dmarlowe69/Hayes-Targets/Flight Data Reduction/Excel WorkBook/tlx8.bmp

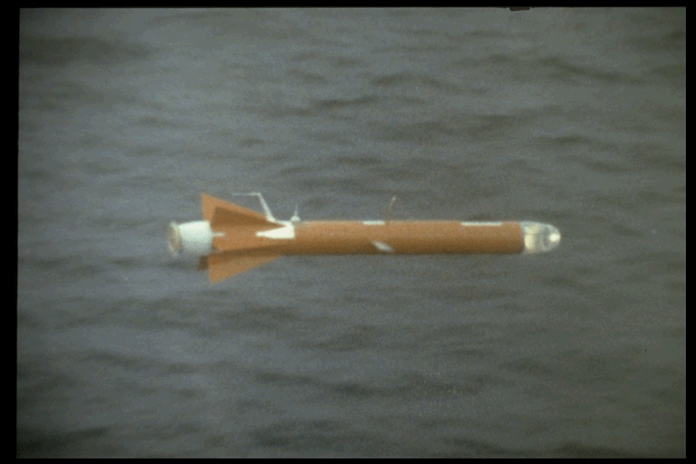
Flight Data Reduction/Excel WorkBook/tlx8.bmp
