dmarlowe69/Hayes-Targets/Quick C/README.md

Cable Design and other utilities written in Microsoft Quick C

Denton Marlowe
November 2016
