dmarlowe69/Hayes-Targets/QBASIC/README.md

Cable Design and other utilities written in Microsoft Quick Basic

Denton Marlowe
November 2016
