dmarlowe69/Hayes-Targets/RCA Boards/README.md

When RCA sold off the COSMAC system to a company called MATRIX
which dropped the line in the early 90's. Hayes Targets was the only
customer for the system so we bought the rights to manufacture the
boards. The CPU, A/D and custom two card back plane are here in old
Gerber (RS-274X) format.

the following link as an online viewer that will work with these files.

http://circuitpeople.com/

Denton Marlowe
November 2016
