dmarlowe69/Hayes-Targets/RCA Boards/AD/2468366/README

ATTN: CIRTECH
FROM: INFINITE GRAPHICS INC.

     HERE IS THE DATA FOR P/N 2468366.  THE DATA IS IN RS274X GERBER
FORMAT.  IF YOU HAVE ANY QUESTIONS PLEASE CALL US. (714)975-0765.
