dmarlowe69/Hayes-Targets/RCA Boards/CPU/2468349/README

ATTN: CIRTECH
FROM: INFINITE GRAPHICS INC.

     HERE IS THE DATA FOR P/N 2468349.   DATA IS IN RS274X GERBER.
IF YOU HAVE ANY QUESTIONS PLEASE CALL US. (714)975-0765.

8349L1   =  LAYER 1
8349L2   =  LAYER 2
8349SM   =  SOLDERMASK
8349SS   =  SILKSCREEN
