dmarlowe69/Hayes-Targets/TLXEXCEL/TLX_DATA_Report.xls

time | hrtime | rebl | alt_dev | fs_alt | ex_alt | wing | aux | accel | batt | rcvy/fly | prog | ok
0 | 0 | 1 | 49.609375 | 1166.666626 | 99.609375 | -8.0625 | 0.097656 | 0.96875 | 28.4375 | 0 | 0 | 0
0.10989 | 0.121429 | 1 | 49.609375 | 1166.666626 | 99.609375 | -8.023438 | 0.097656 | 1.007813 | 28.300781 | 0 | 0 | 1
0.21978 | 0.23441 | 1 | 49.21875 | 1166.666626 | 99.609375 | -8.101563 | 0.097656 | 1.023438 | 28.4375 | 0 | 0 | 1
0.32967 | 0.351177 | 1 | 49.609375 | 1166.666626 | 99.609375 | -8.0625 | 0.097656 | 0.984375 | 28.4375 | 0 | 0 | 1
0.43956 | 0.454081 | 1 | 49.21875 | 1145.833374 | 99.609375 | -8.0625 | 0.097656 | 0.984375 | 28.300781 | 0 | 0 | 0
0.549451 | 0.565154 | 1 | 49.21875 | 1145.833374 | 99.609375 | -8.0625 | 0.097656 | 1 | 28.4375 | 0 | 0 | 0
0.659341 | 0.677065 | 1 | 49.21875 | 1145.833374 | 99.609375 | -8.0625 | 0.117188 | 1.007813 | 28.4375 | 0 | 0 | 0
0.824176 | 0.821932 | 1 | 49.21875 | 1145.833374 | 99.609375 | -8.0625 | 0.117188 | 1 | 28.300781 | 0 | 0 | 1
0.934066 | 0.934156 | 1 | 49.21875 | 1145.833374 | 99.609375 | -8.101563 | 0.097656 | 0.992188 | 28.300781 | 0 | 0 | 1
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
