dmarlowe69/Hayes-Targets/DevPics/HRT2.jpg

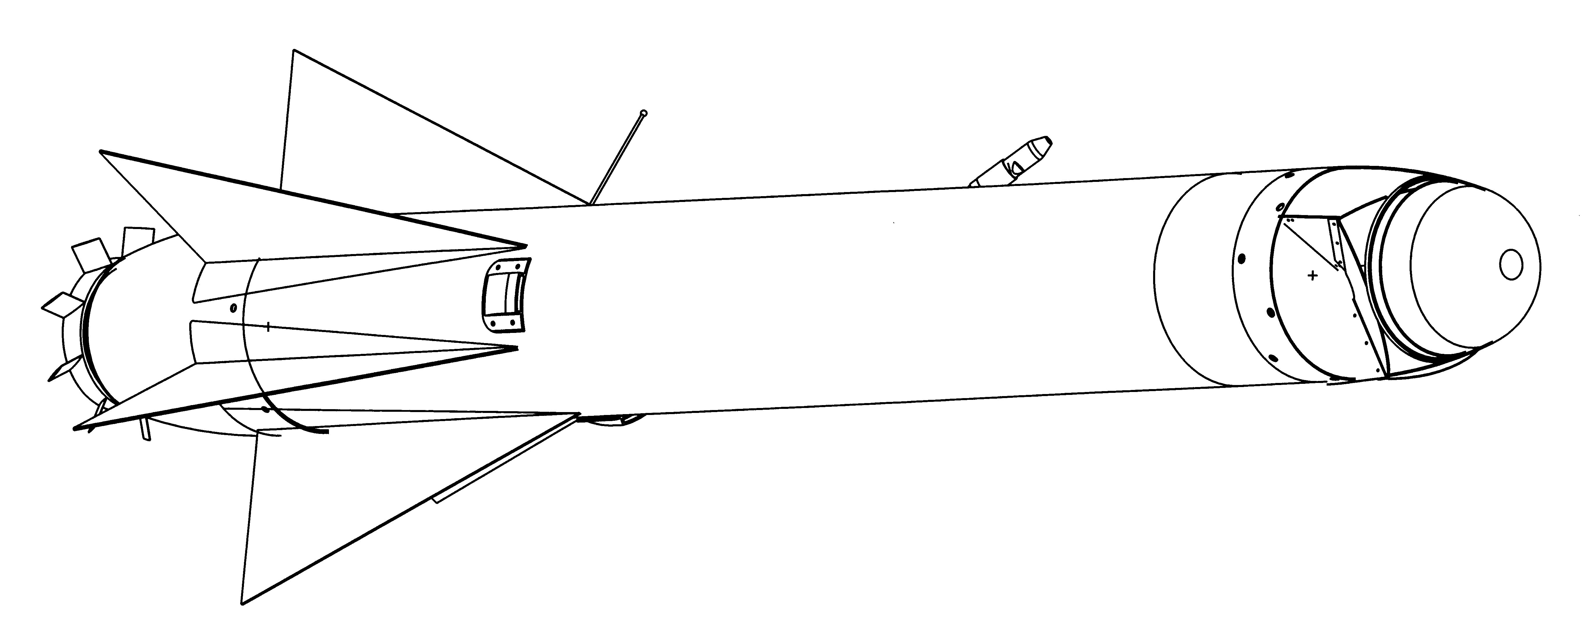
DevPics/HRT2.jpg
