dmarlowe69/Hayes-Targets/DevPics/HRT.jpg

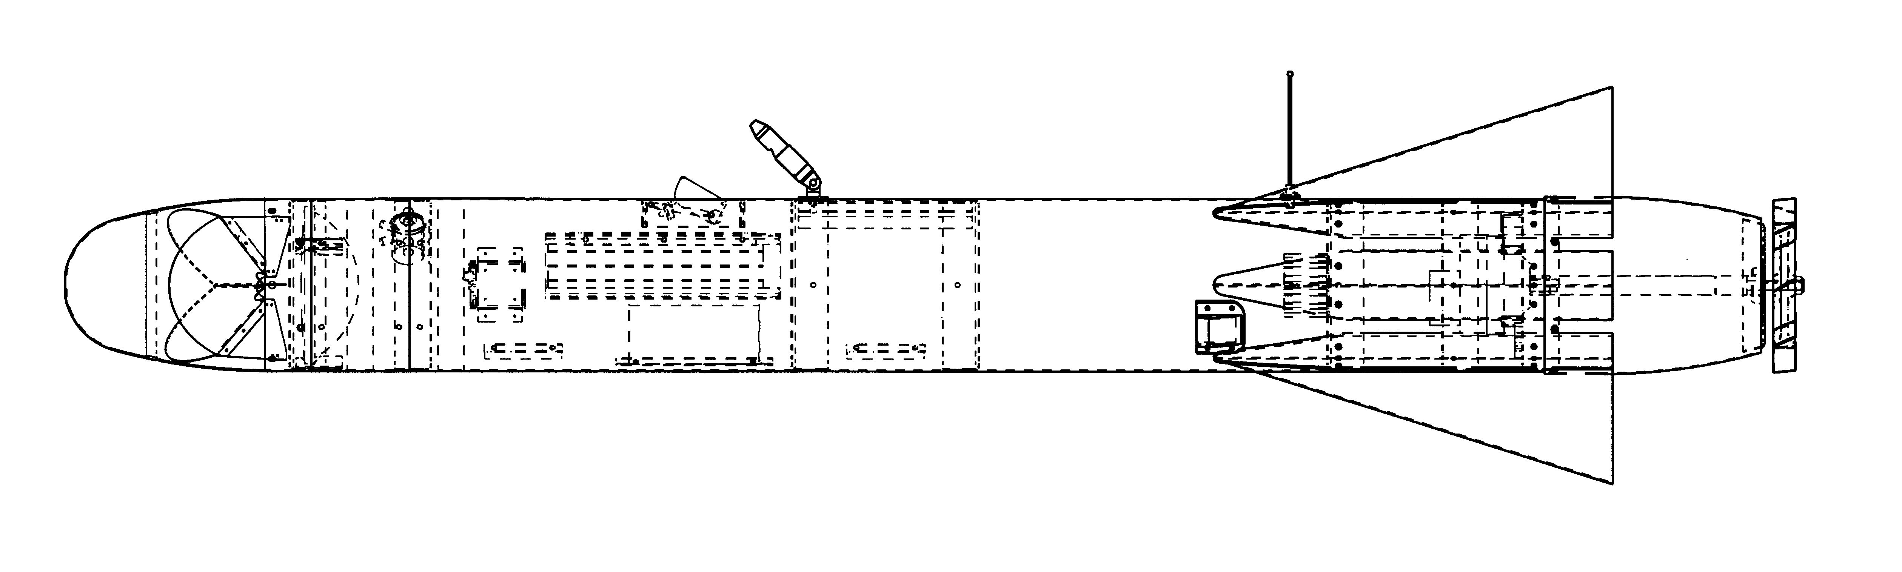
DevPics/HRT.jpg
