dmarlowe69/Hayes-Targets/DevPics/TLX.jpg

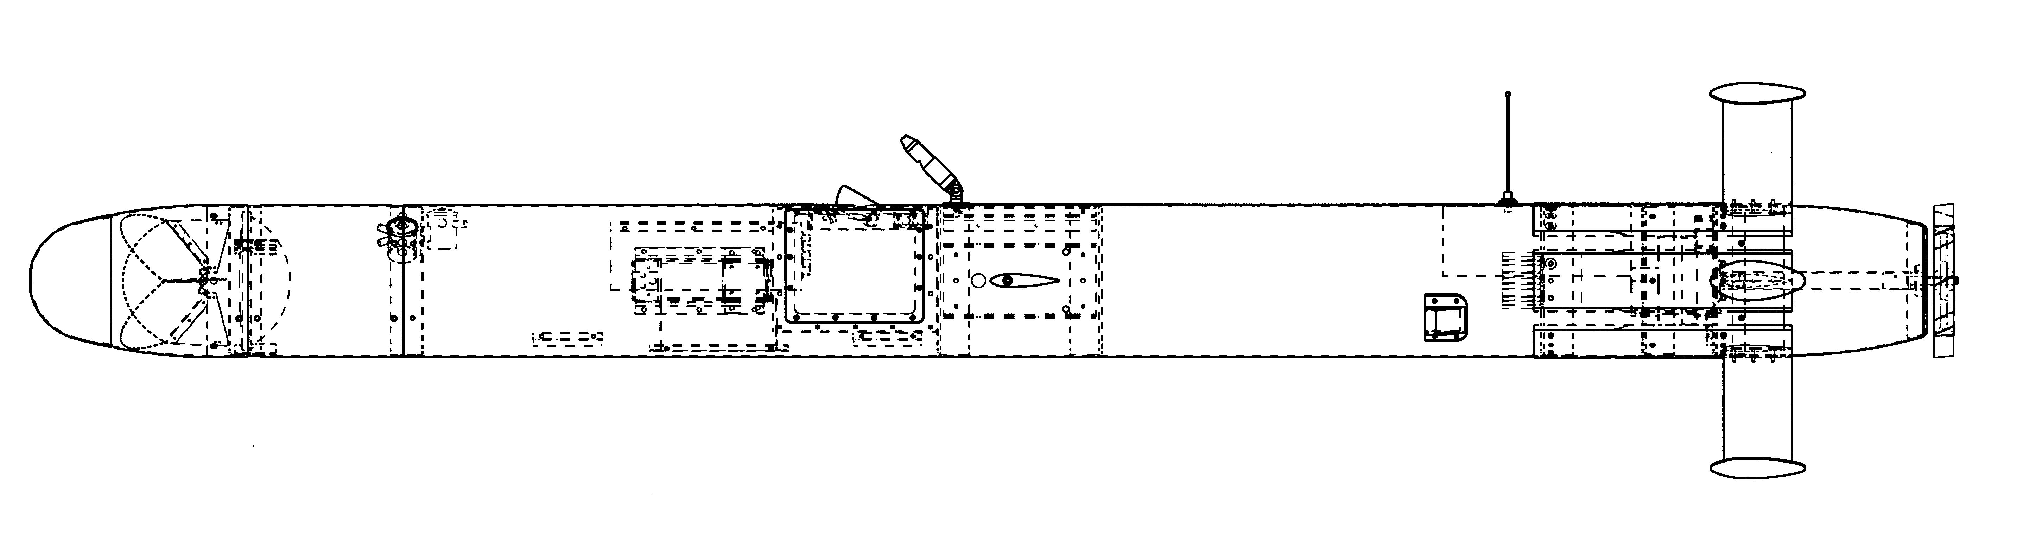
DevPics/TLX.jpg
