dmarlowe69/Hayes-Targets/DevPics/TLXIR.jpg

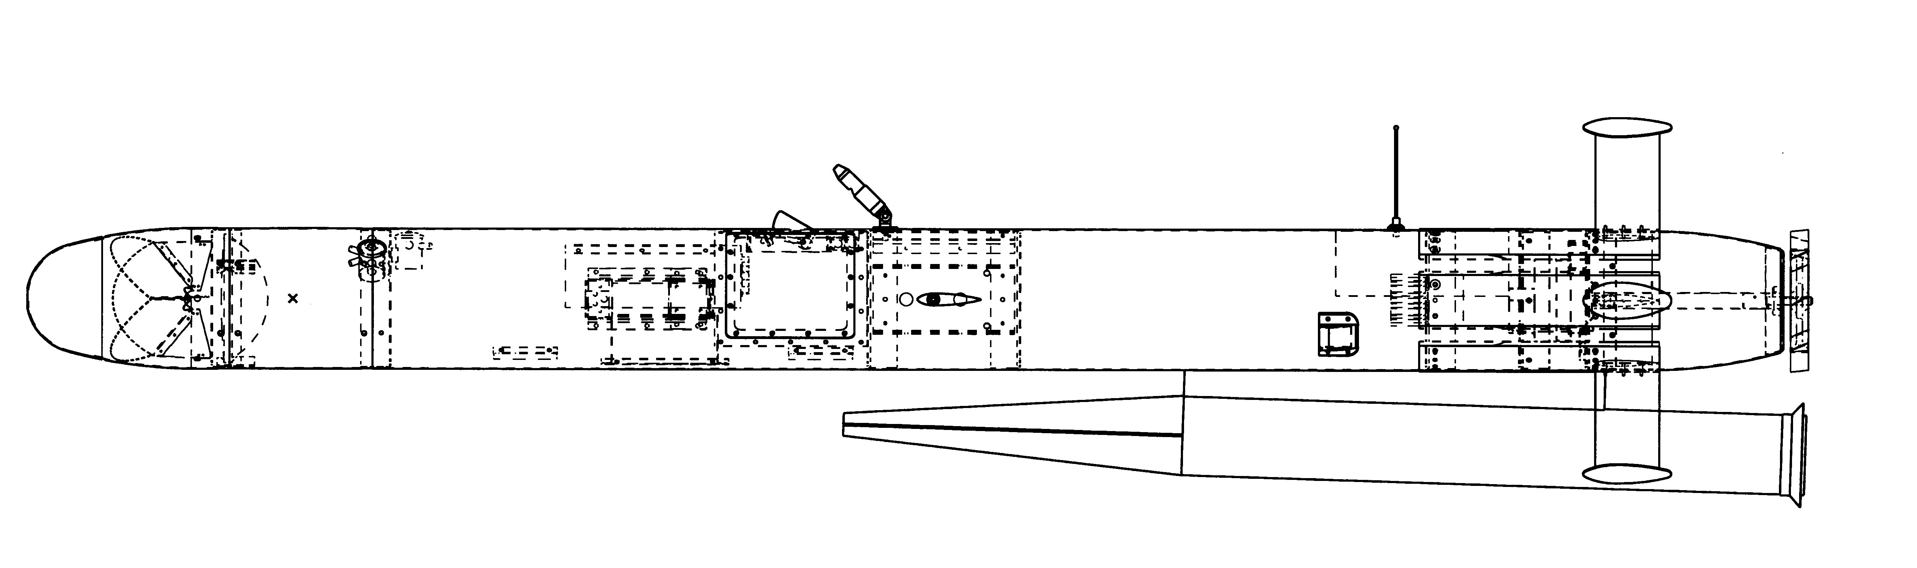
DevPics/TLXIR.jpg
