dmarlowe69/Hayes-Targets/DevPics/TLXSCOR1.jpg

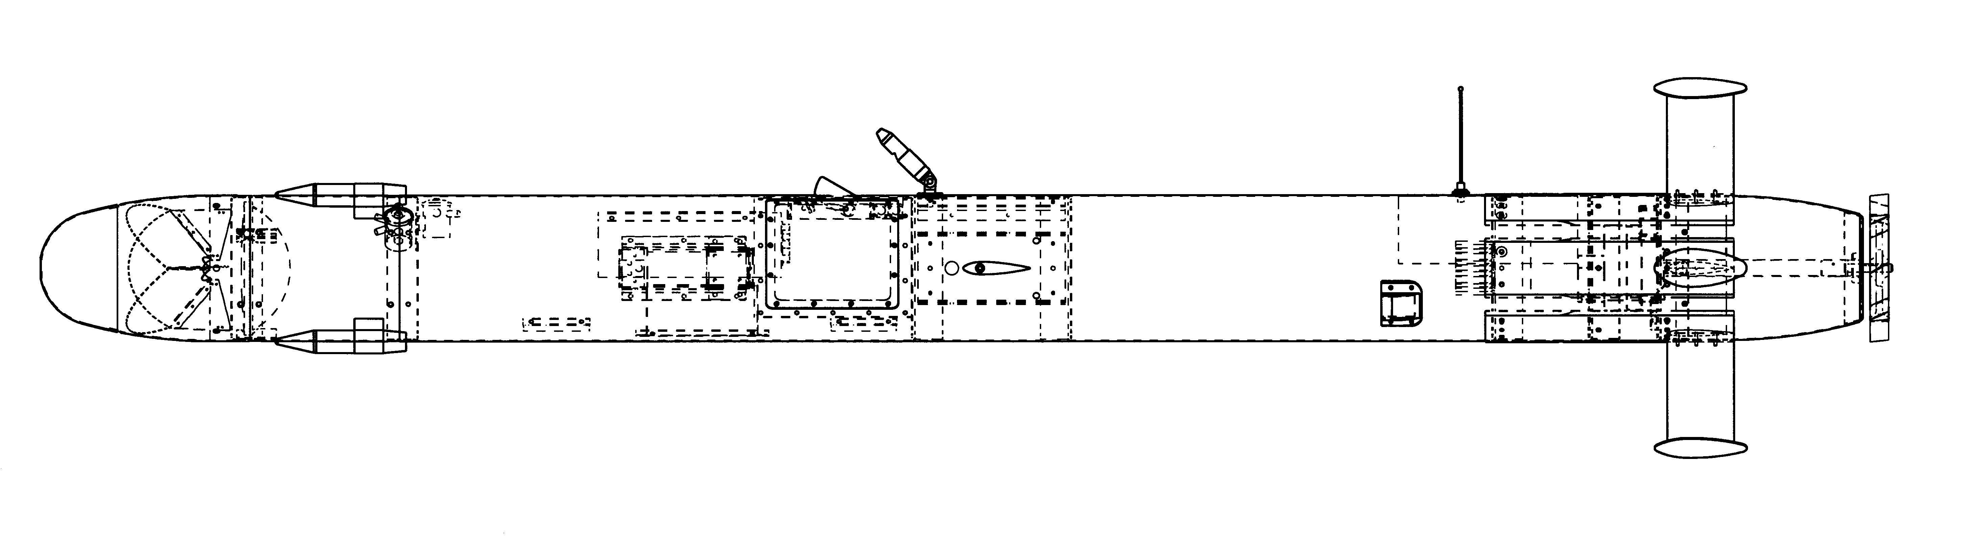
DevPics/TLXSCOR1.jpg
