dmarlowe69/Hayes-Targets/DevPics/TLXSCOR.jpg

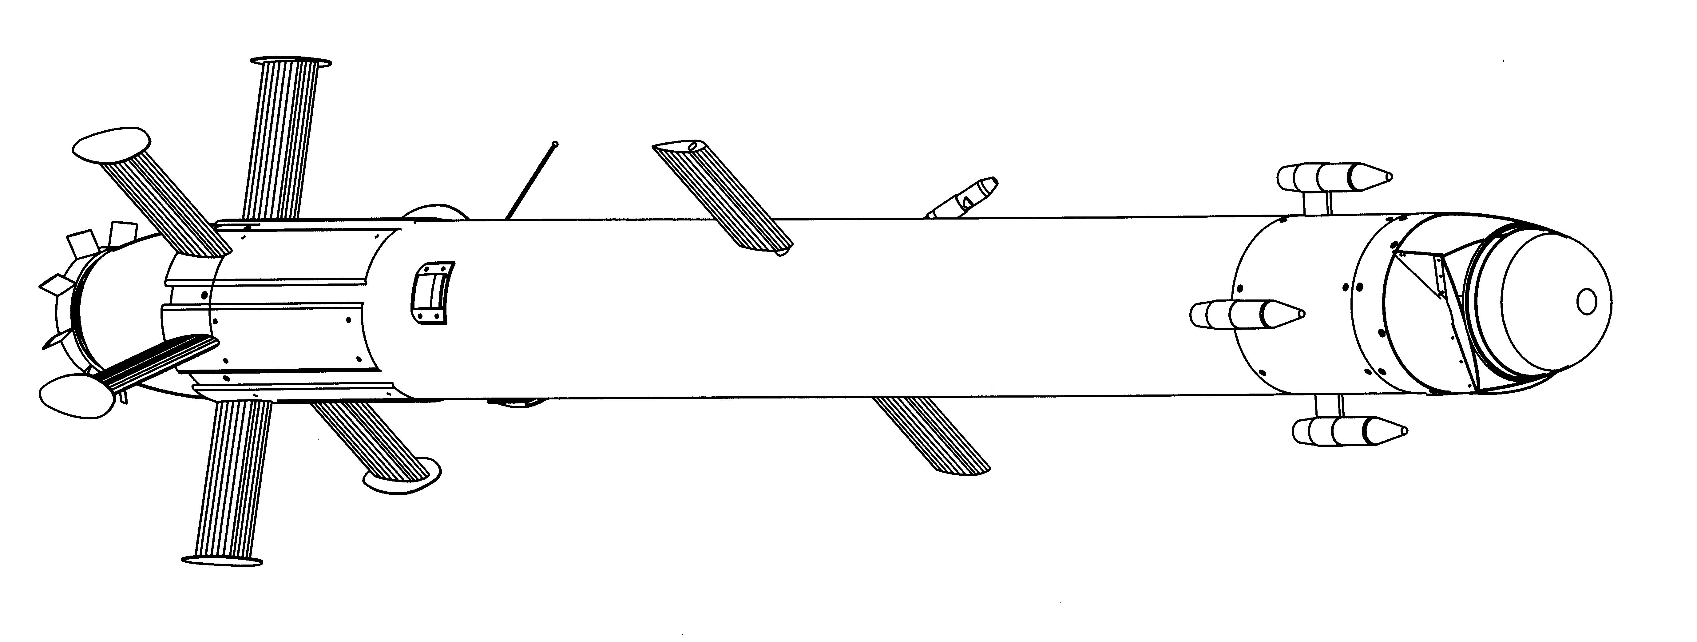
DevPics/TLXSCOR.jpg
