dmarlowe69/Hayes-Targets/Meggitt/M box cmyk.BMP

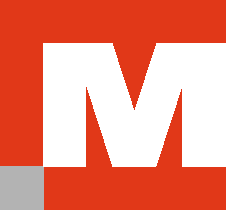
Meggitt/M box cmyk.BMP
