dmarlowe69/Hayes-Targets/TLX DOCS/Computer/0011117.xls

I | C |  | FED MFG |  |  | UN | QTY | QTY | NEXT HIGHER
N | L | PART NUMBER | CODE | DESCRIPTION | PIECE SIZE | IS | NHA | EI | ASSEMBLY | REMARKS
1 | A | 001-1117-9-G |  | COMPUTER ASSY |  | EA | 1 | 1 | 001-3055-9
2 | A | 001-1114-9-M |  | COMPUTER SUBASSY |  | EA | 1 | 1 | 001-1117-9
3 | A | 001-1103-9-F |  | FRAME ASSY |  | EA | 1 | 1 | 001-1114-9
4 | S | 001-1167-1-B |  | BAR |  | EA | 2 | 2 | 001-1103-9
4 | S | 001-1167-3-B |  | BAR |  | EA | 8 | 8 | 001-1103-9
4 | S | 001-1167-5-B |  | BAR |  | EA | 2 | 2 | 001-1103-9
4 | S | 001-1167-7-B |  | BAR |  | EA | 1 | 1 | 001-1103-9
4 | S | 001-1167-11-B |  | BAR |  | EA | 2 | 2 | 001-1103-9
4 | S | 001-1167-13-B |  | BAR |  | EA | 1 | 1 | 001-1103-9
4 | A | 001-1180-9-B |  | COVER ASSY |  | EA | 1 | 1 | 001-1103-9
5 | D | 001-1104-3-J |  | COVER |  | EA | 1 | 1 | 001-1180-9
6 | R | 6061-T6 .050 250/11 |  | SHEET | .854X1.167 | SF | .997 | .997 | 001-1104-3
5 | D | 001-1112-1-B |  | SPACER |  | EA | 4 | 4 | 001-1180-9
6 | R | 6061-T6 .050 250/11 |  | SHEET | .042X.583 | SF | .024 | .096 | 001-1112-1
5 | D | 001-1112-3-B |  | SPACER |  | EA | 2 | 2 | 001-1180-9
6 | R | 6061-T6 .050 250/11 |  | SHEET | .042X.271 | SF | .011 | .022 | 001-1112-3
5 | D | 001-1113-C |  | SLIDE |  | EA | 2 | 2 | 001-1180-9
6 | P | PRD-6875 | 07556 | CARD GUIDE |  | EA | .5 | 1 | 001-1113
5 | P | MS20470A4-5 |  | RIVET |  | EA | 12 | 12 | 001-1180-9
5 | P | PRD-6875 | 07556 | CARD GUIDE |  | EA | 4 | 4 | 001-1180-9
4 | P | MS35206-214 |  | SCREW |  | EA | 26 | 26 | 001-1103-9
4 | P | MS20470AD3-7 |  | RIVET |  | EA | 26 | 26 | 001-1103-9
4 | R | RTV-102 | 01139 | ADHESIVE |  | TU | .01 | .01 | 001-1103-9
3 | A | 001-1119-9-K |  | PC BOARD ASSY |  | EA | 1 | 1 | 001-1114-9
4 | S | 001-1120-E |  | PC BOARD |  | EA | 1 | 1 | 001-1119-9
4 | P | PKA2314P | 72347 | POWER SUPPLY |  | EA | 1 | 1 | 001-1119-9
4 | P | CSR13F476KM |  | CAPACITOR,47UF,35VDC |  | EA | 1 | 1 | 001-1119-9
4 | P | 109D827X9015T2 | 56289 | CAPACITOR,820UF,15DC |  | EA | 1 | 1 | 001-1119-9
4 | T | 001-5092 |  | PROCEDURE,TEST |  | EA | 1 | 1 | 001-1119-9
3 | A | 001-1174-9-D |  | CABLE ASSY, A/D BD. |  | EA | 1 | 1 | 001-1114-9
4 | R | 843-191-2801-020 | 02660 | CABLE,RIBBON |  | FT | .5 | .5 | 001-1174-9
4 | P | 842-812-2003-134 | 02660 | SOCKET |  | EA | 2 | 2 | 001-1174-9
4 | P | 842-812-1003-134 | 02660 | SOCKET |  | EA | 1 | 1 | 001-1174-9
4 | T | 001-1116-D |  | SCHEMATIC |  | EA | 1 | 1 | 001-1174-9
3 | S | 001-1188-9-H |  | INTERFACE BOARD ASSY |  | EA | 1 | 1 | 001-1114-9
4 | T | 001-1233-D |  | PC BOARD |  | EA | 1 | 1 | 001-1188-9
4 | T | 001-1234-A |  | SCHEMATIC |  | EA | 1 | 1 | 001-1188-9
4 | T | STD-0155 |  | PROCEDURE,ESD |  | EA | 1 | 1 | 001-1188-9
4 | T | 001-5095 |  | TEST PROCEDURE |  | EA | 1 | 1 | 001-1188-9
3 | A | 001-1218-9-H |  | 1805 CPU ASSY |  | EA | 1 | 1 | 001-1114-9
4 | A | 001-1224-9-K |  | EPROM ASSY |  | EA | 1 | 1 | 001-1218-9
5 | P | MD2716M |  | EPROM |  | EA | 1 | 1 | 001-1224-9
5 | D | 001-1224-1-K |  | DECAL |  | EA | 1 | 1 | 001-1224-9
6 | R | B-61H-250 | 96707 | TYVEX |  | RL | .01 | .01 | 001-1224-1
5 | T | STD-0155 |  | PROCEDURE,ESD |  | EA | 1 | 1 | 001-1224-9
5 | T | 001-5097-A |  | PROCEDURE,TEST |  | EA | 1 | 1 | 001-1224-9
5 | T | 001-1331-A |  | OBJECT CODE,EPROM |  | EA | 1 | 1 | 001-1224-9
4 | P | MB606 | MATRIC | 1805 CPU BOARD |  | EA | 1 | 1 | 001-1218-9
4 | R | RTV-162 | 01139 | ADHESIVE |  | TU | .01 | .01 | 001-1218-9
4 | X | 001-1224-19-K |  | EPROM ASSY |  | EA | 1 | 1 | 001-1218-9
5 | X | MD2716M |  | EPROM |  | EA | 1 | 1 | 001-1224-9
5 | X | 001-1224-3-K |  | DECAL |  | EA | 1 | 1 | 001-1224-9
6 | X | B-61H-250 | 96707 | TYVEX |  | RL | .01 | .01 | 001-1224-1
5 | T | STD-0155 |  | PROCEDURE,ESD |  | EA | 1 | 1 | 001-1224-9
5 | T | 001-5097-A |  | PROCEDURE,TEST |  | EA | 1 | 1 | 001-1224-9
5 | T | 001-1440 |  | OBJECT CODE,EPROM |  | EA | 1 | 1 | 001-1224-9
4 | T | 001-5098 |  | PROCEDURE,TEST |  | EA | 1 | 1 | 001-1218-9
3 | D | 001-1219-D |  | TM ENCODER |  | EA | 1 | 1 | 001-1114-9
4 | S | 001-5043-C |  | ENCODER BOARD ASSY |  | EA | 1 | 1 | 001-1219
4 | T | STD-0155 |  | PROCEDURE,ESD |  | EA | 1 | 1 | 001-1219
4 | T | 001-5094 |  | PROCEDURE,TEST |  | EA | 1 | 1 | 001-1219
3 | R | M16878/1BEE9 |  | WIRE,24,WHITE |  | FT | 140 | 140 | 001-1114-9
3 | P | MS35206-217 |  | SCREW |  | EA | 12 | 12 | 001-1114-9
3 | D | 001-1424-A |  | A/D-D/A BOARD MOD |  | EA | 1 | 1 | 001-1114-9
4 | P | MB654A | MATRIC | A/D-D/A CONVERTER |  | EA | 1 | 1 | 001-1424
4 | R | RTV-162 | 01139 | ADHESIVE |  | TU | .01 | .01 | 001-1424
4 | T | 001-5096 |  | PROCEDURE,TEST |  | EA | 1 | 1 | 001-1424
3 | S | 001-1173 |  | BACKPLANE,COMPUTER |  | EA | 1 | 1 | 001-1114-9
3 | S | 001-5042-D |  | DECODER BOARD ASSY |  | EA | 1 | 1 | 001-1114-9
4 | T | 001-5093 |  | TEST PROCEDURE |  | EA | 1 | 1 | 001-5042
3 | P | 143-022-01-(110) | 13511 | CONNECTOR |  | EA | 3 | 3 | 001-1114-9
3 | P | 50-44SN-9 | 71785 | CONNECTOR |  | EA | 1 | 1 | 001-1114-9
3 | P | 583616-4 | 00779 | PIN |  | EA | 19 | 19 | 001-1114-9
3 | P | 583717-5 | 00779 | CONNECTOR |  | EA | 1 | 1 | 001-1114-9
3 | R | 22231 | 05972 | THREAD LOCK |  | BT | .01 | .01 | 001-1114-9
3 | T | 001-1116-D |  | SCHEMATIC |  | EA | 1 | 1 | 001-1114-9
3 | T | 001-1175-C |  | WIRE LIST |  | EA | 1 | 1 | 001-1114-9
3 | T | STD-0155 |  | PROCEDURE,ESD |  | EA | 1 | 1 | 001-1114-9
3 | T | 001-5055-H |  | PROCEDURE,TEST |  | EA | 1 | 1 | 001-1114-9
2 | A | 001-1115-9-G |  | TRAY ASSY |  | EA | 1 | 1 | 001-1117-9
3 | D | 001-1115-1-G |  | TRAY |  | EA | 1 | 1 | 001-1115-9
4 | R | 6061-T6 .050 250/11 |  | SHEET | .583X.833 | SF | .486 | .486 | 001-1115-1
3 | P | 9655-08 | 19738 | NUTSERT |  | EA | 6 | 6 | 001-1115-9
2 | A | 001-1169-9-J |  | COVER/EXTENSION ASSY |  | EA | 1 | 1 | 001-1117-9
3 | D | 001-1176-1-B |  | COVER,TOP |  | EA | 1 | 1 | 001-1169-9
4 | R | 6061-T6 .050 250/11 |  | SHEET | .104X.417 | SF | .043 | .043 | 001-1176-1
3 | D | 001-1176-3-B |  | COVER,SIDE |  | EA | 1 | 1 | 001-1169-9
4 | R | 6061-T6 .050 250/11 |  | SHEET | .104X.333 | SF | .035 | .035 | 001-1176-3
3 | S | 001-1177-1-A |  | BAR |  | EA | 2 | 2 | 001-1169-9
3 | S | 001-1177-11-A |  | BAR |  | EA | 1 | 1 | 001-1169-9
3 | S | 001-1177-13-A |  | BAR |  | EA | 1 | 1 | 001-1169-9
3 | S | 001-1177-14-A |  | BAR |  | EA | 1 | 1 | 001-1169-9
3 | S | 001-1177-3-A |  | BAR |  | EA | 1 | 1 | 001-1169-9
3 | S | 001-1177-5-A |  | BAR |  | EA | 1 | 1 | 001-1169-9
3 | S | 001-1177-7-A |  | BAR |  | EA | 1 | 1 | 001-1169-9
3 | A | 001-1178-9-D |  | COVER ASSY |  | EA | 1 | 1 | 001-1169-9
4 | A | 001-1168-9-B |  | BUMPER ASSY |  | EA | 2 | 2 | 001-1178-9
5 | D | 001-1168-1-B |  | BUMPER |  | EA | 1 | 2 | 001-1168-9
6 | R | 6061-T6 .032 250/11 |  | SHEET | .042X.177 | SF | .008 | .016 | 001-1168-1
5 | D | 001-1168-3-B |  | INSULATION |  | EA | 1 | 2 | 001-1168-9
6 | R | NES-41B-.25A | 72781 | SHEET,SPONGE RUBBER | .042X.063 | SF | .003 | .006 | 001-1168-3
4 | D | 001-1104-11-J |  | COVER |  | EA | 1 | 1 | 001-1178-9
5 | R | 6061-T6 .050 250/11 |  | SHEET | .417X.5 | SF | .209 | .209 | 001-1104-11
4 | P | MS20470AD3-4 |  | RIVET |  | EA | 4 | 4 | 001-1178-9
4 | P | 1201-052 | 51406 | FILTER & HARDWARE |  | EA | 21 | 21 | 001-1178-9
4 | P | 856 | 91833 | TERMINAL STRIP |  | EA | 1 | 1 | 001-1178-9
4 | P | MS20470AD3-3 |  | RIVET |  | EA | 2 | 2 | 001-1178-9
3 | A | 001-1181-9-C |  | COVER ASSY |  | EA | 1 | 1 | 001-1169-9
4 | D | 001-1104-1-J |  | COVER |  | EA | 1 | 1 | 001-1181-9
5 | R | 6061-T6 .050 250/11 |  | SHEET | .417X.5 | SF | .209 | .209 | 001-1104-1
4 | P | MS21083N04 |  | NUT |  | EA | 32 | 32 | 001-1181-9
4 | P | MS3112E10-6S |  | CONNECTOR |  | EA | 1 | 1 | 001-1181-9
4 | P | MS3112E10-6SW |  | CONNECTOR |  | EA | 1 | 1 | 001-1181-9
4 | P | MS3112E10-98S |  | CONNECTOR |  | EA | 1 | 1 | 001-1181-9
4 | P | MS3112E14-19S |  | CONNECTOR |  | EA | 1 | 1 | 001-1181-9
4 | P | MS3112E8-33S |  | CONNECTOR |  | EA | 1 | 1 | 001-1181-9
4 | P | MS3112E8-4S |  | CONNECTOR |  | EA | 1 | 1 | 001-1181-9
4 | P | MS3112E8-4SW |  | CONNECTOR |  | EA | 1 | 1 | 001-1181-9
4 | P | MS35206-214 |  | SCREW |  | EA | 32 | 32 | 001-1181-9
4 | P | PT02E-8-2P | 77820 | CONNECTOR |  | EA | 1 | 1 | 001-1181-9
4 | P | 10-101949-10 | 77820 | GASKET |  | EA | 3 | 3 | 001-1181-9
4 | P | 10-101949-14 | 77820 | GASKET |  | EA | 1 | 1 | 001-1181-9
4 | P | 10-101949-8 | 77820 | GASKET |  | EA | 4 | 4 | 001-1181-9
4 | P | 10-101960-145 | 77820 | CAP,PROTECTION |  | EA | 1 | 1 | 001-1181-9
4 | P | 10-101960-105 | 77820 | CAP,PROTECTION |  | EA | 1 | 1 | 001-1181-9
4 | P | 7326 | 91833 | LUG,SOLDER |  | EA | 1 | 1 | 001-1181-9
3 | P | MS20470AD3-7 |  | RIVET |  | EA | 28 | 28 | 001-1169-9
3 | P | MS35206-214 |  | SCREW |  | EA | 38 | 38 | 001-1169-9
3 | R | M16878/1BEE9 |  | WIRE,24,WHITE |  | FT | 45 | 45 | 001-1169-9
3 | P | RCR07G562J |  | RESISTOR |  | EA | 1 | 1 | 001-1169-9
3 | R | FIT-221-3/32Y | 92194 | SHRINK TUBING |  | FT | .17 | .17 | 001-1169-9
3 | R | RTV-102 | 01139 | ADHESIVE |  | TU | .01 | .01 | 001-1169-9
3 | T | 001-1175-C |  | WIRE LIST |  | EA | 1 | 1 | 001-1169-9
3 | T | 001-1116-D |  | SCHEMATIC |  | EA | 1 | 1 | 001-1169-9
2 | A | 001-1179-9-C |  | COVER ASSY |  | EA | 1 | 1 | 001-1117-9
3 | D | 001-1104-7-J |  | COVER |  | EA | 1 | 1 | 001-1179-9
4 | R | 6061-T6 .050 250/11 |  | SHEET | .323X.427 | SF | .146 | .146 | 001-1104-7
3 | P | MS20470AD3-4 |  | RIVET |  | EA | 2 | 2 | 001-1179-9
3 | D | 001-1179-1-C |  | SHEET,RUBBER |  | EA | 2 | 2 | 001-1179-9
4 | R | NES-41B-.75A |  | SHEET,SPONGE RUBBER | .053X.250 | SF | .013 | .026 | 001-1179-1
3 | D | 001-1179-3-C |  | ANGLE |  | EA | 1 | 1 | 001-1179-9
4 | R | 6061-T6 .032 250/11 |  | SHEET | .063X.125 | SF | .008 | .008 | 001-1179-3
3 | R | 224 |  | TAPE,DUCT .75IN |  | FT | .1 | .1 | 001-1179-3
2 | P | MS35206-214 |  | SCREW |  | EA | 72 | 72 | 001-1117-9
2 | D | 001-1155-2-D |  | DECAL |  | EA | 1 | 1 | 001-1117-9
3 | R | 3R994 | XEROX | DRAFTING FILM |  | SF | .03 | .03 | 001-1155-2
2 | T | 001-1116-D |  | SCHEMATIC |  | EA | 1 | 1 | 001-1117-9
2 | T | 001-1175-C |  | WIRE LIST |  | EA | 1 | 1 | 001-1117-9
2 | T | 001-5055-H |  | PROCEDURE,TEST |  | EA | 1 | 1 | 001-1117-9
2 | T | STD-0155 |  | PROCEDURE,ESD |  | EA | 1 | 1 | 001-1117-9
