dmarlowe69/Hayes-Targets/TLX DOCS/JohnsonRF/0010378.xls

I | C |  | FED MFG |  |  | UN | QTY | QTY | NEXT HIGHER
N | L | PART NUMBER | CODE | DESCRIPTION | PIECE SIZE | IS | NHA | EI | ASSEMBLY | REMARKS
1 | A | 001-0378-9-D |  | BATTERY PACK |  | EA | 1 | 1 | 001-3055-9
2 | P | MS21083N04 |  | NUT |  | EA | 8 | 8 | 001-0378-9
2 | P | MS35206-214 |  | SCREW |  | EA | 8 | 8 | 001-0378-9
2 | P | PT02E-8-4S | 77820 | CONNECTOR |  | EA | 1 | 1 | 001-0378-9
2 | P | 112A | 82389 | JACK |  | EA | 1 | 1 | 001-0378-9
2 | P | PT02E-8-2P | 77820 | CONNECTOR |  | EA | 1 | 1 | 001-0378-9
2 | P | 1682-0412 | 19738 | RIVET |  | EA | 4 | 4 | 001-0378-9
2 | P | 9655-08 | 19738 | NUTSERT |  | EA | 6 | 6 | 001-0378-9
2 | P | MS24693-S25 |  | SCREW |  | EA | 2 | 2 | 001-0378-9
2 | A | 001-0375-1-A |  | BATTERY PACK |  | EA | 1 | 1 | 001-0378-9
3 | D | 001-0375-3-A |  | SIDE |  | EA | 2 | 2 | 001-0375-1
4 | R | 950-109 | 1AT51 | SHEET | .125X.542 | SH | .02 | .04
3 | D | 001-0375-5-A |  | COVER |  | EA | 2 | 2 | 001-0375-1
4 | R | 950-109 | 1AT51 | SHEET | .233X.542 | SH | .03 | .06
3 | R | RTV-102 | 01139 | ADHESIVE |  | TU | .01 | .01 | 001-0375-1
3 | D | 001-0375-7-A |  | END |  | EA | 2 | 2 | 001-0375-1
4 | R | 950-109 | 1AT51 | SHEET | .125X.183 | SF | .006 | .012
3 | S | 001-5048-A |  | BATTERY PACK |  | EA | 1 | 1 | 001-0375-1
2 | D | 001-0374-D |  | BRACKET |  | EA | 1 | 1 | 001-0378-9
3 | R | 6061-T6 .050 250/11 |  | SHEET | .193X.417 | SF | .080 | .08 | 001-0374
2 | D | 001-0373 |  | BRACKET |  | EA | 1 | 1 | 001-0378-9
3 | R | 6061-T6 .050 250/11 |  | SHEET | .073X.354 | SF | .026 | .026 | 001-0373
2 | D | 001-0372-C |  | BRACKET |  | EA | 1 | 1 | 001-0378-9
3 | R | 6061-T6 .050 250/11 |  | SHEET | .604X.718 | SF | .434 | .434 | 001-0372
2 | P | 1N5408 |  | DIODE |  | EA | 2 | 2 | 001-0378-9
2 | P | RCR32G390K |  | RESISTOR |  | EA | 1 | 1 | 001-0378-9
2 | P | 856 | 91833 | TERMINAL STRIP |  | EA | 1 | 1 | 001-0378-9
2 | P | 1506-102 | 83330 | TIP,JACK,RED |  | EA | 1 | 1 | 001-0378-9
2 | P | 1506-103 | 83330 | TIP,JACK,BLACK |  | EA | 1 | 1 | 001-0378-9
2 | P | MS35333-40 |  | WASHER |  | EA | 2 | 2 | 001-0378-9
2 | R | M16878/1BFE9 |  | WIRE,22,WHITE |  | FT | 1 | 1 | 001-0378-9
2 | P | MS20470A3-3 |  | RIVET |  | EA | 2 | 2 | 001-0378-9
2 | P | MS21083N06 |  | NUT |  | EA | 2 | 2 | 001-0378-9
