dmarlowe69/Hayes-Targets/TLX DOCS/JohnsonRF/0010384.xls

I | C |  | FED MFG |  |  | UN | QTY | QTY | NEXT HIGHER
N | L | PART NUMBER | CODE | DESCRIPTION | PIECE SIZE | IS | NHA | EI | ASSEMBLY | REMARKS
2 | A | 001-0384-9-D |  | LAUNCH SWITCH ASSY |  | EA | 1 | 1 | 001-3063-9
3 | D | 001-0387-A |  | BRACKET |  | EA | 1 | 1 | 001-0384-9
4 | R | 6061-T6 .063 250/11 |  | SHEET | .125X.604 | SF | .076 | .076 | 001-0387
3 | D | 001-0127-D |  | BRACKET |  | EA | 1 | 1 | 001-0384-9
4 | R | 6061-T6 .063 250/11 |  | SHEET | .167X.417 | SF | .07 | .07 | 001-0127
3 | S | 001-0128-C |  | ROD |  | EA | 1 | 1 | 001-0384-9
3 | D | 001-0129-B |  | SPACER |  | EA | 2 | 2 | 001-0384-9
4 | P | P-577-M05-F02-832 | 04729 | SPACER |  | EA | 1 | 2 | 001-0129
3 | A | 001-0385-9-A |  | SWITCH ASSY |  | EA | 2 | 2 | 001-0384-9
4 | P | 111SM2-T | 91929 | SWITCH |  | EA | 1 | 2 | 001-0385-9
4 | R | M16878/1BGE0 |  | WIRE,20,BLACK |  | FT | .583 | 1.1672 | 001-0385-9
4 | R | M16878/1BGE2 |  | WIRE,20,RED |  | FT | .583 | 1.1672 | 001-0385-9
3 | A | 001-0238-9-A |  | ACTUATOR ASSY |  | EA | 1 | 1 | 001-0384-9
4 | D | 001-0241-1-A |  | ACTUATOR |  | EA | 1 | 1 | 001-0238-9
4 | D | 001-0126-1-H |  | ACTUATOR |  | EA | 1 | 1 | 001-0126-9
5 | R | 6061-T6 .187 250/11 |  | PLATE | .167X.33 | SF | .056 | .056 | 001-0126-1
4 | D | 001-0241-2-A |  | ACTUATOR |  | EA | 1 | 1 | 001-0238-9
4 | D | 001-0126-1-H |  | ACTUATOR |  | EA | 1 | 1 | 001-0126-9
5 | R | 6061-T6 .187 250/11 |  | PLATE | .167X.33 | SF | .056 | .056 | 001-0126-1
4 | S | 001-0128-C |  | ROD |  | EA | 1 | 1 | 001-0238-9
4 | P | MS16555-629 |  | PIN |  | EA | 1 | 1 | 001-0238-9
4 | P | MS20426AD4-9 |  | RIVET |  | EA | 1 | 1 | 001-0238-9
4 | R | 63531 | 05972 | COMPOUND,RETAINING |  | BT | .01 | .01 | 001-0238-9
4 | R | 74756 | 05972 | PRIMER |  | BT | .01 | .01 | 001-0238-9
3 | D | 001-0239 |  | SPACER |  | EA | 4 | 4 | 001-0384-9
4 | R | 6061-T6 .125 250/11 |  | SHEET | .021X.125 | SF | .003 | .012 | 001-0239
3 | P | MS20470A4-12 |  | RIVET |  | EA | 4 | 4 | 001-0384-9
3 | P | MS35206-209 |  | SCREW |  | EA | 2 | 2 | 001-0384-9
3 | P | MS35333-35 |  | WASHER |  | EA | 2 | 2 | 001-0384-9
3 | P | MS35649-222 |  | NUT |  | EA | 2 | 2 | 001-0384-9
3 | P | LE-037CD-10-MW | 84830 | SPRING |  | EA | 2 | 2 | 001-0384-9
3 | P | LWNY-002BK | 62619 | WASHER |  | EA | 4 | 4 | 001-0384-9
3 | R | 63531 | 05972 | COMPOUND,RETAINING |  | BT | .01 | .01 | 001-0384-9
3 | P | MS35206-215 |  | SCREW |  | EA | 8 | 8 | 001-0384-9
3 | P | MS21083N04 |  | NUT |  | EA | 8 | 8 | 001-0384-9
3 | P | PT00E8-2S | 77820 | CONNECTOR |  | EA | 2 | 2 | 001-0384-9
