dmarlowe69/Hayes-Targets/TLX DOCS/JohnsonRF/0013061.xls

I | C |  | FED MFG |  |  | UN | QTY | QTY | NEXT HIGHER
N | L | PART NUMBER | CODE | DESCRIPTION | PIECE SIZE | IS | NHA | EI | ASSEMBLY | REMARKS
2 | A | 001-3061-129-C |  | CABLE ASSY |  | EA | 1 | 1 | 001-3063-9
3 | R | M16878/4BKE0 |  | WIRE,14,BLACK |  | FT | 3.5 | 3.5 | 001-3061-129
3 | R | M16878/4BKE2 |  | WIRE,14,RED |  | FT | 3.5 | 3.5 | 001-3061-129
3 | P | MS3367-4-9 |  | STRAP |  | EA | 2 | 2 | 001-3061-129
3 | P | MS25036-154 |  | TERMINAL |  | EA | 1 | 1 | 001-3061-129
3 | P | MS25036-108 |  | TERMINAL |  | EA | 1 | 1 | 001-3061-129
3 | R | FIT-221-1/8Y | 92194 | SHRINK TUBING |  | FT | .125 | .125 | 001-3061-129
3 | P | 1-480318-0 | 00779 | HOUSING,SOCKET |  | EA | 1 | 1 | 001-3061-129
3 | P | 60619-4 | 00779 | SOCKET |  | EA | 2 | 2 | 001-3061-129
1 | A | 001-3061-9-C |  | CABLE ASSY |  | EA | 1 | 1 | 001-3055-9
2 | R | M16878/4BGE2 |  | WIRE,20,RED |  | FT | 2.5 | 2.5 | 001-3061-9
2 | R | M16878/4BGE0 |  | WIRE,20,BLACK |  | FT | 2.5 | 2.5 | 001-3061-9
2 | P | PT06E-8-2S | 77820 | CONNECTOR |  | EA | 1 | 1 | 001-3061-9
2 | P | MS3367-4-9 |  | STRAP |  | EA | 5 | 5 | 001-3061-9
2 | R | FIT-221-1/8Y | 92194 | SHRINK TUBING |  | FT | .167 | .167 | 001-3061-9
2 | P | MS3116E8-4P |  | CONNECTOR |  | EA | 1 | 1 | 001-3061-9
1 | A | 001-3061-19-C |  | CABLE ASSY |  | EA | 1 | 1 | 001-3055-9
2 | R | M16878/4BGE2 |  | WIRE,20,RED |  | FT | 6.5 | 6.5 | 001-3061-19
2 | R | M16878/4BGE0 |  | WIRE,20,BLACK |  | FT | 1.09 | 1.09 | 001-3061-19
2 | P | PT06E-8-2S | 77820 | CONNECTOR |  | EA | 1 | 1 | 001-3061-19
2 | P | PT06E-8-2P | 77820 | CONNECTOR |  | EA | 1 | 1 | 001-3061-19
2 | P | MS3367-4-9 |  | STRAP |  | EA | 8 | 8 | 001-3061-19
2 | R | FIT-221-1/8Y | 92194 | SHRINK TUBING |  | FT | .167 | .167 | 001-3061-19
2 | P | MS3116E8-4P |  | CONNECTOR |  | EA | 1 | 1 | 001-3061-19
1 | A | 001-3061-29-C |  | CABLE ASSY |  | EA | 1 | 1 | 001-3055-9
2 | R | M16878/4BGE2 |  | WIRE,20,RED |  | FT | 1 | 1 | 001-3061-29
2 | R | M16878/4BGE0 |  | WIRE,20,BLACK |  | FT | 1 | 1 | 001-3061-29
2 | P | PT06E-8-2S | 77820 | CONNECTOR |  | EA | 1 | 1 | 001-3061-29
2 | P | PT07E-8-2P | 77820 | CONNECTOR |  | EA | 2 | 2 | 001-3061-29
2 | P | MS3367-4-9 |  | STRAP |  | EA | 4 | 4 | 001-3061-29
2 | R | FIT-221-1/8Y | 92194 | SHRINK TUBING |  | FT | .167 | .167 | 001-3061-29
2 | P | 327583 | 00779 | SPLICE,BUTT |  | EA | 2 | 2 | 001-3061-29
1 | A | 001-3061-39-C |  | CABLE ASSY |  | EA | 1 | 1 | 001-3055-9
2 | R | M16878/4BGE8 |  | WIRE,20,GREY |  | FT | .417 | .417 | 001-3061-39
2 | R | M16878/4BGE9 |  | WIRE,20,WHITE |  | FT | 16 | 16 | 001-3061-39
2 | R | M16878/4BGE1 |  | WIRE,20,BROWN |  | FT | .417 | .417 | 001-3061-39
2 | P | MS3367-4-9 |  | STRAP |  | EA | 8 | 8 | 001-3061-39
2 | R | FIT-221-1/8Y | 92194 | SHRINK TUBING |  | FT | .167 | .167 | 001-3061-39
2 | P | 1-480318-0 | 00779 | HOUSING,SOCKET |  | EA | 1 | 1 | 001-3061-39
2 | P | 60617-4 | 00779 | SOCKET |  | EA | 2 | 2 | 001-3061-39
2 | P | MS3116E10-6PW |  | CONNECTOR |  | EA | 2 | 2 | 001-3061-39
1 | A | 001-3061-59-C |  | CABLE ASSY |  | EA | 1 | 1 | 001-3055-9
2 | R | M16878/4BGE8 |  | WIRE,20,GREY |  | FT | 2.92 | 2.92 | 001-3061-59
2 | R | M16878/4BGE1 |  | WIRE,20,BROWN |  | FT | 2.92 | 2.92 | 001-3061-59
2 | P | MS3367-4-9 |  | STRAP |  | EA | 6 | 6 | 001-3061-59
2 | R | FIT-221-1/8Y | 92194 | SHRINK TUBING |  | FT | .167 | .167 | 001-3061-59
2 | P | 66105-2 | 00779 | PIN |  | EA | 2 | 2 | 001-3061-59
2 | P | 1-480319-0 | 00779 | HOUSING,PIN |  | EA | 1 | 1 | 001-3061-59
2 | P | 60618-4 | 00779 | PIN |  | EA | 2 | 2 | 001-3061-59
1 | A | 001-3061-69-C |  | CABLE ASSY |  | EA | 1 | 1 | 001-3055-9
2 | R | M16878/4BKE0 |  | WIRE,14,BLACK |  | FT | .333 | .333 | 001-3061-69
2 | R | FIT-221-1/8Y | 92194 | SHRINK TUBING |  | FT | .167 | .167 | 001-3061-69
2 | P | G1820CT | 2S894 | DIODE,5A |  | EA | 1 | 1 | 001-3061-69
2 | P | 1-480318-0 | 00779 | HOUSING,SOCKET |  | EA | 1 | 1 | 001-3061-69
2 | P | 1-480319-0 | 00779 | HOUSING,PIN |  | EA | 1 | 1 | 001-3061-69
2 | P | 60619-4 | 00779 | SOCKET |  | EA | 2 | 2 | 001-3061-69
2 | P | 60620-4 | 00779 | PIN |  | EA | 2 | 2 | 001-3061-69
2 | A | 001-3061-49-B |  | CABLE ASSY |  | EA | 1 | 1 | 001-3056-9
3 | R | M16878/4BGE2 |  | WIRE,20,RED |  | FT | 1.92 | 1.92 | 001-3061-49
3 | R | M16878/4BGE4 |  | WIRE,20,YELLOW |  | FT | 8.67 | 8.67 | 001-3061-49
3 | R | M16878/4BGE6 |  | WIRE,20,BLUE |  | FT | .583 | .583 | 001-3061-49
3 | R | M16878/4BGEPNK |  | WIRE,20,PINK |  | FT | 1.75 | 1.75 | 001-3061-49
3 | R | M16878/4BHE0 |  | WIRE,18,BLACK |  | FT | .833 | .833 | 001-3061-49
3 | R | M16878/4BHE2 |  | WIRE,18,RED |  | FT | .833 | .833 | 001-3061-49
3 | R | M16878/4BGE0 |  | WIRE,20,BLACK |  | FT | 4.09 | 4.09 | 001-3061-49
3 | P | PT06E-14-19P | 77820 | CONNECTOR |  | EA | 1 | 1 | 001-3061-49
3 | P | MS3367-4-9 |  | STRAP |  | EA | 5 | 5 | 001-3061-49
3 | P | MS25036-108 |  | TERMINAL |  | EA | 2 | 2 | 001-3061-49
3 | R | FIT-221-1/8Y | 92194 | SHRINK TUBING |  | FT | .1 | .1 | 001-3061-49
3 | R | FIT-221-1/2Y | 92194 | SHRINK TUBING |  | FT | .1 | .1 | 001-3061-49
3 | P | 1-480318-0 | 00779 | SOCKET,HOUSING |  | EA | 9 | 9 | 001-3061-49
3 | P | 1-480424-0 | 00779 | SOCKET,HOUSING |  | EA | 1 | 1 | 001-3061-49
3 | P | 60617-4 | 00779 | SOCKET |  | EA | 23 | 23 | 001-3061-49
2 | A | 001-3061-79-C |  | CABLE ASSY |  | EA | 1 | 1 | 001-3056-9
3 | R | M16878/4BKE0 |  | WIRE,14,BLACK |  | FT | 1 | 1 | 001-3061-79
3 | P | MS25036-153 |  | TERMINAL |  | EA | 1 | 1 | 001-3061-79
3 | P | MS25036-108 |  | TERMINAL |  | EA | 1 | 1 | 001-3061-79
3 | R | FIT-221-1/8Y | 92194 | SHRINK TUBING |  | FT | .1 | .1 | 001-3061-79
2 | A | 001-3061-99-C |  | CABLE ASSY |  | EA | 1 | 1 | 001-3056-9
3 | R | M16878/4BGE2 |  | WIRE,20,RED |  | FT | .5 | .5 | 001-3061-99
3 | R | M16878/4BKE2 |  | WIRE,14,RED |  | FT | 1 | 1 | 001-3061-99
3 | R | M16878/4BGE0 |  | WIRE,20,BLACK |  | FT | .5 | .5 | 001-3061-99
3 | P | M83536/10-026M |  | RELAY |  | EA | 1 | 1 | 001-3061-99
3 | R | FIT-221-1/8Y | 92194 | SHRINK TUBING |  | FT | .1 | .1 | 001-3061-99
3 | P | 1-480426-0 | 00779 | HOUSING,PIN |  | EA | 1 | 1 | 001-3061-99
3 | P | 60618-4 | 00779 | PIN |  | EA | 2 | 2 | 001-3061-99
3 | P | 60620-4 | 00779 | PIN |  | EA | 2 | 2 | 001-3061-99
3 | R | PVC-105-6 | 92194 | TUBING |  | FT | .167 | .167 | 001-3061-99
2 | A | 001-3061-109-C |  | CABLE ASSY |  | EA | 1 | 1 | 001-3056-9
3 | R | M16878/4BKE2 |  | WIRE,14,RED |  | FT | 3.75 | 3.75 | 001-3061-109
3 | R | M16878/4BGE0 |  | WIRE,20,BLACK |  | FT | .413 | .413 | 001-3061-109
3 | R | FIT-221-1/8Y | 92194 | SHRINK TUBING |  | FT | .1 | .1 | 001-3061-109
3 | P | 1-480318-0 | 00779 | HOUSING,SOCKET |  | EA | 1 | 1 | 001-3061-109
3 | P | 1-480424-0 | 00779 | HOUSING,SOCKET |  | EA | 1 | 1 | 001-3061-109
3 | P | 60617-4 | 00779 | SOCKET |  | EA | 6 | 6 | 001-3061-109
3 | P | MS25036-103 |  | TERMINAL |  | EA | 3 | 3 | 001-3061-109
3 | R | FIT-221-3/8Y | 92194 | SHRINK TUBING |  | FT | .1 | .1 | 001-3061-109
3 | P | M7928/5-5 |  | SPLICE,BUTT |  | EA | 1 | 1 | 001-3061-109
2 | A | 001-3061-139-C |  | CABLE ASSY |  | EA | 1 | 1 | 001-3056-9
3 | R | M16878/4BKE0 |  | WIRE,14,BLACK |  | FT | .5 | .5 | 001-3061-139
3 | R | M16878/4BKE2 |  | WIRE,14,RED |  | FT | .5 | .5 | 001-3061-139
3 | P | MS25036-108 |  | TERMINAL |  | EA | 2 | 2 | 001-3061-139
3 | R | FIT-221-1/8Y | 92194 | SHRINK TUBING |  | FT | .125 | .125 | 001-3061-139
3 | P | 1-480319-0 | 00779 | HOUSING,PIN |  | EA | 1 | 1 | 001-3061-139
3 | P | 60620-4 | 00779 | PIN |  | EA | 2 | 2 | 001-3061-139
1 | A | 001-3061-89-C |  | CABLE ASSY |  | EA | 1 | 1 | 001-3055-9
2 | R | M16878/4BGE9 |  | WIRE,20,WHITE |  | FT | 3.5 | 3.5 | 001-3061-89
2 | P | P201133WM03N02 | 0BB05 | SWITCH,KEY |  | EA | 1 | 1 | 001-3061-89
2 | R | FIT-221-1/8Y | 92194 | SHRINK TUBING |  | FT | .1 | .1 | 001-3061-89
2 | P | 60618-4 | 00779 | PIN |  | EA | 3 | 3 | 001-3061-89
2 | P | 1-480305-0 | 00779 | HOUSING,PIN |  | EA | 1 | 1 | 001-3061-89
