dmarlowe69/Hayes-Targets/TLX DOCS/JohnsonRF/0013067.xls

I | C |  | FED MFG |  |  | UN | QTY | QTY | NEXT HIGHER
N | L | PART NUMBER | CODE | DESCRIPTION | PIECE SIZE | IS | NHA | EI | ASSEMBLY | REMARKS
2 | A | 001-3067-9-B |  | BULKHEAD ASSY |  | EA | 1 | 1 | 001-3020-9
3 | P | CGS622U040R4C | 90201 | CAPACITOR |  | EA | 1 | 1 | 001-3067-9
3 | P | 6176-2A | 91506 | CLIP |  | EA | 1 | 1 | 001-3067-9
3 | D | 001-1172-J |  | BULKHEAD |  | EA | 1 | 1 | 001-3067-9
4 | M | 056-00021-1-R |  | BULKHEAD |  | EA | 1 | 1 | 001-1172
5 | X | 056-00021-1S-R |  | BULKHEAD,FORM |  | EA | 1 | 1 | 056-00021-1
5 | Q | 2024-0 .063 250/4 |  | SHEET | 1.108X1.12 | SF | 1.24 | 1.24 | 056-00021-1
3 | P | MS35206-216 |  | SCREW |  | EA | 4 | 4 | 001-3067-9
3 | P | MS21083N04 |  | NUT |  | EA | 4 | 4 | 001-3067-9
3 | P | AN960D6 |  | WASHER |  | EA | 2 | 2 | 001-3067-9
3 | P | 70-903 | STANCOR | CONTACTOR,DC,24V |  | EA | 3 | 3 | 001-3067-9
3 | P | NO.9 | 44655 | BRACKET,MOUNTING |  | EA | 2 | 2 | 001-3067-9
3 | R | RTV-102 | 01139 | ADHESIVE |  | TU | .05 | .05 | 001-3067-9
3 | P | 2N3054 |  | TRANSISTOR |  | EA | 1 | 1 | 001-3067-9
3 | P | 4726 | 91833 | KIT,MOUNTING |  | EA | 1 | 1 | 001-3067-9
3 | P | MS21083N3 |  | NUT |  | EA | 4 | 4 | 001-3067-9
3 | P | AN960D10 |  | WASHER |  | EA | 4 | 4 | 001-3067-9
3 | P | AN525-10R8 |  | SCREW |  | EA | 4 | 4 | 001-3067-9
3 | P | CCR264CS-3-02 | 11815 | RIVET |  | EA | 24 | 24 | 001-3067-9
3 | P | MS3367-4-9 |  | STRAP |  | EA | 10 | 10 | 001-3067-9
3 | P | 1682-0412 | 19738 | RIVET |  | EA | 10 | 10 | 001-3067-9
3 | D | 001-3079 |  | DECAL |  | EA | 1 | 1 | 001-3067-9
4 | R | 3R994 | XEROX | DRAFTING FILM | .17X.17 | SF | .03 | .03 | 001-3079
3 | A | 001-3066-9-B |  | CABLE ASSY |  | EA | 1 | 1 | 001-3067-9
4 | R | M16878/4BGE0 |  | WIRE,20,BLACK |  | FT | 4.5 | 4.5 | 001-3066-9
4 | R | M16878/4BGE2 |  | WIRE,20,RED |  | FT | 1 | 1 | 001-3066-9
4 | R | M16878/4BGE9 |  | WIRE,20,WHITE |  | FT | 2 | 2 | 001-3066-9
4 | R | M16878/4BKE0 |  | WIRE,14,BLACK |  | FT | 2.13 | 2.13 | 001-3066-9
4 | R | M16878/4BKE2 |  | WIRE,14,RED |  | FT | .833 | .833 | 001-3066-9
4 | P | 879 | 83330 | TERMINAL STRIP |  | EA | 1 | 1 | 001-3066-9
4 | P | L50J1R0 | 44655 | RESISTOR,50W,1OHM |  | EA | 1 | 1 | 001-3066-9
4 | P | RCR42G681J |  | RESISTOR |  | EA | 1 | 1 | 001-3066-9
4 | P | 153-260FAK-B01 | 15801 | THERMISTOR |  | EA | 1 | 1 | 001-3066-9
4 | P | RCR20G121J |  | RESISTOR |  | EA | 1 | 1 | 001-3066-9
4 | A | 001-3068-9 |  | BRACKET ASSY |  | EA | 1 | 1 | 001-3066-9
5 | P | MR500F | 76055 | POTENTIOMETER |  | EA | 1 | 1 | 001-3068-9
5 | D | 041-0303-D |  | BRACKET,POT. |  | EA | 1 | 1 | 001-3068-9
6 | R | 6061-T6 .040 250/11 |  | SHEET | .146X.125 | SF | .018 | .018 | 041-0303
5 | P | 1682-0412 | 19738 | RIVET |  | EA | 2 | 2 | 001-3068-9
4 | P | MS3367-4-9 |  | STRAP |  | EA | 6 | 6 | 001-3066-9
4 | P | MS25036-103 |  | TERMINAL |  | EA | 1 | 1 | 001-3066-9
4 | P | MS25036-104 |  | TERMINAL |  | EA | 1 | 1 | 001-3066-9
4 | P | MS25036-109 |  | TERMINAL |  | EA | 2 | 2 | 001-3066-9
4 | P | 640905-1 | 00779 | TERMINAL |  | EA | 1 | 1 | 001-3066-9
4 | P | 66361-2 | 00779 | PIN |  | EA | 1 | 1 | 001-3066-9
4 | R | FIT-221-3/8Y | 92194 | SHRINK TUBING |  | FT | .25 | .25 | 001-3066-9
3 | A | 001-3066-19-B |  | CABLE ASSY |  | EA | 1 | 1 | 001-3067-9
4 | R | M16878/4BGE2 |  | WIRE,20,RED |  | FT | 1.17 | 1.17 | 001-3066-19
4 | P | CF-2 |  | FILTER,OPEK |  | EA | 1 | 1 | 001-3066-19
4 | P | MS3367-4-9 |  | STRAP |  | EA | 2 | 2 | 001-3066-19
4 | P | MS25036-104 |  | TERMINAL |  | EA | 2 | 2 | 001-3066-19
4 | R | FIT-221-1/8Y | 92194 | SHRINK TUBING |  | FT | .125 | .125 | 001-3066-19
4 | P | MS3367-5-9 |  | STRAP |  | EA | 1 | 1 | 001-3066-19
3 | A | 001-3066-29-B |  | CABLE ASSY |  | EA | 1 | 1 | 001-3067-9
4 | R | M16878/4BGE0 |  | WIRE,20,BLACK |  | FT | .563 | .563 | 001-3066-29
4 | R | M16878/4BGE2 |  | WIRE,20,RED |  | FT | 1.62 | 1.62 | 001-3066-29
4 | R | M16878/4BGE9 |  | WIRE,20,WHITE |  | FT | 1.06 | 1.06 | 001-3066-29
4 | R | M16878/4BKE2 |  | WIRE,14,RED |  | FT | 1.06 | 1.06 | 001-3066-29
4 | P | MS3367-4-9 |  | STRAP |  | EA | 6 | 6 | 001-3066-29
4 | P | 206705-1 | 00779 | RECEPTACLE |  | EA | 1 | 1 | 001-3066-29
4 | P | MS25036-103 |  | TERMINAL |  | EA | 3 | 3 | 001-3066-29
4 | P | MS25036-104 |  | TERMINAL |  | EA | 1 | 1 | 001-3066-29
4 | P | MS25036-109 |  | TERMINAL |  | EA | 1 | 1 | 001-3066-29
4 | P | 66103-2 | 00779 | PIN |  | EA | 4 | 4 | 001-3066-29
4 | P | 66361-2 | 00779 | PIN |  | EA | 2 | 2 | 001-3066-29
3 | A | 001-3066-39-B |  | CABLE ASSY |  | EA | 1 | 1 | 001-3067-9
4 | R | M16878/4BGE2 |  | WIRE,20,RED |  | FT | 2 | 2 | 001-3066-39
4 | R | M16878/4BGE9 |  | WIRE,20,WHITE |  | FT | .67 | .67 | 001-3066-39
4 | R | M16878/4BGE1 |  | WIRE,20,BROWN |  | FT | 1.33 | 1.33 | 001-3066-39
4 | P | MS3367-4-9 |  | STRAP |  | EA | 6 | 6 | 001-3066-39
4 | P | 2K-1B-126 | 02289 | RELAY |  | EA | 1 | 1 | 001-3066-39
4 | P | MS25036-103 |  | TERMINAL |  | EA | 1 | 1 | 001-3066-39
4 | P | MS25036-104 |  | TERMINAL |  | EA | 1 | 1 | 001-3066-39
4 | P | 66103-2 | 00779 | PIN |  | EA | 1 | 1 | 001-3066-39
4 | R | FIT-221-1/8Y | 92194 | SHRINK TUBING |  | FT | .5 | .5 | 001-3066-39
4 | P | 1N4002 |  | DIODE |  | EA | 1 | 1 | 001-3066-39
3 | A | 001-3066-49-B |  | CABLE ASSY |  | EA | 1 | 1 | 001-3067-9
4 | R | M16878/4BGE2 |  | WIRE,20,RED |  | FT | 1.55 | 1.55 | 001-3066-49
4 | R | M16878/4BGE9 |  | WIRE,20,WHITE |  | FT | .604 | .604 | 001-3066-49
4 | R | M16878/4BKE2 |  | WIRE,14,RED |  | FT | 1.8 | 1.8 | 001-3066-49
4 | P | MS3367-4-9 |  | STRAP |  | EA | 6 | 6 | 001-3066-49
4 | P | 1507-102 | 83330 | TIP,JACK |  | EA | 1 | 1 | 001-3066-49
4 | P | MS25036-103 |  | TERMINAL |  | EA | 2 | 2 | 001-3066-49
4 | P | MS25036-104 |  | TERMINAL |  | EA | 2 | 2 | 001-3066-49
4 | P | MS25036-109 |  | TERMINAL |  | EA | 3 | 3 | 001-3066-49
4 | P | 640905-1 | 00779 | TERMINAL |  | EA | 1 | 1 | 001-3066-49
3 | A | 001-3066-59-B |  | CABLE ASSY |  | EA | 1 | 1 | 001-3067-9
4 | R | M16878/4BKE2 |  | WIRE,14,RED |  | FT | .67 | .67 | 001-3066-59
4 | P | MS25036-109 |  | TERMINAL |  | EA | 2 | 2 | 001-3066-59
3 | A | 001-3066-69-B |  | CABLE ASSY |  | EA | 3 | 3 | 001-3067-9
4 | P | 1N5408 |  | DIODE |  | EA | 1 | 3 | 001-3066-69
4 | P | MS25036-103 |  | TERMINAL |  | EA | 2 | 6 | 001-3066-69
4 | R | FIT-221-1/8Y | 92194 | SHRINK TUBING |  | FT | .25 | .75 | 001-3066-69
3 | D | 001-3069-A |  | INSULATOR |  | EA | 1 | 1 | 001-3067-9
4 | R | NO.560 .010 FIBEROID | 72653 | PAPER, FISH |  | RL | .005 | .005 | 001-3069
3 | P | NAS697A08 |  | NUTPLATE |  | EA | 12 | 12 | 001-3067-9
3 | T | 001-3064-A |  | WIRING DIAGRAM |  | EA | 1 | 1 | 001-3067-9
3 | T | 001-5111 |  | BULKHEAD TEST PROC. |  | EA | 1 | 1 | 001-3067-9
