dmarlowe69/Hayes-Targets/TLX DOCS/Target/0011060V.XLS

Sheet: 0011060V
I | PART | FED MFG |  | T | NHA | TOTAL | QTY ON | QTY | DATE | QTY | TRANS | RFP | RFP | UNIT | UN
N | NUMBER | CODE | DESCRIPTION | Y | QTY | QTY | ORDER | REC | REC | TRANS | NO | NUMBER | DATE | PRICE | IS
0 | 001-1060-19-V |  | TLX-1 TARGET ASSY | A | 1 | 10 |  |  |  |  |  |  |  |  | EA
1 | 001-1117-9-G |  | COMPUTER ASSY | A | 1 | 10 |  |  |  |  |  |  |  |  | EA
2 | 001-1114-9-M |  | COMPUTER SUBASSY | A | 1 | 10 |  |  |  |  |  |  |  |  | EA
3 | 001-1103-9-F |  | FRAME ASSY | A | 1 | 10 |  |  |  |  |  |  |  |  | EA
4 | 001-1167-1-B |  | BAR | S | 2 | 20 |  |  |  |  |  |  |  |  | EA
4 | 001-1167-3-B |  | BAR | S | 8 | 80 |  |  |  |  |  |  |  |  | EA
4 | 001-1167-5-B |  | BAR | S | 2 | 20 |  |  |  |  |  |  |  |  | EA
4 | 001-1167-7-B |  | BAR | S | 1 | 10 |  |  |  |  |  |  |  |  | EA
4 | 001-1167-11-B |  | BAR | S | 2 | 20 |  |  |  |  |  |  |  |  | EA
4 | 001-1167-13-B |  | BAR | S | 1 | 10 |  |  |  |  |  |  |  |  | EA
4 | 001-1180-9-B |  | COVER ASSY | A | 1 | 10 |  |  |  |  |  |  |  |  | EA
5 | 001-1104-3-J |  | COVER | D | 1 | 10 |  |  |  |  |  |  |  |  | EA
6 | 6061-T6 .050 250/11 |  | SHEET | R | .997 | 9.97 |  |  |  |  |  |  |  |  | SF
5 | 001-1112-1-B |  | SPACER | D | 4 | 40 |  |  |  |  |  |  |  |  | EA
6 | 6061-T6 .050 250/11 |  | SHEET | R | .024 | 0.96 |  |  |  |  |  |  |  |  | SF
5 | 001-1112-3-B |  | SPACER | D | 2 | 20 |  |  |  |  |  |  |  |  | EA
6 | 6061-T6 .050 250/11 |  | SHEET | R | .011 | 0.22 |  |  |  |  |  |  |  |  | SF
5 | 001-1113-C |  | SLIDE | D | 2 | 20 |  |  |  |  |  |  |  |  | EA
6 | PRD-6875 | 07556 | CARD GUIDE | P | .5 | 10 |  |  |  |  |  |  |  |  | EA
5 | MS20470A4-5 |  | RIVET | P | 12 | 120 |  |  |  |  |  |  |  |  | EA
5 | PRD-6875 | 07556 | CARD GUIDE | P | 4 | 40 |  |  |  |  |  |  |  |  | EA
4 | MS35206-214 |  | SCREW | P | 26 | 260 |  |  |  |  |  |  |  |  | EA
4 | MS20470AD3-7 |  | RIVET | P | 26 | 260 |  |  |  |  |  |  |  |  | EA
4 | RTV-102 | 01139 | ADHESIVE | R | .01 | 0.1 |  |  |  |  |  |  |  |  | TU
3 | 001-1119-9-J |  | PC BOARD ASSY | A | 1 | 10 |  |  |  |  |  |  |  |  | EA
4 | 001-1120-D |  | PC BOARD | S | 1 | 10 |  |  |  |  |  |  |  |  | EA
4 | PKA2314P | 72347 | POWER SUPPLY | P | 1 | 10 |  |  |  |  |  |  |  |  | EA
4 | CSR13F476KM |  | CAPACITOR,47UF,35VDC | P | 1 | 10 |  |  |  |  |  |  |  |  | EA
4 | 109D827X9015T2 | 56289 | CAPACITOR,820UF,15DC | P | 1 | 10 |  |  |  |  |  |  |  |  | EA
4 | 001-5092 |  | PROCEDURE,TEST | T | 1 | 10 |  |  |  |  |  |  |  |  | EA
3 | 001-1174-9-D |  | CABLE ASSY, A/D BD. | A | 1 | 10 |  |  |  |  |  |  |  |  | EA
4 | 843-191-2801-020 | 02660 | CABLE,RIBBON | R | .5 | 5 |  |  |  |  |  |  |  |  | FT
4 | 842-812-2003-134 | 02660 | SOCKET | P | 2 | 20 |  |  |  |  |  |  |  |  | EA
4 | 842-812-1003-134 | 02660 | SOCKET | P | 1 | 10 |  |  |  |  |  |  |  |  | EA
4 | 001-1116-D |  | SCHEMATIC | T | 1 | 10 |  |  |  |  |  |  |  |  | EA
3 | 001-1188-9-H |  | INTERFACE BOARD ASSY | S | 1 | 10 |  |  |  |  |  |  |  |  | EA
4 | 001-1233-D |  | PC BOARD | T | 1 | 10 |  |  |  |  |  |  |  |  | EA
4 | 001-1234-A |  | SCHEMATIC | T | 1 | 10 |  |  |  |  |  |  |  |  | EA
4 | STD-0155 |  | PROCEDURE,ESD | T | 1 | 10 |  |  |  |  |  |  |  |  | EA
4 | 001-5095 |  | TEST PROCEDURE | T | 1 | 10 |  |  |  |  |  |  |  |  | EA
3 | 001-1218-9-H |  | 1805 CPU ASSY | A | 1 | 10 |  |  |  |  |  |  |  |  | EA
4 | 001-1224-9-K |  | EPROM ASSY | A | 1 | 10 |  |  |  |  |  |  |  |  | EA
5 | MD2716M |  | EPROM | P | 1 | 10 |  |  |  |  |  |  |  |  | EA
5 | 001-1224-1-K |  | DECAL | D | 1 | 10 |  |  |  |  |  |  |  |  | EA
6 | B-61H-250 | 96707 | TYVEX | R | .01 | 0.1 |  |  |  |  |  |  |  |  | RL
5 | STD-0155 |  | PROCEDURE,ESD | T | 1 | 10 |  |  |  |  |  |  |  |  | EA
5 | 001-5097-A |  | PROCEDURE,TEST | T | 1 | 10 |  |  |  |  |  |  |  |  | EA
5 | 001-1331-A |  | OBJECT CODE,EPROM | T | 1 | 10 |  |  |  |  |  |  |  |  | EA
4 | MB606 | MATRIC | 1805 CPU BOARD | P | 1 | 10 |  |  |  |  |  |  |  |  | EA
4 | RTV-162 | 01139 | ADHESIVE | R | .01 | 0.1 |  |  |  |  |  |  |  |  | TU
4 | 001-1224-19-K |  | EPROM ASSY | X | 1 | 10 |  |  |  |  |  |  |  |  | EA
5 | MD2716M |  | EPROM | X | 1 | 10 |  |  |  |  |  |  |  |  | EA
5 | 001-1224-3-K |  | DECAL | X | 1 | 10 |  |  |  |  |  |  |  |  | EA
6 | B-61H-250 | 96707 | TYVEX | X | .01 | 0.1 |  |  |  |  |  |  |  |  | RL
5 | STD-0155 |  | PROCEDURE,ESD | T | 1 | 10 |  |  |  |  |  |  |  |  | EA
5 | 001-5097-A |  | PROCEDURE,TEST | T | 1 | 10 |  |  |  |  |  |  |  |  | EA
5 | 001-1440 |  | OBJECT CODE,EPROM | T | 1 | 10 |  |  |  |  |  |  |  |  | EA
4 | 001-5098 |  | PROCEDURE,TEST | T | 1 | 10 |  |  |  |  |  |  |  |  | EA
3 | 001-1219-D |  | TM ENCODER | D | 1 | 10 |  |  |  |  |  |  |  |  | EA
4 | 001-5043-C |  | ENCODER BOARD ASSY | S | 1 | 10 |  |  |  |  |  |  |  |  | EA
4 | STD-0155 |  | PROCEDURE,ESD | T | 1 | 10 |  |  |  |  |  |  |  |  | EA
4 | 001-5094 |  | PROCEDURE,TEST | T | 1 | 10 |  |  |  |  |  |  |  |  | EA
3 | M16878/1BEE9 |  | WIRE,24,WHITE | R | 140 | 1400 |  |  |  |  |  |  |  |  | FT
3 | MS35206-217 |  | SCREW | P | 12 | 120 |  |  |  |  |  |  |  |  | EA
3 | 001-1424-A |  | A/D-D/A BOARD MOD | D | 1 | 10 |  |  |  |  |  |  |  |  | EA
4 | MB654A | MATRIC | A/D-D/A CONVERTER | P | 1 | 10 |  |  |  |  |  |  |  |  | EA
4 | RTV-162 | 01139 | ADHESIVE | R | .01 | 0.1 |  |  |  |  |  |  |  |  | TU
4 | 001-5096 |  | PROCEDURE,TEST | T | 1 | 10 |  |  |  |  |  |  |  |  | EA
3 | 001-1173 |  | BACKPLANE,COMPUTER | S | 1 | 10 |  |  |  |  |  |  |  |  | EA
3 | 001-5042-D |  | DECODER BOARD ASSY | S | 1 | 10 |  |  |  |  |  |  |  |  | EA
4 | 001-5093 |  | TEST PROCEDURE | T | 1 | 10 |  |  |  |  |  |  |  |  | EA
3 | 143-022-01-(110) | 13511 | CONNECTOR | P | 3 | 30 |  |  |  |  |  |  |  |  | EA
3 | 50-44SN-9 | 71785 | CONNECTOR | P | 1 | 10 |  |  |  |  |  |  |  |  | EA
3 | 583616-4 | 00779 | PIN | P | 19 | 190 |  |  |  |  |  |  |  |  | EA
3 | 583717-5 | 00779 | CONNECTOR | P | 1 | 10 |  |  |  |  |  |  |  |  | EA
3 | 22231 | 05972 | THREAD LOCK | R | .01 | 0.1 |  |  |  |  |  |  |  |  | BT
3 | 001-1116-D |  | SCHEMATIC | T | 1 | 10 |  |  |  |  |  |  |  |  | EA
3 | 001-1175-C |  | WIRE LIST | T | 1 | 10 |  |  |  |  |  |  |  |  | EA
3 | STD-0155 |  | PROCEDURE,ESD | T | 1 | 10 |  |  |  |  |  |  |  |  | EA
3 | 001-5055-H |  | PROCEDURE,TEST | T | 1 | 10 |  |  |  |  |  |  |  |  | EA
2 | 001-1115-9-G |  | TRAY ASSY | A | 1 | 10 |  |  |  |  |  |  |  |  | EA
3 | 001-1115-1-G |  | TRAY | D | 1 | 10 |  |  |  |  |  |  |  |  | EA
4 | 6061-T6 .050 250/11 |  | SHEET | R | .486 | 4.86 |  |  |  |  |  |  |  |  | SF
3 | 9655-08 | 19738 | NUTSERT | P | 6 | 60 |  |  |  |  |  |  |  |  | EA
2 | 001-1169-9-J |  | COVER/EXTENSION ASSY | A | 1 | 10 |  |  |  |  |  |  |  |  | EA
3 | 001-1176-1-B |  | COVER,TOP | D | 1 | 10 |  |  |  |  |  |  |  |  | EA
4 | 6061-T6 .050 250/11 |  | SHEET | R | .043 | 0.43 |  |  |  |  |  |  |  |  | SF
3 | 001-1176-3-B |  | COVER,SIDE | D | 1 | 10 |  |  |  |  |  |  |  |  | EA
4 | 6061-T6 .050 250/11 |  | SHEET | R | .035 | 0.35 |  |  |  |  |  |  |  |  | SF
3 | 001-1177-1-A |  | BAR | S | 2 | 20 |  |  |  |  |  |  |  |  | EA
3 | 001-1177-11-A |  | BAR | S | 1 | 10 |  |  |  |  |  |  |  |  | EA
3 | 001-1177-13-A |  | BAR | S | 1 | 10 |  |  |  |  |  |  |  |  | EA
3 | 001-1177-14-A |  | BAR | S | 1 | 10 |  |  |  |  |  |  |  |  | EA
3 | 001-1177-3-A |  | BAR | S | 1 | 10 |  |  |  |  |  |  |  |  | EA
3 | 001-1177-5-A |  | BAR | S | 1 | 10 |  |  |  |  |  |  |  |  | EA
3 | 001-1177-7-A |  | BAR | S | 1 | 10 |  |  |  |  |  |  |  |  | EA
3 | 001-1178-9-D |  | COVER ASSY | A | 1 | 10 |  |  |  |  |  |  |  |  | EA
4 | 001-1168-9-B |  | BUMPER ASSY | A | 2 | 20 |  |  |  |  |  |  |  |  | EA
5 | 001-1168-1-B |  | BUMPER | D | 1 | 20 |  |  |  |  |  |  |  |  | EA
6 | 6061-T6 .032 250/11 |  | SHEET | R | .008 | 0.16 |  |  |  |  |  |  |  |  | SF
5 | 001-1168-3-B |  | INSULATION | D | 1 | 20 |  |  |  |  |  |  |  |  | EA
6 | NES-41B-.25A | 72781 | SHEET,SPONGE RUBBER | R | .003 | 0.06 |  |  |  |  |  |  |  |  | SF
4 | 001-1104-11-J |  | COVER | D | 1 | 10 |  |  |  |  |  |  |  |  | EA
5 | 6061-T6 .050 250/11 |  | SHEET | R | .209 | 2.09 |  |  |  |  |  |  |  |  | SF
4 | MS20470AD3-4 |  | RIVET | P | 4 | 40 |  |  |  |  |  |  |  |  | EA
4 | 1201-052 | 51406 | FILTER & HARDWARE | P | 21 | 210 |  |  |  |  |  |  |  |  | EA
4 | 856 | 91833 | TERMINAL STRIP | P | 1 | 10 |  |  |  |  |  |  |  |  | EA
4 | MS20470AD3-3 |  | RIVET | P | 2 | 20 |  |  |  |  |  |  |  |  | EA
3 | 001-1181-9-C |  | COVER ASSY | A | 1 | 10 |  |  |  |  |  |  |  |  | EA
4 | 001-1104-1-J |  | COVER | D | 1 | 10 |  |  |  |  |  |  |  |  | EA
5 | 6061-T6 .050 250/11 |  | SHEET | R | .209 | 2.09 |  |  |  |  |  |  |  |  | SF
4 | MS21083N04 |  | NUT | P | 32 | 320 |  |  |  |  |  |  |  |  | EA
4 | MS3112E10-6S |  | CONNECTOR | P | 1 | 10 |  |  |  |  |  |  |  |  | EA
4 | MS3112E10-6SW |  | CONNECTOR | P | 1 | 10 |  |  |  |  |  |  |  |  | EA
4 | MS3112E10-98S |  | CONNECTOR | P | 1 | 10 |  |  |  |  |  |  |  |  | EA
4 | MS3112E14-19S |  | CONNECTOR | P | 1 | 10 |  |  |  |  |  |  |  |  | EA
4 | MS3112E8-33S |  | CONNECTOR | P | 1 | 10 |  |  |  |  |  |  |  |  | EA
4 | MS3112E8-4S |  | CONNECTOR | P | 1 | 10 |  |  |  |  |  |  |  |  | EA
4 | MS3112E8-4SW |  | CONNECTOR | P | 1 | 10 |  |  |  |  |  |  |  |  | EA
4 | MS35206-214 |  | SCREW | P | 32 | 320 |  |  |  |  |  |  |  |  | EA
4 | PT02E-8-2P | 77820 | CONNECTOR | P | 1 | 10 |  |  |  |  |  |  |  |  | EA
4 | 10-101949-10 | 77820 | GASKET | P | 3 | 30 |  |  |  |  |  |  |  |  | EA
4 | 10-101949-14 | 77820 | GASKET | P | 1 | 10 |  |  |  |  |  |  |  |  | EA
4 | 10-101949-8 | 77820 | GASKET | P | 4 | 40 |  |  |  |  |  |  |  |  | EA
4 | 10-101960-145 | 77820 | CAP,PROTECTION | P | 1 | 10 |  |  |  |  |  |  |  |  | EA
4 | 10-101960-105 | 77820 | CAP,PROTECTION | P | 1 | 10 |  |  |  |  |  |  |  |  | EA
4 | 7326 | 91833 | LUG,SOLDER | P | 1 | 10 |  |  |  |  |  |  |  |  | EA
3 | MS20470AD3-7 |  | RIVET | P | 28 | 280 |  |  |  |  |  |  |  |  | EA
3 | MS35206-214 |  | SCREW | P | 38 | 380 |  |  |  |  |  |  |  |  | EA
3 | M16878/1BEE9 |  | WIRE,24,WHITE | R | 45 | 450 |  |  |  |  |  |  |  |  | FT
3 | RCR07G562J |  | RESISTOR | P | 1 | 10 |  |  |  |  |  |  |  |  | EA
3 | FIT-221-3/32Y | 92194 | SHRINK TUBING | R | .17 | 1.7 |  |  |  |  |  |  |  |  | FT
3 | RTV-102 | 01139 | ADHESIVE | R | .01 | 0.1 |  |  |  |  |  |  |  |  | TU
3 | 001-1175-C |  | WIRE LIST | T | 1 | 10 |  |  |  |  |  |  |  |  | EA
3 | 001-1116-D |  | SCHEMATIC | T | 1 | 10 |  |  |  |  |  |  |  |  | EA
2 | 001-1179-9-C |  | COVER ASSY | A | 1 | 10 |  |  |  |  |  |  |  |  | EA
3 | 001-1104-7-J |  | COVER | D | 1 | 10 |  |  |  |  |  |  |  |  | EA
4 | 6061-T6 .050 250/11 |  | SHEET | R | .146 | 1.46 |  |  |  |  |  |  |  |  | SF
3 | MS20470AD3-4 |  | RIVET | P | 2 | 20 |  |  |  |  |  |  |  |  | EA
3 | 001-1179-1-C |  | SHEET,RUBBER | D | 2 | 20 |  |  |  |  |  |  |  |  | EA
4 | NES-41B-.75A |  | SHEET,SPONGE RUBBER | R | .013 | 0.26 |  |  |  |  |  |  |  |  | SF
3 | 001-1179-3-C |  | ANGLE | D | 1 | 10 |  |  |  |  |  |  |  |  | EA
4 | 6061-T6 .032 250/11 |  | SHEET | R | .008 | 0.08 |  |  |  |  |  |  |  |  | SF
3 | 224 |  | TAPE,DUCT .75IN | R | .1 | 1 |  |  |  |  |  |  |  |  | FT
2 | MS35206-214 |  | SCREW | P | 72 | 720 |  |  |  |  |  |  |  |  | EA
2 | 001-1155-2-B |  | DECAL | D | 1 | 10 |  |  |  |  |  |  |  |  | EA
3 | B-61H-250 |  | TYVEX | R | .01 | 0.1 |  |  |  |  |  |  |  |  | RL
2 | 001-1116-D |  | SCHEMATIC | T | 1 | 10 |  |  |  |  |  |  |  |  | EA
2 | 001-1175-C |  | WIRE LIST | T | 1 | 10 |  |  |  |  |  |  |  |  | EA
2 | 001-5055-H |  | PROCEDURE,TEST | T | 1 | 10 |  |  |  |  |  |  |  |  | EA
2 | STD-0155 |  | PROCEDURE,ESD | T | 1 | 10 |  |  |  |  |  |  |  |  | EA
1 | 001-1152-9-F |  | WING | A | 2 | 20 |  |  |  |  |  |  |  |  | EA
2 | 001-1152-9S1-F |  | WING, ANODIZE | S | 1 | 20 |  |  |  |  |  |  |  |  | EA
2 | 001-1152-9S2-F |  | WING, PAINT | S | 1 | 20 |  |  |  |  |  |  |  |  | EA
3 | STD-5021-G |  | PAINT PROCEDURE | T | 1 | 20 |  |  |  |  |  |  |  |  | EA
2 | 001-1456-A |  | ADAPTER | D | 1 | 20 |  |  |  |  |  |  |  |  | EA
3 | 6061-T6511 .75 DIA |  | ROD QQ-A-200/8 | R | .2 | 4 |  |  |  |  |  |  |  |  | FT
2 | 001-1457-A |  | EXTRUSION,WING | W | .7 | 14 |  |  |  |  |  |  |  |  | FT
1 | 001-1222-9-C |  | NOSE CONE ASSY | A | 1 | 10 |  |  |  |  |  |  |  |  | EA
2 | 001-1171-9-E |  | NOSE CONE ASSY | A | 1 | 10 |  |  |  |  |  |  |  |  | EA
3 | 041-0389-1-N |  | NOSE CONE | D | 1 | 10 |  |  |  |  |  |  |  |  | EA
4 | 041-0389-1LH-N |  | NOSE CONE,LESS HOLES | S | 1 | 10 |  |  |  |  |  |  |  |  | EA
3 | 041-0477-9-G |  | REFLECTOR&BULKHEAD | A | 1 | 10 |  |  |  |  |  |  |  |  | EA
4 | MS35206-244 |  | SCREW | P | 3 | 30 |  |  |  |  |  |  |  |  | EA
4 | 041-0263-1-R |  | BULKHEAD | D | 1 | 10 |  |  |  |  |  |  |  |  | EA
5 | 056-00021-1-R |  | BULKHEAD | M | 1 | 10 |  |  |  |  |  |  |  |  | EA
6 | 056-00021-1S-R |  | BULKHEAD,FORM | X | 1 | 10 |  |  |  |  |  |  |  |  | EA
6 | 2024-0 .063 250/4 |  | SHEET | Q | 1.24 | 12.4 |  |  |  |  |  |  |  |  | SF
4 | 041-0444-9-B |  | REFLECTOR ASSY | M | 1 | 10 |  |  |  |  |  |  |  |  | EA
5 | MS20470AD3-4 |  | RIVET | X | 15 | 150 |  |  |  |  |  |  |  |  | EA
5 | 05-0860-3032-01 | 12881 | WIRE MESH | X | 3 | 30 |  |  |  |  |  |  |  |  | FT
5 | 22NA7-68-82 | 72962 | NUTPLATE | X | 3 | 30 |  |  |  |  |  |  |  |  | EA
5 | 041-0443-E |  | FRAME | X | 3 | 30 |  |  |  |  |  |  |  |  | EA
6 | 041-0443S-E |  | SERVICE,NICKLE COAT | X | 1 | 30 |  |  |  |  |  |  |  |  | EA
6 | STD-0142 |  | FINISH, ELECTRO TIN | X | 1 | 30 |  |  |  |  |  |  |  |  | EA
6 | 6061-T6 .063 250/11 |  | SHEET | X | .437 | 13.12 |  |  |  |  |  |  |  |  | SF
3 | 001-1165-9-A |  | BRACKET ASSY | A | 3 | 30 |  |  |  |  |  |  |  |  | EA
4 | 001-1159-D |  | BRACKET | M | 1 | 30 |  |  |  |  |  |  |  |  | EA
5 | 001-1159S-D |  | BRACKET,CAD PLATE | X | 1 | 30 |  |  |  |  |  |  |  |  | EA
5 | 1020 .047 ASTM A366 |  | SHEET | Q | .038 | 1.14 |  |  |  |  |  |  |  |  | SF
4 | 9655-08 | 19738 | NUTSERT | P | 2 | 60 |  |  |  |  |  |  |  |  | EA
3 | Q4559 | 08806 | LAMP | P | 1 | 10 |  |  |  |  |  |  |  |  | EA
3 | 9655-08 | 19738 | NUTSERT | P | 6 | 60 |  |  |  |  |  |  |  |  | EA
3 | MS24693-S50 |  | SCREW | P | 6 | 60 |  |  |  |  |  |  |  |  | EA
3 | A3135-017-935 | 78553 | WASHER | P | 6 | 60 |  |  |  |  |  |  |  |  | EA
3 | KT80 | 75382 | TERMINAL | P | 2 | 20 |  |  |  |  |  |  |  |  | EA
3 | PPP-T-60TYPE4CL1 1W |  | TAPE | R | .01 | 0.1 |  |  |  |  |  |  |  |  | RL
3 | RTV-102 | 01139 | ADHESIVE | R | .01 | 0.1 |  |  |  |  |  |  |  |  | TU
2 | 001-1199-9-T |  | BULKHEAD ASSY | A | 1 | 10 |  |  |  |  |  |  |  |  | EA
3 | 041-0303-D |  | BRACKET,POT. | D | 1 | 10 |  |  |  |  |  |  |  |  | EA
4 | 6061-T6 .040 250/11 |  | SHEET | R | .018 | 0.18 |  |  |  |  |  |  |  |  | SF
3 | 70-903 | STANCOR | CONTACTOR,DC,24V | P | 2 | 20 |  |  |  |  |  |  |  |  | EA
3 | MR500F | 76055 | POTENTIOMETER | P | 1 | 10 |  |  |  |  |  |  |  |  | EA
3 | L50J1R0 | 44655 | RESISTOR,50W,1OHM | P | 1 | 10 |  |  |  |  |  |  |  |  | EA
3 | NO.9 | 44655 | BRACKET,MOUNTING | P | 2 | 20 |  |  |  |  |  |  |  |  | EA
3 | 1507-102 | 83330 | TIP,JACK | P | 1 | 10 |  |  |  |  |  |  |  |  | EA
3 | CF-2 |  | FILTER,OPEK | P | 1 | 10 |  |  |  |  |  |  |  |  | EA
3 | RTV-102 | 01139 | ADHESIVE | R | .05 | 0.5 |  |  |  |  |  |  |  |  | TU
3 | 879 | 83330 | TERMINAL STRIP | P | 1 | 10 |  |  |  |  |  |  |  |  | EA
3 | RCR42G681J |  | RESISTOR | P | 1 | 10 |  |  |  |  |  |  |  |  | EA
3 | RCR20G121J |  | RESISTOR | P | 1 | 10 |  |  |  |  |  |  |  |  | EA
3 | 153-260FAK-B01 | 15801 | THERMISTOR | P | 1 | 10 |  |  |  |  |  |  |  |  | EA
3 | 2N3054 |  | TRANSISTOR | P | 1 | 10 |  |  |  |  |  |  |  |  | EA
3 | 4726 | 91833 | KIT,MOUNTING | P | 1 | 10 |  |  |  |  |  |  |  |  | EA
3 | 66361-2 | 00779 | PIN | P | 2 | 20 |  |  |  |  |  |  |  |  | EA
3 | MS21083N3 |  | NUT | P | 4 | 40 |  |  |  |  |  |  |  |  | EA
3 | AN960D10 |  | WASHER | P | 4 | 40 |  |  |  |  |  |  |  |  | EA
3 | AN525-10R8 |  | SCREW | P | 4 | 40 |  |  |  |  |  |  |  |  | EA
3 | 66103-2 | 00779 | PIN | P | 4 | 40 |  |  |  |  |  |  |  |  | EA
3 | 9655-08 | 19738 | NUTSERT | P | 12 | 120 |  |  |  |  |  |  |  |  | EA
3 | MS25036-103 |  | TERMINAL | P | 9 | 90 |  |  |  |  |  |  |  |  | EA
3 | MS3367-4-9 |  | STRAP | P | 36 | 360 |  |  |  |  |  |  |  |  | EA
3 | 1682-0412 | 19738 | RIVET | P | 12 | 120 |  |  |  |  |  |  |  |  | EA
3 | 640905-1 | 00779 | TERMINAL | P | 2 | 20 |  |  |  |  |  |  |  |  | EA
3 | MS25036-109 |  | TERMINAL | P | 6 | 60 |  |  |  |  |  |  |  |  | EA
3 | MS25036-104 |  | TERMINAL | P | 5 | 50 |  |  |  |  |  |  |  |  | EA
3 | M16878/1BGE0 |  | WIRE,20,BLACK | R | 2 | 20 |  |  |  |  |  |  |  |  | FT
3 | M16878/1BGE9 |  | WIRE,20,WHITE | R | 4.17 | 41.7 |  |  |  |  |  |  |  |  | FT
3 | M16878/1BKE2 |  | WIRE,14,RED | R | 3 | 30 |  |  |  |  |  |  |  |  | FT
3 | M16878/1BKE0 |  | WIRE,14,BLACK | R | 4.17 | 41.7 |  |  |  |  |  |  |  |  | FT
3 | M16878/1BGE2 |  | WIRE,20,RED | R | 4.17 | 41.7 |  |  |  |  |  |  |  |  | FT
3 | CGS622U040R4C | 90201 | CAPACITOR | P | 1 | 10 |  |  |  |  |  |  |  |  | EA
3 | 6176-2A | 91506 | CLIP | P | 1 | 10 |  |  |  |  |  |  |  |  | EA
3 | MS3367-5-9 |  | STRAP | P | 1 | 10 |  |  |  |  |  |  |  |  | EA
3 | 001-1172-H |  | BULKHEAD | D | 1 | 10 |  |  |  |  |  |  |  |  | EA
4 | 056-00021-1-R |  | BULKHEAD | M | 1 | 10 |  |  |  |  |  |  |  |  | EA
5 | 056-00021-1S-R |  | BULKHEAD,FORM | X | 1 | 10 |  |  |  |  |  |  |  |  | EA
5 | 2024-0 .063 250/4 |  | SHEET | Q | 1.24 | 12.4 |  |  |  |  |  |  |  |  | SF
3 | 206705-1 | 00779 | RECEPTACLE | P | 1 | 10 |  |  |  |  |  |  |  |  | EA
3 | MS35206-216 |  | SCREW | P | 4 | 40 |  |  |  |  |  |  |  |  | EA
3 | MS21083N04 |  | NUT | P | 4 | 40 |  |  |  |  |  |  |  |  | EA
3 | AN960D6 |  | WASHER | P | 2 | 20 |  |  |  |  |  |  |  |  | EA
3 | 001-1486 |  | DECAL | D | 1 | 10 |  |  |  |  |  |  |  |  | EA
4 | 3R994 |  | DRAFTING FILM | R | .03 | 0.3
3 | 001-1200-G |  | SCHEMATIC | T | 1 | 10 |  |  |  |  |  |  |  |  | EA
3 | 001-5111 |  | RELAY ADJUSTMENT | T | 1 | 10 |  |  |  |  |  |  |  |  | EA
2 | 001-1201-C |  | BODY,FWD. | D | 1 | 10 |  |  |  |  |  |  |  |  | EA
3 | STD-0137-E |  | BODY | S | .078 | 0.78 |  |  |  |  |  |  |  |  | EA
2 | MS24693-S50 |  | SCREW | P | 12 | 120 |  |  |  |  |  |  |  |  | EA
2 | A3135-017-935 | 78553 | WASHER | P | 12 | 120 |  |  |  |  |  |  |  |  | EA
1 | 001-1185-9-H |  | ACCELEROMETER ASSY | A | 1 | 10 |  |  |  |  |  |  |  |  | EA
2 | 001-1185-1-H |  | HOUSING ASSY | A | 1 | 10 |  |  |  |  |  |  |  |  | EA
3 | 001-1182-B |  | HOUSING | D | 1 | 10 |  |  |  |  |  |  |  |  | EA
4 | HU-6605-2.781-AL | 02875 | CASE | P | 1 | 10 |  |  |  |  |  |  |  |  | EA
3 | 001-1189-9-F |  | SUPPORT ASSY | A | 1 | 10 |  |  |  |  |  |  |  |  | EA
4 | 001-1189-1-F |  | BRACKET | D | 1 | 10 |  |  |  |  |  |  |  |  | EA
5 | 6061-T6 .040 250/11 |  | SHEET | R | .1 | 1 |  |  |  |  |  |  |  |  | SF
4 | 9655-08 | 19738 | NUTSERT | P | 4 | 40 |  |  |  |  |  |  |  |  | EA
3 | MS20470AD3-5 |  | RIVET | P | 4 | 40 |  |  |  |  |  |  |  |  | EA
2 | 001-1187-9-D |  | PANEL ASSY | A | 1 | 10 |  |  |  |  |  |  |  |  | EA
3 | 001-1190-B |  | COVER | D | 1 | 10 |  |  |  |  |  |  |  |  | EA
4 | ABS .060 WHITE |  | SHEET | R | .026 | 0.26 |  |  |  |  |  |  |  |  | SF
3 | 001-1183-C |  | PANEL | S | 1 | 10 |  |  |  |  |  |  |  |  | EA
3 | 001-1122-49-G |  | CABLE ASSY | A | 1 | 10 |  |  |  |  |  |  |  |  | EA
4 | M22759/13-20-9 |  | WIRE,WHITE | R | 2.25 | 22.5 |  |  |  |  |  |  |  |  | FT
4 | MS3116E8-33P |  | CONNECTOR | P | 1 | 10 |  |  |  |  |  |  |  |  | EA
4 | MS3367-4-9 |  | STRAP | P | 2 | 20 |  |  |  |  |  |  |  |  | EA
3 | 1201-052 | 51046 | FILTER & HARDWARE | P | 3 | 30 |  |  |  |  |  |  |  |  | EA
3 | 1/8-5B | 95987 | CLAMP | P | 1 | 10 |  |  |  |  |  |  |  |  | EA
3 | 3250L-1-103M | 32997 | POTENTIOMETER | P | 1 | 10 |  |  |  |  |  |  |  |  | EA
3 | MS35206-226 |  | SCREW | P | 2 | 20 |  |  |  |  |  |  |  |  | EA
2 | MS35206-202 |  | SCREW | P | 4 | 40 |  |  |  |  |  |  |  |  | EA
2 | MS35206-213 |  | SCREW | P | 4 | 40 |  |  |  |  |  |  |  |  | EA
2 | M16878/1BEE9 |  | WIRE,24,WHITE | R | 1 | 10 |  |  |  |  |  |  |  |  | FT
2 | LA67-0132-1 | 98284 | ACCELEROMETER | P | 1 | 10 |  |  |  |  |  |  |  |  | EA
2 | 001-1155-1-B |  | DECAL | D | 1 | 10 |  |  |  |  |  |  |  |  | EA
3 | B-61H-250 |  | TYVEX | R | .01 | 0.1 |  |  |  |  |  |  |  |  | RL
2 | MS35333-35 |  | WASHER | P | 4 | 40 |  |  |  |  |  |  |  |  | EA
2 | 001-5056-B |  | PROCEDURE,TEST | T | 1 | 10 |  |  |  |  |  |  |  |  | EA
2 | STD-0159 |  | PROCEDURE,HANDLING | T | 1 | 10 |  |  |  |  |  |  |  |  | EA
1 | 001-1145-9-N |  | SHIPPING ARRANGEMENT | A | 1 | 10 |  |  |  |  |  |  |  |  | EA
2 | 041-0326-B |  | CUSHION | S | 1 | 10 |  |  |  |  |  |  |  |  | EA
2 | 058-0527-15-Y |  | BOX | S | 1 | 10 |  |  |  |  |  |  |  |  | EA
2 | 058-0527-16-Y |  | DOUBLER | S | 2 | 20 |  |  |  |  |  |  |  |  | EA
2 | 041-0317-A |  | DOUBLER | S | 2 | 20 |  |  |  |  |  |  |  |  | EA
2 | 041-0322-E |  | CRADLE | S | 8 | 80 |  |  |  |  |  |  |  |  | EA
2 | 041-0323-B |  | END STOP | S | 1 | 10 |  |  |  |  |  |  |  |  | EA
2 | 001-1145-11-N |  | BAG | D | 1 | 10 |  |  |  |  |  |  |  |  | EA
3 | MIL-B-117-18W |  | TUBE,BARRIER | R | 8.75 | 87.5 |  |  |  |  |  |  |  |  | FT
2 | 001-1145-1-N |  | STOP | D | 1 | 10 |  |  |  |  |  |  |  |  | EA
3 | PLYWOOD 1/2THK |  | SHEET | R | 1.17 | 11.7 |  |  |  |  |  |  |  |  | SF
2 | 041-1227 |  | SPACER | S | 1 | 10 |  |  |  |  |  |  |  |  | EA
2 | 001-1145-3-N |  | BRACE | D | 2 | 20 |  |  |  |  |  |  |  |  | EA
3 | NO2 1X4X8FT |  | YELLOW PINE | R | .25 | 5 |  |  |  |  |  |  |  |  | EA
2 | ST-120 24W | 51875 | CAP,AIR | R | .25 | 2.5 |  |  |  |  |  |  |  |  | RL
2 | BCS834-1.5 | 08075 | STAPLE | P | 38 | 380 |  |  |  |  |  |  |  |  | EA
2 | SW9040X.875 | 08075 | STAPLE | P | 20 | 200 |  |  |  |  |  |  |  |  | EA
2 | STL .020X.375W |  | BAND | R | 18 | 180 |  |  |  |  |  |  |  |  | FT
2 | E-395 | 86142 | GLUE | R | .01 | 0.1 |  |  |  |  |  |  |  |  | GL
2 | MIL-D-3464TYI 8UNIT |  | DESICCANT | P | 5 | 50 |  |  |  |  |  |  |  |  | BG
2 | MIL-D-3464TYI 1UNIT |  | DESICCANT | P | 1 | 10 |  |  |  |  |  |  |  |  | BG
2 | 001-1145-5-N |  | BAG | D | 1 | 10 |  |  |  |  |  |  |  |  | EA
3 | MIL-B-117-18W |  | TUBE,BARRIER | R | 2.5 | 25 |  |  |  |  |  |  |  |  | FT
2 | 001-1145-7-N |  | BAG | D | 1 | 10 |  |  |  |  |  |  |  |  | EA
3 | MIL-B-117-6W |  | TUBE,BARRIER | R | .83 | 8.3 |  |  |  |  |  |  |  |  | FT
1 | 001-1217-9-B |  | TAIL CONE ASSY | A | 1 | 10 |  |  |  |  |  |  |  |  | EA
2 | 001-1216-9-D |  | BULKHEAD ASSY | A | 1 | 10 |  |  |  |  |  |  |  |  | EA
3 | 001-1216-1-D |  | BULKHEAD | D | 1 | 10 |  |  |  |  |  |  |  |  | EA
4 | 056-00021-1-R |  | BULKHEAD | M | 1 | 10 |  |  |  |  |  |  |  |  | EA
5 | 056-00021-1S-R |  | BULKHEAD,FORM | X | 1 | 10 |  |  |  |  |  |  |  |  | EA
5 | 2024-0 .063 250/4 |  | SHEET | Q | 1.24 | 12.4 |  |  |  |  |  |  |  |  | SF
3 | 9655-08 | 19738 | NUTSERT | P | 9 | 90 |  |  |  |  |  |  |  |  | EA
3 | 9657-10 | 19738 | NUTSERT | P | 12 | 120 |  |  |  |  |  |  |  |  | EA
2 | 041-0273-H |  | TAIL CONE | A | 1 | 10 |  |  |  |  |  |  |  |  | EA
3 | SSD43SSBSLF | 04375 | RIVET | P | 6 | 60 |  |  |  |  |  |  |  |  | EA
3 | 041-0272-D |  | BEARING | D | 1 | 10 |  |  |  |  |  |  |  |  | EA
4 | 4X727 | 16327 | BEARING | P | 1 | 10 |  |  |  |  |  |  |  |  | EA
3 | 041-0264-F |  | TAIL CONE | D | 1 | 10 |  |  |  |  |  |  |  |  | EA
4 | 056-01818-J |  | NOSE CONE | S | 1 | 10 |  |  |  |  |  |  |  |  | EA
3 | 041-0262-H |  | BULKHEAD | M | 1 | 10 |  |  |  |  |  |  |  |  | EA
4 | 2024-0 .063 250/4 |  | SHEET | Q | .694 | 6.94 |  |  |  |  |  |  |  |  | SF
3 | 1604-0615 | 19738 | RIVET | P | 4 | 40 |  |  |  |  |  |  |  |  | EA
2 | MS24693-S50 |  | SCREW | P | 6 | 60 |  |  |  |  |  |  |  |  | EA
2 | A3135-017-935 | 78553 | WASHER | P | 6 | 60 |  |  |  |  |  |  |  |  | EA
1 | STD-0096-H |  | NAMEPLATE | S | 1 | 10 |  |  |  |  |  |  |  |  | EA
1 | STD-0107-1-L |  | WING | D | 5 | 50 |  |  |  |  |  |  |  |  | EA
2 | STD-0109-L |  | WING | S | 1 | 50 |  |  |  |  |  |  |  |  | EA
1 | 001-1073-F |  | DOOR | D | 1 | 10 |  |  |  |  |  |  |  |  | EA
2 | KYDEX .060 ORANGE |  | SHEET | R | .473 | 4.73 |  |  |  |  |  |  |  |  | SF
1 | 001-1220-1-C |  | ANTENNA, WING | A | 1 | 10 |  |  |  |  |  |  |  |  | EA
2 | 001-1220-3-C |  | WIRE,BARE | D | 1 | 10 |  |  |  |  |  |  |  |  | EA
3 | QQ-W-343 22AWG |  | WIRE,BARE | R | .125 | 1.25 |  |  |  |  |  |  |  |  | FT
2 | 001-1221-F |  | WING,MOD | D | 1 | 10 |  |  |  |  |  |  |  |  | EA
3 | STD-0107-1-L |  | WING | D | 1 | 10 |  |  |  |  |  |  |  |  | EA
4 | STD-0109-L |  | WING | S | 1 | 10 |  |  |  |  |  |  |  |  | EA
2 | 001-1223-C |  | GROUND PLANE | D | 1 | 10 |  |  |  |  |  |  |  |  | EA
3 | 6061-T6 .020 250/11 |  | SHEET | R | .278 | 2.78 |  |  |  |  |  |  |  |  | SF
2 | MS35206-216 |  | SCREW | P | 2 | 20 |  |  |  |  |  |  |  |  | EA
2 | UG-290A/U |  | CONNECTOR | P | 1 | 10 |  |  |  |  |  |  |  |  | EA
2 | A1023 | 57771 | EYELET | P | 2 | 20 |  |  |  |  |  |  |  |  | EA
2 | X-1194 1/2WIDE | 28153 | TAPE,COPPER FOIL | R | .013 | 0.13 |  |  |  |  |  |  |  |  | RL
2 | 191 1.5WIDE | 28153 | TAPE,PLASTIC,CLEAR | R | .155 | 1.55 |  |  |  |  |  |  |  |  | RL
1 | 001-1203-9-E |  | SHAFT ASSY | A | 1 | 10 |  |  |  |  |  |  |  |  | EA
2 | 001-1203-1-E |  | TUBE | M | 1 | 10 |  |  |  |  |  |  |  |  | EA
3 | 001-1203-1S-E |  | TUBE,CAD PLATE | X | 1 | 10 |  |  |  |  |  |  |  |  | EA
3 | 4130N 1.00ODX.028W |  | TUBE | Q | 3.58 | 35.8 |  |  |  |  |  |  |  |  | FT
2 | 041-1183-A |  | COUPLING | S | 1 | 10 |  |  |  |  |  |  |  |  | EA
2 | 041-1184-D |  | COUPLING | S | 1 | 10 |  |  |  |  |  |  |  |  | EA
2 | MS171522 |  | PIN | P | 6 | 60 |  |  |  |  |  |  |  |  | EA
2 | 63531 | 05972 | COMPOUND,RETAINING | R | .01 | 0.1 |  |  |  |  |  |  |  |  | BT
2 | 001-1214-9-M |  | BULKHEAD ASSY | A | 1 | 10 |  |  |  |  |  |  |  |  | EA
3 | 001-1214-1-M |  | BULKHEAD | D | 1 | 10 |  |  |  |  |  |  |  |  | EA
4 | 056-00021-1-R |  | BULKHEAD | M | 1 | 10 |  |  |  |  |  |  |  |  | EA
5 | 056-00021-1S-R |  | BULKHEAD,FORM | X | 1 | 10 |  |  |  |  |  |  |  |  | EA
5 | 2024-0 .063 250/4 |  | SHEET | Q | 1.24 | 12.4 |  |  |  |  |  |  |  |  | SF
3 | 041-0271-D |  | BEARING | D | 1 | 10 |  |  |  |  |  |  |  |  | EA
4 | 4X730 | 16327 | BEARING | P | 1 | 10 |  |  |  |  |  |  |  |  | EA
3 | 1604-0615 | 19738 | RIVET | P | 4 | 40 |  |  |  |  |  |  |  |  | EA
3 | NAS697A3 |  | NUTPLATE | P | 12 | 120 |  |  |  |  |  |  |  |  | EA
3 | CCR264CS-3-2 | 11815 | RIVET | P | 30 | 300 |  |  |  |  |  |  |  |  | EA
3 | NAS697A08 |  | NUTPLATE | P | 3 | 30 |  |  |  |  |  |  |  |  | EA
3 | MS21266-2N |  | GROMMET | R | 1.3 | 13 |  |  |  |  |  |  |  |  | FT
1 | 041-0267-F |  | TURBINE | M | 1 | 10 |  |  |  |  |  |  |  |  | EA
2 | 041-0175-D |  | TURBINE | X | 1 | 10 |  |  |  |  |  |  |  |  | EA
2 | 041-0267-1-F |  | SHIPPING ARRANGEMENT | X | 1 | 10 |  |  |  |  |  |  |  |  | EA
3 | 041-0267-3-F |  | SPACER | X | 1 | 10 |  |  |  |  |  |  |  |  | EA
4 | 1X1.25 |  | STYROFOAM | Q | 4 | 40 |  |  |  |  |  |  |  |  | FT
3 | 041-1226-A |  | SUPPORT | X | 2 | 20 |  |  |  |  |  |  |  |  | EA
3 | CLOTH 1.0W |  | TAPE | Q | .01 | 0.1 |  |  |  |  |  |  |  |  | RL
1 | 041-0387-E |  | SPACER | M | 1 | 10 |  |  |  |  |  |  |  |  | EA
2 | 2024-T3 .875ODX.188W |  | TUBE | Q | .032 | 0.32 |  |  |  |  |  |  |  |  | FT
1 | MS21083N8 |  | NUT | P | 1 | 10 |  |  |  |  |  |  |  |  | EA
1 | MS24693-S50 |  | SCREW | P | 42 | 420 |  |  |  |  |  |  |  |  | EA
1 | A3135-017-935 | 78553 | WASHER | P | 45 | 450 |  |  |  |  |  |  |  |  | EA
1 | MS24694-S51 |  | SCREW | P | 24 | 240 |  |  |  |  |  |  |  |  | EA
1 | 1/4-28X3.25LG |  | SCREW,SOCKET HD CAP | P | 2 | 20 |  |  |  |  |  |  |  |  | EA
1 | AN525-832R6 |  | SCREW | P | 14 | 140 |  |  |  |  |  |  |  |  | EA
1 | 001-0153-9-K |  | TARGET ADAPTER ASSY | A | 1 | 10 |  |  |  |  |  |  |  |  | EA
2 | TE21046-C |  | LOCK COLLAR | S | 1 | 10 |  |  |  |  |  |  |  |  | EA
2 | TE21051-B |  | NOSE | S | 1 | 10 |  |  |  |  |  |  |  |  | EA
2 | NTA-613 | 60380 | THRUST BEARING | P | 1 | 10 |  |  |  |  |  |  |  |  | EA
2 | TE21106-A |  | BUSHING | S | 1 | 10 |  |  |  |  |  |  |  |  | EA
2 | 001-0154 |  | KEY | M | 1 | 10 |  |  |  |  |  |  |  |  | EA
2 | AN960C516L |  | WASHER | P | 1 | 10 |  |  |  |  |  |  |  |  | EA
2 | MS9245-44 |  | PIN,COTTER | P | 1 | 10 |  |  |  |  |  |  |  |  | EA
2 | MS20392-4C23 |  | PIN,STRAIGHT,HEADED | P | 1 | 10 |  |  |  |  |  |  |  |  | EA
2 | 001-0152-1-F |  | END FITTING | S | 1 | 10 |  |  |  |  |  |  |  |  | EA
2 | TRA-613 | 60380 | THRUST RACE | P | 2 | 20 |  |  |  |  |  |  |  |  | EA
2 | MICROFOAM 1/8 | 13164 | SHEET | R | .01 | 0.1 |  |  |  |  |  |  |  |  | RL
2 | 001-0177 |  | DECAL | D | 1 | 10 |  |  |  |  |  |  |  |  | EA
3 | 3R994 | HAYES | DRAFTING FILM | R | .03 | 0.3 |  |  |  |  |  |  |  |  | SF
1 | 001-1330 |  | DECAL,WING | S | 4 | 40 |  |  |  |  |  |  |  |  | EA
1 | AN960PD816L |  | WASHER | P | 1 | 10 |  |  |  |  |  |  |  |  | EA
1 | 041-0239-15-U |  | BALLAST | D | 1 | 10 |  |  |  |  |  |  |  |  | EA
2 | 03262 |  | INHIBITOR (SP-350) | R | .01 | 0.1 |  |  |  |  |  |  |  |  | CN
2 | STD-0161-A |  | BALLAST,CAST IRON | S | .5 | 5 |  |  |  |  |  |  |  |  | EA
3 | 03262 |  | INHIBITOR (SP-350) | R | .02 | 0.2 |  |  |  |  |  |  |  |  | CN
1 | 001-1210-39-J |  | CABLE ASSY | A | 1 | 10 |  |  |  |  |  |  |  |  | EA
2 | UG-88E/U |  | CONNECTOR | P | 1 | 10 |  |  |  |  |  |  |  |  | EA
2 | RG-223/U |  | CABLE,COAX | R | 2.09 | 20.9 |  |  |  |  |  |  |  |  | FT
2 | 2031-5002-02 | 26805 | CONNECTOR | P | 1 | 10 |  |  |  |  |  |  |  |  | EA
1 | 001-1369-9-C |  | ALTIMETER ASSY | A | 1 | 10 |  |  |  |  |  |  |  |  | EA
2 | 001-1365 |  | TRAY | D | 1 | 10 |  |  |  |  |  |  |  |  | EA
3 | 6061-T6 .050 250/11 |  | SHEET | R | .272 | 2.72 |  |  |  |  |  |  |  |  | SF
2 | 001-1155-7-B |  | DECAL | D | 1 | 10 |  |  |  |  |  |  |  |  | EA
3 | B-61H-250 |  | TYVEX | R | .01 | 0.1 |  |  |  |  |  |  |  |  | RL
2 | 001-5081-E |  | KIT, ALTIMETER | S | 1 | 10 |  |  |  |  |  |  |  |  | EA
3 | 001-5087-A |  | TEST PROCEDURE | T | 1 | 10 |  |  |  |  |  |  |  |  | EA
2 | MS35206-228 |  | SCREW | P | 4 | 40 |  |  |  |  |  |  |  |  | EA
2 | MS21083N06 |  | NUT | P | 4 | 40 |  |  |  |  |  |  |  |  | EA
2 | 9655-08 | 19738 | NUTSERT | P | 4 | 40 |  |  |  |  |  |  |  |  | EA
2 | AN960D6 |  | WASHER | P | 4 | 40 |  |  |  |  |  |  |  |  | EA
1 | 001-1371-B |  | NAMEPLATE | D | 1 | 10 |  |  |  |  |  |  |  |  | EA
2 | 3R994 | HAYES | DRAFTING FILM | R | .03 | 0.3 |  |  |  |  |  |  |  |  | SF
1 | 001-1367-9-F |  | TRANSMITTER ASSY | A | 1 | 10 |  |  |  |  |  |  |  |  | EA
2 | 001-5079-*-D |  | TRANSMITTER | S | 1 | 10 |  |  |  |  |  |  |  |  | EA
3 | 001-5085-A |  | TEST PROCEDURE | T | 1 | 10 |  |  |  |  |  |  |  |  | EA
2 | 001-1364-9-B |  | TRAY ASSY | A | 1 | 10 |  |  |  |  |  |  |  |  | EA
3 | 001-1364-1-B |  | TRAY | D | 1 | 10 |  |  |  |  |  |  |  |  | EA
4 | 6061-T6 .032 250/11 |  | SHEET | R | .219 | 2.19 |  |  |  |  |  |  |  |  | SF
3 | 9655-08 | 19738 | NUTSERT | P | 4 | 40 |  |  |  |  |  |  |  |  | EA
2 | MS3114E8-4P |  | CONNECTOR | P | 1 | 10 |  |  |  |  |  |  |  |  | EA
2 | AN960D916 |  | WASHER | P | 1 | 10 |  |  |  |  |  |  |  |  | EA
2 | MS35206-242 |  | SCREW | P | 4 | 40 |  |  |  |  |  |  |  |  | EA
2 | MS21083N08 |  | NUT | P | 4 | 40 |  |  |  |  |  |  |  |  | EA
2 | 9S4J010 | 16428 | CONNECTOR | P | 1 | 10 |  |  |  |  |  |  |  |  | EA
2 | 8R28010 | 16428 | CABLE | R | .25 | 2.5 |  |  |  |  |  |  |  |  | FT
2 | RTV-162 | 01139 | ADHESIVE | R | .01 | 0.1 |  |  |  |  |  |  |  |  | TU
2 | MS25036-149 |  | TERMINAL | P | 1 | 10 |  |  |  |  |  |  |  |  | EA
2 | M16878/1BGE9 |  | WIRE,20,WHITE | R | .25 | 2.5 |  |  |  |  |  |  |  |  | FT
2 | 001-1417 |  | DECAL | D | 1 | 10 |  |  |  |  |  |  |  |  | EA
3 | SCOTCHCAL,WHITE | 34360 | SCOTCHCAL | R | .167 | 1.67 |  |  |  |  |  |  |  |  | FT
2 | 001-5085-A |  | TEST PROCEDURE | T | 1 | 10 |  |  |  |  |  |  |  |  | EA
1 | 001-1368-9-F |  | RECEIVER ASSY | A | 1 | 10 |  |  |  |  |  |  |  |  | EA
2 | 001-5080-*-F |  | RECEIVER | S | 1 | 10 |  |  |  |  |  |  |  |  | EA
3 | 001-5085-A |  | TEST PROCEDURE | T | 1 | 10 |  |  |  |  |  |  |  |  | EA
2 | 001-1364-9-B |  | TRAY ASSY | A | 1 | 10 |  |  |  |  |  |  |  |  | EA
3 | 001-1364-1-B |  | TRAY | D | 1 | 10 |  |  |  |  |  |  |  |  | EA
4 | 6061-T6 .032 250/11 |  | SHEET | R | .219 | 2.19 |  |  |  |  |  |  |  |  | SF
3 | 9655-08 | 19738 | NUTSERT | P | 4 | 40 |  |  |  |  |  |  |  |  | EA
2 | MS3114E8-4SW |  | CONNECTOR | P | 1 | 10 |  |  |  |  |  |  |  |  | EA
2 | AN960D916 |  | WASHER | P | 1 | 10 |  |  |  |  |  |  |  |  | EA
2 | MS35206-242 |  | SCREW | P | 4 | 40 |  |  |  |  |  |  |  |  | EA
2 | MS21083N08 |  | NUT | P | 4 | 40 |  |  |  |  |  |  |  |  | EA
2 | 9S4J010 | 16428 | CONNECTOR | P | 1 | 10 |  |  |  |  |  |  |  |  | EA
2 | 8R28010 | 16428 | CABLE | R | .25 | 2.5 |  |  |  |  |  |  |  |  | FT
2 | RTV-162 | 01139 | ADHESIVE | R | .01 | 0.1 |  |  |  |  |  |  |  |  | TU
2 | MS25036-149 |  | TERMINAL | P | 1 | 10 |  |  |  |  |  |  |  |  | EA
2 | M16878/1BGE9 |  | WIRE,20,WHITE | R | .25 | 2.5 |  |  |  |  |  |  |  |  | FT
2 | 001-1418 |  | DECAL | D | 1 | 10 |  |  |  |  |  |  |  |  | EA
3 | SCOTCHCAL,CLEAR | 34360 | SCOTCHCAL | R | .167 | 1.67 |  |  |  |  |  |  |  |  | FT
2 | 001-5085-A |  | TEST PROCEDURE | T | 1 | 10 |  |  |  |  |  |  |  |  | EA
1 | 001-1215-19-H |  | FUSELAGE ASSY | A | 1 | 10 |  |  |  |  |  |  |  |  | EA
2 | 001-1109-9-F |  | LAUNCH SWITCH ASSY | A | 1 | 10 |  |  |  |  |  |  |  |  | EA
3 | 001-0126-9-H |  | ACTUATOR ASSY | A | 1 | 10 |  |  |  |  |  |  |  |  | EA
4 | 001-0126-1-H |  | ACTUATOR | D | 1 | 10 |  |  |  |  |  |  |  |  | EA
5 | 6061-T6 .187 250/11 |  | PLATE | R | .056 | 0.56 |  |  |  |  |  |  |  |  | SF
4 | MS16555-627 |  | PIN | P | 1 | 10 |  |  |  |  |  |  |  |  | EA
4 | 001-0128-C |  | ROD | S | 1 | 10 |  |  |  |  |  |  |  |  | EA
4 | 63531 | 05972 | COMPOUND,RETAINING | R | .01 | 0.1 |  |  |  |  |  |  |  |  | BT
3 | 001-0127-D |  | BRACKET | D | 1 | 10 |  |  |  |  |  |  |  |  | EA
4 | 6061-T6 .063 250/11 |  | SHEET | R | .07 | 0.7 |  |  |  |  |  |  |  |  | SF
3 | 001-0128-C |  | ROD | S | 1 | 10 |  |  |  |  |  |  |  |  | EA
3 | 001-0129-B |  | SPACER | D | 2 | 20 |  |  |  |  |  |  |  |  | EA
4 | P-577-M05-F02-832 | 04729 | SPACER | P | 1 | 20 |  |  |  |  |  |  |  |  | EA
3 | 001-1108-D |  | BRACKET | D | 1 | 10 |  |  |  |  |  |  |  |  | EA
4 | 6061-T6 .063 250/11 |  | SHEET | R | .097 | 0.97 |  |  |  |  |  |  |  |  | SF
3 | LWNY-002BK | 62619 | WASHER | P | 2 | 20 |  |  |  |  |  |  |  |  | EA
3 | LE-037CD-10-MW | 84830 | SPRING | P | 2 | 20 |  |  |  |  |  |  |  |  | EA
3 | MS20470A4-8 |  | RIVET | P | 4 | 40 |  |  |  |  |  |  |  |  | EA
3 | 111SM2-T | 91929 | SWITCH | P | 1 | 10 |  |  |  |  |  |  |  |  | EA
3 | M16878/1BGE9 |  | WIRE,20,WHITE | R | 1.5 | 15 |  |  |  |  |  |  |  |  | FT
3 | MS35206-207 |  | SCREW | P | 2 | 20 |  |  |  |  |  |  |  |  | EA
3 | MS35333-35 |  | WASHER | P | 2 | 20 |  |  |  |  |  |  |  |  | EA
3 | MS35649-222 |  | NUT | P | 2 | 20 |  |  |  |  |  |  |  |  | EA
3 | PT00E-8-2S | 77820 | CONNECTOR | P | 1 | 10 |  |  |  |  |  |  |  |  | EA
3 | MS35206-215 |  | SCREW | P | 4 | 40 |  |  |  |  |  |  |  |  | EA
3 | AN960D4 |  | WASHER | P | 4 | 40 |  |  |  |  |  |  |  |  | EA
3 | MS21083N04 |  | NUT | P | 4 | 40 |  |  |  |  |  |  |  |  | EA
3 | 63531 | 05972 | COMPOUND,RETAINING | R | .01 | 0.1 |  |  |  |  |  |  |  |  | BT
3 | 74756 | 05972 | PRIMER | R | .01 | 0.1 |  |  |  |  |  |  |  |  | BT
2 | 001-1083-1-D |  | GROUND PLANE ASSY | A | 1 | 10 |  |  |  |  |  |  |  |  | EA
3 | 001-1083-3-D |  | GROUND PLANE | D | 1 | 10 |  |  |  |  |  |  |  |  | EA
4 | 6061-T6 .020 250/11 |  | SHEET | R | 1.33 | 13.3 |  |  |  |  |  |  |  |  | SF
3 | NAS697A06 |  | NUTPLATE | P | 2 | 20 |  |  |  |  |  |  |  |  | EA
3 | MS20426AD2-3 |  | RIVET | P | 4 | 40 |  |  |  |  |  |  |  |  | EA
2 | 001-1068-9-F |  | DOUBLER ASSY | A | 1 | 10 |  |  |  |  |  |  |  |  | EA
3 | 001-1068-1-F |  | DOUBLER | D | 1 | 10 |  |  |  |  |  |  |  |  | EA
4 | 6061-T6 .050 250/11 |  | SHEET | R | .661 | 6.61 |  |  |  |  |  |  |  |  | SF
3 | 9655-08 | 19738 | NUTSERT | P | 30 | 300 |  |  |  |  |  |  |  |  | EA
2 | 001-1225-9 |  | ANTENNA ASSY | A | 1 | 10 |  |  |  |  |  |  |  |  | EA
3 | 001-1228-C |  | BRACKET | D | 1 | 10 |  |  |  |  |  |  |  |  | EA
4 | 6061-T6 .050 250/11 |  | SHEET | R | .042 | 0.42 |  |  |  |  |  |  |  |  | SF
3 | CI-106 | 51351 | ANTENNA | P | 1 | 10 |  |  |  |  |  |  |  |  | EA
2 | 001-1370-B |  | FUSELAGE | D | 1 | 10 |  |  |  |  |  |  |  |  | EA
3 | STD-0143-3-C |  | FUSELAGE | S | 1 | 10 |  |  |  |  |  |  |  |  | EA
2 | MS24693-S50 |  | SCREW | P | 13 | 130 |  |  |  |  |  |  |  |  | EA
2 | MS21083N5 |  | NUT | P | 1 | 10 |  |  |  |  |  |  |  |  | EA
2 | 001-1226-1-A |  | TOW FITTING | A | 1 | 10 |  |  |  |  |  |  |  |  | EA
3 | 001-1226-1S-A |  | FITTING,CAD PLATE | S | 1 | 10 |  |  |  |  |  |  |  |  | EA
3 | 001-1226-3-A |  | BASE | D | 1 | 10 |  |  |  |  |  |  |  |  | EA
4 | 4130 .125 |  | SHEET,MIL-S-18729 | R | .083 | 0.83 |  |  |  |  |  |  |  |  | SF
3 | 001-1226-5-A |  | SPACER | D | 1 | 10 |  |  |  |  |  |  |  |  | EA
4 | 4130 .625ODX.156W |  | TUBE MIL-T-6736 | R | .011 | 0.11 |  |  |  |  |  |  |  |  | FT
3 | AN45-7A |  | EYEBOLT | P | 1 | 10 |  |  |  |  |  |  |  |  | EA
2 | AN960-516 |  | WASHER | P | 1 | 10 |  |  |  |  |  |  |  |  | EA
2 | AN3-5A |  | BOLT | P | 2 | 20 |  |  |  |  |  |  |  |  | EA
2 | AN525-832R6 |  | SCREW | P | 16 | 160 |  |  |  |  |  |  |  |  | EA
2 | A3135-017-935 | 78553 | WASHER | P | 13 | 130 |  |  |  |  |  |  |  |  | EA
2 | AN960-10 |  | WASHER | P | 2 | 20 |  |  |  |  |  |  |  |  | EA
2 | MS21083N3 |  | NUT | P | 2 | 20 |  |  |  |  |  |  |  |  | EA
2 | 001-1321-A |  | CABLE HOLDER | D | 1 | 10 |  |  |  |  |  |  |  |  | EA
3 | STD-0157 |  | EXTRUSION | S | 1.5 | 15 |  |  |  |  |  |  |  |  | FT
2 | MS35206-228 |  | SCREW | P | 2 | 20 |  |  |  |  |  |  |  |  | EA
2 | 001-1107-19-M |  | INNER STRUCTURE | A | 1 | 10 |  |  |  |  |  |  |  |  | EA
3 | 001-1166-9-A |  | ALTERNATOR ASSY | A | 1 | 10 |  |  |  |  |  |  |  |  | EA
4 | 001-1157-9-E |  | BULKHEAD ASSY | A | 1 | 10 |  |  |  |  |  |  |  |  | EA
5 | 001-1157-1-E |  | BULKHEAD | D | 1 | 10 |  |  |  |  |  |  |  |  | EA
6 | 056-00021-1-R |  | BULKHEAD | M | 1 | 10 |  |  |  |  |  |  |  |  | EA
7 | 056-00021-1S-R |  | BULKHEAD,FORM | X | 1 | 10 |  |  |  |  |  |  |  |  | EA
7 | 2024-0 .063 250/4 |  | SHEET | Q | 1.24 | 12.4 |  |  |  |  |  |  |  |  | SF
5 | CCR264CS-3-2 | 11815 | RIVET | P | 8 | 80 |  |  |  |  |  |  |  |  | EA
5 | NAS1068A08 |  | NUTPLATE | P | 4 | 40 |  |  |  |  |  |  |  |  | EA
4 | 001-1205-9-L |  | ALTERNATOR,MODIFIED | A | 1 | 10 |  |  |  |  |  |  |  |  | EA
5 | 001-1205-1-L |  | ROD,THREADED | D | 4 | 40 |  |  |  |  |  |  |  |  | EA
6 | 10-32 STL CAD PLATED |  | ROD,THREADED | R | .417 | 16.7 |  |  |  |  |  |  |  |  | FT
5 | 001-1291-B |  | COVER,ALTERNATOR | D | 1 | 10 |  |  |  |  |  |  |  |  | EA
6 | 8EM3003GA COVER |  | COVER,ALTERNATOR | X | 1 | 10 |  |  |  |  |  |  |  |  | EA
5 | AN960D10 |  | WASHER | P | 8 | 80 |  |  |  |  |  |  |  |  | EA
5 | AN960-10 |  | WASHER | P | 2 | 20 |  |  |  |  |  |  |  |  | EA
5 | AN960-10L |  | WASHER | P | 4 | 40 |  |  |  |  |  |  |  |  | EA
5 | MS25036-103 |  | TERMINAL | P | 2 | 20 |  |  |  |  |  |  |  |  | EA
5 | MS35207-265 |  | SCREW | P | 2 | 20 |  |  |  |  |  |  |  |  | EA
5 | MS35333-39 |  | WASHER | P | 4 | 40 |  |  |  |  |  |  |  |  | EA
5 | M16878/1BGE0 |  | WIRE,20,BLACK | R | .5 | 5 |  |  |  |  |  |  |  |  | FT
5 | 10-9002 | 72653 | VARNISH,SEALING | R | .01 | 0.1 |  |  |  |  |  |  |  |  | GL
5 | 103-57 | 68505 | BRUSH ASSY | P | 1 | 10 |  |  |  |  |  |  |  |  | EA
5 | 405 | 02972 | KEY,WOODRUFF,1/8X5/8 | P | 1 | 10 |  |  |  |  |  |  |  |  | EA
5 | 63531 | 05972 | COMPOUND,RETAINING | R | .01 | 0.1 |  |  |  |  |  |  |  |  | BT
5 | 8EM3003GA | 68505 | ALTERNATOR | P | 1 | 10 |  |  |  |  |  |  |  |  | EA
5 | MS35650-302 |  | NUT | P | 4 | 40 |  |  |  |  |  |  |  |  | EA
5 | MS21083N3 |  | NUT | P | 8 | 80 |  |  |  |  |  |  |  |  | EA
4 | 10-9002 | 72653 | VARNISH,SEALING | R | .01 | 0.1 |  |  |  |  |  |  |  |  | GL
3 | 001-1080-19-Y |  | TOW BULKHEAD ASSY | A | 1 | 10 |  |  |  |  |  |  |  |  | EA
4 | 001-1063-H |  | BRACKET | D | 1 | 10 |  |  |  |  |  |  |  |  | EA
5 | 6061-T6 .063 250/11 |  | SHEET | R | .833 | 8.33 |  |  |  |  |  |  |  |  | SF
4 | 001-1101-D |  | ANGLE | D | 1 | 10 |  |  |  |  |  |  |  |  | EA
5 | 6061-T6 .125 250/11 |  | SHEET | R | .047 | 0.47 |  |  |  |  |  |  |  |  | SF
4 | 001-1095-9-K |  | SERVO ASSY | A | 1 | 10 |  |  |  |  |  |  |  |  | EA
5 | 001-5023-D |  | MOTOR | S | 1 | 10 |  |  |  |  |  |  |  |  | EA
5 | F78SA103 | 08815 | POTENTIOMETER | P | 1 | 10 |  |  |  |  |  |  |  |  | EA
5 | 001-1096-D |  | BRACKET | S | 1 | 10 |  |  |  |  |  |  |  |  | EA
5 | 001-1072-9-P |  | GEAR&LINK ASSY | A | 1 | 10 |  |  |  |  |  |  |  |  | EA
6 | 001-1072-3-P |  | WELDMENT | A | 1 | 10 |  |  |  |  |  |  |  |  | EA
7 | 001-1072-3S-P |  | WELDMENT,CAD PLATE | S | 1 | 10 |  |  |  |  |  |  |  |  | EA
7 | 001-1072-1-P |  | LINK | D | 1 | 10 |  |  |  |  |  |  |  |  | EA
8 | 4130 .063 |  | SHEET,MIL-S-18729 | R | .017 | 0.17 |  |  |  |  |  |  |  |  | SF
7 | 001-1069-E |  | SCREW,SHOULDER | S | 1 | 10 |  |  |  |  |  |  |  |  | EA
6 | MS20470AD2-5 |  | RIVET | P | 4 | 40 |  |  |  |  |  |  |  |  | EA
6 | P64S28-60 | 29440 | GEAR,SPUR | P | 1 | 10 |  |  |  |  |  |  |  |  | EA
6 | AN565B6H6 |  | SCREW,SET | P | 2 | 20 |  |  |  |  |  |  |  |  | EA
5 | AN500-4-5 |  | SCREW | P | 4 | 420 |  |  |  |  |  |  |  |  | EA
5 | P64S10-20 | 29440 | GEAR,SPUR | P | 1 | 10 |  |  |  |  |  |  |  |  | EA
5 | L3-22 | 00141 | CLEATS,MOTOR MOUNT | P | 3 | 30 |  |  |  |  |  |  |  |  | EA
5 | CCR264CS-3-03 | 11815 | RIVET | P | 4 | 40 |  |  |  |  |  |  |  |  | EA
5 | NAS1068A08 |  | NUTPLATE | P | 2 | 20 |  |  |  |  |  |  |  |  | EA
5 | 22231 | 05972 | THREAD LOCK | R | .01 | 0.1 |  |  |  |  |  |  |  |  | BT
5 | 63531 | 05972 | COMPOUND,RETAINING | R | .01 | 0.1 |  |  |  |  |  |  |  |  | BT
5 | 74756 | 05972 | PRIMER T | R | .01 | 0.1 |  |  |  |  |  |  |  |  | BT
4 | 001-1070-1-K |  | ARM WELDMENT | A | 1 | 10 |  |  |  |  |  |  |  |  | EA
5 | 001-1070-1S-K |  | ARM,CAD PLATE | S | 1 | 10 |  |  |  |  |  |  |  |  | EA
5 | 001-1070-3-K |  | BRACKET | D | 1 | 10 |  |  |  |  |  |  |  |  | EA
6 | 4130A .063 |  | SHEET,MIL-S-18729 | R | .085 | 0.85 |  |  |  |  |  |  |  |  | SF
5 | 001-1070-5-K |  | TUBE | D | 1 | 10 |  |  |  |  |  |  |  |  | EA
6 | 4130 1.00ODX.134W |  | TUBE,MIL-T-6736 | R | .052 | 0.52 |  |  |  |  |  |  |  |  | FT
5 | 001-1069-E |  | SCREW,SHOULDER | S | 1 | 10 |  |  |  |  |  |  |  |  | EA
4 | 001-1071-C |  | LINK | D | 1 | 10 |  |  |  |  |  |  |  |  | EA
5 | 001-1071S-C |  | LINK,CAD PLATE | S | 1 | 10 |  |  |  |  |  |  |  |  | EA
5 | 4130A .063 MILS18729 |  | SHEET | R | .028 | 0.28 |  |  |  |  |  |  |  |  | SF
4 | 001-1054-9-F |  | SUPPORT ASSY | A | 2 | 20 |  |  |  |  |  |  |  |  | EA
5 | 9655-08 | 19738 | NUTSERT | P | 4 | 80 |  |  |  |  |  |  |  |  | EA
5 | 001-1054-1-F |  | SUPPORT | D | 1 | 20 |  |  |  |  |  |  |  |  | EA
6 | 6061-T6 .090 250/11 |  | SHEET | R | .243 | 4.86 |  |  |  |  |  |  |  |  | SF
4 | 001-1102-1-D |  | COLLAR WELDMENT | A | 2 | 20 |  |  |  |  |  |  |  |  | EA
5 | 001-1102-1S-D |  | COLLAR,CAD PLATE | S | 1 | 20 |  |  |  |  |  |  |  |  | EA
5 | 001-1102-3-D |  | TUBE | D | 1 | 20 |  |  |  |  |  |  |  |  | EA
6 | 4130 1.00ODX.134W |  | TUBE,MIL-T-6736 | R | .042 | 0.84 |  |  |  |  |  |  |  |  | FT
5 | 001-1102-5-D |  | ACTUATOR | D | 1 | 20 |  |  |  |  |  |  |  |  | EA
6 | 1020 .25X.25 |  | BAR | R | .031 | 0.62 |  |  |  |  |  |  |  |  | FT
4 | 001-1110-9-J |  | SHAFT ASSY | A | 1 | 10 |  |  |  |  |  |  |  |  | EA
5 | 001-1110-1-J |  | SHAFT | S | 1 | 10 |  |  |  |  |  |  |  |  | EA
5 | 1MLBF577-4 | 72962 | NUT,BARREL | P | 2 | 20 |  |  |  |  |  |  |  |  | EA
5 | 2577-048RET | 72962 | RETAINER | P | 2 | 20 |  |  |  |  |  |  |  |  | EA
4 | F3NY-187NA | 62619 | CLAMP | P | 3 | 30 |  |  |  |  |  |  |  |  | EA
4 | 111SM2-T | 91929 | SWITCH | P | 2 | 20 |  |  |  |  |  |  |  |  | EA
4 | 4X729 | 25795 | PILLOW BLOCK | P | 2 | 20 |  |  |  |  |  |  |  |  | EA
4 | 1N4002 |  | DIODE | P | 2 | 20 |  |  |  |  |  |  |  |  | EA
4 | 6H1 | 05245 | FILTER | P | 1 | 10 |  |  |  |  |  |  |  |  | EA
4 | 001-0142-D |  | ANGLE | D | 1 | 10 |  |  |  |  |  |  |  |  | EA
5 | 6061-T6 .25X1.5X1.5 |  | ANGLE | R | .167 | 1.67 |  |  |  |  |  |  |  |  | FT
4 | NAS1068A4 |  | NUTPLATE | P | 1 | 10 |  |  |  |  |  |  |  |  | EA
4 | MS20426AD3-8 |  | RIVET | P | 2 | 20 |  |  |  |  |  |  |  |  | EA
4 | 001-1080-1-Y |  | INSULATOR | D | 1 | 10 |  |  |  |  |  |  |  |  | EA
5 | NO.560 .010 FIBEROID | 72653 | PAPER, FISH | R | .005 | 0.05 |  |  |  |  |  |  |  |  | RL
4 | 001-1075-9-G |  | INNER STRUCTURE ASSY | A | 1 | 10 |  |  |  |  |  |  |  |  | EA
5 | 001-1052-1-B |  | BULKHEAD | D | 1 | 10 |  |  |  |  |  |  |  |  | EA
6 | 056-00021-1-R |  | BULKHEAD | M | 1 | 10 |  |  |  |  |  |  |  |  | EA
7 | 056-00021-1S-R |  | BULKHEAD,FORM | X | 1 | 10 |  |  |  |  |  |  |  |  | EA
7 | 2024-0 .063 250/4 |  | SHEET | Q | 1.24 | 12.4 |  |  |  |  |  |  |  |  | SF
5 | 001-1053-1-F |  | SUPPORT | D | 1 | 10 |  |  |  |  |  |  |  |  | EA
6 | 6061-T6 .090 250/11 |  | SHEET | R | .486 | 4.9 |  |  |  |  |  |  |  |  | SF
5 | 001-1053-3-F |  | SUPPORT | D | 2 | 20 |  |  |  |  |  |  |  |  | EA
6 | 6061-T6 .090 250/11 |  | SHEET | R | .486 | 9.79 |  |  |  |  |  |  |  |  | SF
5 | 001-1158-E |  | BULKHEAD | D | 1 | 10 |  |  |  |  |  |  |  |  | EA
6 | 056-00021-1-R |  | BULKHEAD | M | 1 | 10 |  |  |  |  |  |  |  |  | EA
7 | 056-00021-1S-R |  | BULKHEAD,FORM | X | 1 | 10 |  |  |  |  |  |  |  |  | EA
7 | 2024-0 .063 250/4 |  | SHEET | Q | 1.24 | 12.4 |  |  |  |  |  |  |  |  | SF
5 | CCR264CS-3-03 | 11815 | RIVET | P | 4 | 40 |  |  |  |  |  |  |  |  | EA
5 | MS20426AD5-5 |  | RIVET | P | 12 | 120 |  |  |  |  |  |  |  |  | EA
5 | NAS1068A08 |  | NUTPLATE | P | 2 | 20 |  |  |  |  |  |  |  |  | EA
5 | 9505-08 | 19738 | NUTSERT | P | 3 | 30 |  |  |  |  |  |  |  |  | EA
5 | 9655-08 | 19738 | NUTSERT | P | 2 | 20 |  |  |  |  |  |  |  |  | EA
4 | AN6-5 |  | BOLT | P | 4 | 40 |  |  |  |  |  |  |  |  | EA
4 | MS21083N6 |  | NUT | P | 4 | 40 |  |  |  |  |  |  |  |  | EA
4 | CL-257 | 99862 | WASHER | P | 4 | 40 |  |  |  |  |  |  |  |  | EA
4 | MS35206-244 |  | SCREW | P | 8 | 80 |  |  |  |  |  |  |  |  | EA
4 | MS21083N08 |  | NUT | P | 8 | 80 |  |  |  |  |  |  |  |  | EA
4 | MS35206-208 |  | SCREW | P | 4 | 40 |  |  |  |  |  |  |  |  | EA
4 | MS21042-02 |  | NUT | P | 6 | 60 |  |  |  |  |  |  |  |  | EA
4 | MS21083N04 |  | NUT | P | 4 | 40 |  |  |  |  |  |  |  |  | EA
4 | AN565A8H3 |  | SCREW,SET | P | 4 | 40 |  |  |  |  |  |  |  |  | EA
4 | MS15795-802 |  | WASHER | P | 4 | 40 |  |  |  |  |  |  |  |  | EA
4 | AN960-8 |  | WASHER | P | 2 | 20 |  |  |  |  |  |  |  |  | EA
4 | MS35206-243 |  | SCREW | P | 2 | 20 |  |  |  |  |  |  |  |  | EA
4 | MS3367-1-9 |  | STRAP | P | 1 | 10 |  |  |  |  |  |  |  |  | EA
4 | MS35206-205 |  | SCREW | P | 2 | 20 |  |  |  |  |  |  |  |  | EA
4 | MS35206-246 |  | SCREW | P | 6 | 60 |  |  |  |  |  |  |  |  | EA
4 | 22231 | 05972 | THREAD LOCK | R | .01 | 0.1 |  |  |  |  |  |  |  |  | BT
4 | 001-1151-E |  | STIFFENER | D | 1 | 10 |  |  |  |  |  |  |  |  | EA
5 | 6061-T6 .063 250/11 |  | SHEET | R | .11 | 1.1 |  |  |  |  |  |  |  |  | SF
4 | ASK-3 | 06915 | CLIP | P | 2 | 20 |  |  |  |  |  |  |  |  | EA
4 | MS20426AD4-5 |  | RIVET | P | 5 | 50 |  |  |  |  |  |  |  |  | EA
4 | MS24694-S4 |  | SCREW | P | 1 | 10 |  |  |  |  |  |  |  |  | EA
4 | 3059J-1-203 | 32997 | POTENTIOMETER | P | 1 | 10 |  |  |  |  |  |  |  |  | EA
4 | M83519/2-8 |  | SLEEVE,SOLDER | P | 1 | 10 |  |  |  |  |  |  |  |  | EA
4 | 001-1375-9-D |  | SERVO AMP ASSY | A | 1 | 10 |  |  |  |  |  |  |  |  | EA
5 | 001-1377-9-F |  | PC BOARD ASSY | A | 1 | 10 |  |  |  |  |  |  |  |  | EA
6 | 001-1376-B |  | PC BOARD | S | 1 | 10 |  |  |  |  |  |  |  |  | EA
6 | 30GAT27 | 11187 | CAPACITOR | P | 1 | 10 |  |  |  |  |  |  |  |  | EA
6 | RC07GF103J |  | RESISTOR | P | 2 | 20 |  |  |  |  |  |  |  |  | EA
6 | 199D335X0035BA1 | 56289 | CAPACITOR | P | 1 | 10 |  |  |  |  |  |  |  |  | EA
6 | RC07GF303J |  | RESISTOR | P | 2 | 20 |  |  |  |  |  |  |  |  | EA
6 | RC07GF512J |  | RESISTOR | P | 2 | 20 |  |  |  |  |  |  |  |  | EA
6 | RC07GF134J |  | RESISTOR | P | 2 | 20 |  |  |  |  |  |  |  |  | EA
6 | RC07GF243J |  | RESISTOR | P | 2 | 20 |  |  |  |  |  |  |  |  | EA
6 | 199D476X0035FE2 | 56289 | CAPACITOR | P | 1 | 10 |  |  |  |  |  |  |  |  | EA
6 | QQW343S20SIT |  | WIRE,JUMPER | R | .33 | 3.3 |  |  |  |  |  |  |  |  | FT
6 | 199D106X0035DA1 | 56289 | CAPACITOR,10UF,33V | P | 2 | 20 |  |  |  |  |  |  |  |  | EA
6 | 001-1378-B |  | SCHEMATIC | T | 1 | 10 |  |  |  |  |  |  |  |  | EA
5 | 001-1379-D |  | BRACKET | D | 1 | 10 |  |  |  |  |  |  |  |  | EA
6 | 6061-T6 .032 250/11 |  | SHEET | R | .133 | 1.33 |  |  |  |  |  |  |  |  | SF
5 | MS35206-226 |  | SCREW | P | 4 | 40 |  |  |  |  |  |  |  |  | EA
5 | MS35206-217 |  | SCREW | P | 4 | 40 |  |  |  |  |  |  |  |  | EA
5 | MS21083N04 |  | NUT | P | 4 | 40 |  |  |  |  |  |  |  |  | EA
5 | NAS43DD0-12 |  | SPACER | P | 4 | 40 |  |  |  |  |  |  |  |  | EA
5 | LWNY-002BK | 95987 | WASHER | P | 4 | 40 |  |  |  |  |  |  |  |  | EA
5 | LM12CLK | 27014 | POWER OP AMP | P | 2 | 20 |  |  |  |  |  |  |  |  | EA
5 | 001-1122-19-G |  | CABLE ASSY | A | 1 | 10 |  |  |  |  |  |  |  |  | EA
6 | MS3116E10-6P |  | CONNECTOR | P | 1 | 10 |  |  |  |  |  |  |  |  | EA
6 | M22759/13-20-9 |  | WIRE,WHITE | R | 17 | 170 |  |  |  |  |  |  |  |  | FT
6 | MS3367-1-9 |  | STRAP | P | 8 | 80 |  |  |  |  |  |  |  |  | EA
5 | MS21083N06 |  | NUT | P | 4 | 40 |  |  |  |  |  |  |  |  | EA
4 | MS35206-217 |  | SCREW | P | 4 | 40 |  |  |  |  |  |  |  |  | EA
4 | M16878/1BEE9 |  | WIRE,24,WHITE | R | 4 | 40 |  |  |  |  |  |  |  |  | FT
4 | M16878/1BGE9 |  | WIRE,20,WHITE | R | 4.67 | 46.71 |  |  |  |  |  |  |  |  | FT
4 | NAS43DD0-12 |  | SPACER | P | 4 | 40 |  |  |  |  |  |  |  |  | EA
4 | MS3367-4-9 |  | STRAP | P | 7 | 70 |  |  |  |  |  |  |  |  | EA
4 | 001-1204-E |  | SCHEMATIC | T | 1 | 10 |  |  |  |  |  |  |  |  | EA
3 | MS21266-2N |  | GROMMET | R | .67 | 6.7 |  |  |  |  |  |  |  |  | FT
3 | NAS43DD3-68 |  | SPACER | P | 4 | 40 |  |  |  |  |  |  |  |  | EA
3 | MS21083N3 |  | NUT | P | 4 | 40 |  |  |  |  |  |  |  |  | EA
3 | 001-1238-9-E |  | BRACKET ASSY | A | 1 | 10 |  |  |  |  |  |  |  |  | EA
4 | 001-1259-C |  | BRACKET | D | 1 | 10 |  |  |  |  |  |  |  |  | EA
5 | 6061-T6 .050 250/11 |  | SHEET | R | .243 | 2.43 |  |  |  |  |  |  |  |  | SF
4 | MS20470A3-3 |  | RIVET | P | 2 | 20 |  |  |  |  |  |  |  |  | EA
4 | MS25036-150 |  | TERMINAL | P | 1 | 10 |  |  |  |  |  |  |  |  | EA
4 | MS25036-103 |  | TERMINAL | P | 2 | 20 |  |  |  |  |  |  |  |  | EA
4 | AN960D10 |  | WASHER | P | 3 | 30 |  |  |  |  |  |  |  |  | EA
4 | 1682-0412 | 19738 | RIVET | P | 2 | 20 |  |  |  |  |  |  |  |  | EA
4 | 1604-0615 | 19738 | RIVET | P | 3 | 30 |  |  |  |  |  |  |  |  | EA
4 | 9655-08 | 19738 | NUTSERT | P | 4 | 40 |  |  |  |  |  |  |  |  | EA
4 | 856 | 91833 | TERMINAL STRIP | P | 1 | 10 |  |  |  |  |  |  |  |  | EA
4 | 2K-1B-126 | 02289 | RELAY | P | 1 | 10 |  |  |  |  |  |  |  |  | EA
4 | 8RD3024A | 31211 | REGULATOR | P | 1 | 10 |  |  |  |  |  |  |  |  | EA
4 | M16878/1BGE0 |  | WIRE,20,BLACK | R | 1 | 10 |  |  |  |  |  |  |  |  | FT
4 | M16878/1BGE2 |  | WIRE,20,RED | R | 1 | 10 |  |  |  |  |  |  |  |  | FT
4 | M16878/1BGE5 |  | WIRE,20,GREEN | R | 1 | 10 |  |  |  |  |  |  |  |  | FT
3 | 001-1155-6-B |  | DECAL | D | 1 | 10 |  |  |  |  |  |  |  |  | EA
4 | B-61H-250 |  | TYVEX | R | .01 | 0.1 |  |  |  |  |  |  |  |  | RL
3 | MS35206-244 |  | SCREW | P | 4 | 40 |  |  |  |  |  |  |  |  | EA
3 | 001-1204-E |  | SCHEMATIC | T | 1 | 10 |  |  |  |  |  |  |  |  | EA
3 | 001-5054-D |  | PROCEDURE,ASSEMBLY | T | 1 | 10 |  |  |  |  |  |  |  |  | EA
2 | 201-121041-00 | 02768 | RIVET | P | 3 | 30 |  |  |  |  |  |  |  |  | EA
2 | 001-1374-9 |  | CABLE ASSY | A | 1 | 10 |  |  |  |  |  |  |  |  | EA
3 | UG-913A/U |  | CONNECTOR | P | 1 | 10 |  |  |  |  |  |  |  |  | EA
3 | 2031-5002-02 | 26805 | CONNECTOR | P | 1 | 10 |  |  |  |  |  |  |  |  | EA
3 | RG-223/U |  | CABLE,COAX | R | 4.09 | 40.9 |  |  |  |  |  |  |  |  | FT
2 | 001-1382-9-C |  | CABLE ASSY | A | 1 | 10 |  |  |  |  |  |  |  |  | EA
3 | MS3116E8-4S |  | CONNECTOR | P | 1 | 10 |  |  |  |  |  |  |  |  | EA
3 | MS3116E8-4P |  | CONNECTOR | P | 1 | 10 |  |  |  |  |  |  |  |  | EA
3 | M83519/2-2 |  | SLEEVE,SOLDER | P | 2 | 20 |  |  |  |  |  |  |  |  | EA
3 | M22759/13-20-9 |  | WIRE,WHITE | R | 10.7 | 107 |  |  |  |  |  |  |  |  | FT
3 | M27500-20ML1T08 |  | WIRE | R | 5.33 | 53.3 |  |  |  |  |  |  |  |  | FT
3 | MS3367-4-9 |  | STRAP | P | 16 | 160 |  |  |  |  |  |  |  |  | EA
2 | 001-1202-9-E |  | CABLE ASSY | A | 1 | 10 |  |  |  |  |  |  |  |  | EA
3 | PT06E-8-2P | 77820 | CONNECTOR | P | 1 | 10 |  |  |  |  |  |  |  |  | EA
3 | PT06E-8-2S | 77820 | CONNECTOR | P | 1 | 10 |  |  |  |  |  |  |  |  | EA
3 | 206708-1 | 00779 | PLUG | P | 1 | 10 |  |  |  |  |  |  |  |  | EA
3 | 66105-2 | 00779 | SOCKET | P | 4 | 40 |  |  |  |  |  |  |  |  | EA
3 | MS25036-108 |  | TERMINAL | P | 1 | 10 |  |  |  |  |  |  |  |  | EA
3 | MS25036-154 |  | TERMINAL | P | 1 | 10 |  |  |  |  |  |  |  |  | EA
3 | 66360-2 | 00779 | SOCKET | P | 2 | 20 |  |  |  |  |  |  |  |  | EA
3 | M16878/1BKE2 |  | WIRE,14,RED | R | 4.17 | 41.71 |  |  |  |  |  |  |  |  | FT
3 | M16878/1BGE0 |  | WIRE,20,BLACK | R | 7.5 | 75 |  |  |  |  |  |  |  |  | FT
3 | M16878/1BGE2 |  | WIRE,20,RED | R | 6.5 | 65 |  |  |  |  |  |  |  |  | FT
3 | MS3367-4-9 |  | STRAP | P | 12 | 120 |  |  |  |  |  |  |  |  | EA
3 | M16878/1BKE0 |  | WIRE,14,BLACK | R | 4.17 | 41.71 |  |  |  |  |  |  |  |  | FT
1 | 001-1372-9-B |  | CABLE ASSY | A | 1 | 10 |  |  |  |  |  |  |  |  | EA
2 | MS3116F10-98P |  | CONNECTOR | P | 1 | 10 |  |  |  |  |  |  |  |  | EA
2 | 5196 | 92194 | CABLE | R | 1.09 | 10.9 |  |  |  |  |  |  |  |  | FT
2 | MS25036-102 |  | TERMINAL | P | 1 | 10 |  |  |  |  |  |  |  |  | EA
1 | 001-1373-9-C |  | ANTENNA ASSY | A | 2 | 20 |  |  |  |  |  |  |  |  | EA
2 | 1900-0457-00 |  | ANTENNA | X | 1 | 20 |  |  |  |  |  |  |  |  | EA
2 | 1910-6785-02 |  | GASKET | X | 2 | 40 |  |  |  |  |  |  |  |  | EA
2 | 001-1366-9 |  | BRACKET ASSY | A | 1 | 20 |  |  |  |  |  |  |  |  | EA
3 | 001-1366-1 |  | BRACKET | D | 1 | 20 |  |  |  |  |  |  |  |  | EA
4 | 6061-T6 .050 250/11 |  | SHEET | R | .218 | 4.36 |  |  |  |  |  |  |  |  | SF
3 | 9655-08 | 19738 | NUTSERT | P | 4 | 80 |  |  |  |  |  |  |  |  | EA
2 | MS35206-231 |  | SCREW | P | 4 | 80 |  |  |  |  |  |  |  |  | EA
2 | MS21083N06 |  | NUT | P | 4 | 80 |  |  |  |  |  |  |  |  | EA
1 | 001-1412-9-A |  | CABLE ASSY | A | 1 | 10 |  |  |  |  |  |  |  |  | EA
2 | MS3116E8-4PW |  | CONNECTOR | P | 2 | 20 |  |  |  |  |  |  |  |  | EA
2 | M83519/2-2 |  | SLEEVE,SOLDER | P | 2 | 20 |  |  |  |  |  |  |  |  | EA
2 | M27500-20ML1T08 |  | WIRE | R | .75 | 7.5 |  |  |  |  |  |  |  |  | FT
2 | M22759/13-20-9 |  | WIRE,WHITE | R | 1.5 | 15 |  |  |  |  |  |  |  |  | FT
2 | MS3367-4-9 |  | STRAP | P | 4 | 40 |  |  |  |  |  |  |  |  | EA
1 | MS24693-S62 |  | SCREW | P | 3 | 30 |  |  |  |  |  |  |  |  | EA
1 | MS21083N08 |  | NUT | P | 3 | 30 |  |  |  |  |  |  |  |  | EA
1 | 001-5057-J |  | PROCEDURE,TEST | T | 1 | 10 |  |  |  |  |  |  |  |  | EA
1 | 001-1398-E |  | SCHEMATIC | T | 1 | 10 |  |  |  |  |  |  |  |  | EA

Sheet: 0011117G
I | PART | FED MFG |  | T | NHA | TOTAL | QTY ON | QTY | DATE | QTY | TRANS | RFP | RFP | UNIT | UN
N | NUMBER | CODE | DESCRIPTION | Y | QTY | QTY | ORDER | REC | REC | TRANS | NO | NUMBER | DATE | PRICE | IS
1 | 001-1117-9-G |  | COMPUTER ASSY | A | 1 | 10 |  |  |  |  |  |  |  |  | EA
2 | 001-1114-9-M |  | COMPUTER SUBASSY | A | 1 | 10 |  |  |  |  |  |  |  |  | EA
3 | 001-1103-9-F |  | FRAME ASSY | A | 1 | 10 |  |  |  |  |  |  |  |  | EA
4 | 001-1167-1-B |  | BAR | S | 2 | 20 |  |  |  |  |  |  |  |  | EA
4 | 001-1167-3-B |  | BAR | S | 8 | 80 |  |  |  |  |  |  |  |  | EA
4 | 001-1167-5-B |  | BAR | S | 2 | 20 |  |  |  |  |  |  |  |  | EA
4 | 001-1167-7-B |  | BAR | S | 1 | 10 |  |  |  |  |  |  |  |  | EA
4 | 001-1167-11-B |  | BAR | S | 2 | 20 |  |  |  |  |  |  |  |  | EA
4 | 001-1167-13-B |  | BAR | S | 1 | 10 |  |  |  |  |  |  |  |  | EA
4 | 001-1180-9-B |  | COVER ASSY | A | 1 | 10 |  |  |  |  |  |  |  |  | EA
5 | 001-1104-3-J |  | COVER | D | 1 | 10 |  |  |  |  |  |  |  |  | EA
6 | 6061-T6 .050 250/11 |  | SHEET | R | .997 | 9.97 |  |  |  |  |  |  |  |  | SF
5 | 001-1112-1-B |  | SPACER | D | 4 | 40 |  |  |  |  |  |  |  |  | EA
6 | 6061-T6 .050 250/11 |  | SHEET | R | .024 | 0.96 |  |  |  |  |  |  |  |  | SF
5 | 001-1112-3-B |  | SPACER | D | 2 | 20 |  |  |  |  |  |  |  |  | EA
6 | 6061-T6 .050 250/11 |  | SHEET | R | .011 | 0.22 |  |  |  |  |  |  |  |  | SF
5 | 001-1113-C |  | SLIDE | D | 2 | 20 |  |  |  |  |  |  |  |  | EA
6 | PRD-6875 | 07556 | CARD GUIDE | P | .5 | 10 |  |  |  |  |  |  |  |  | EA
5 | MS20470A4-5 |  | RIVET | P | 12 | 120 |  |  |  |  |  |  |  |  | EA
5 | PRD-6875 | 07556 | CARD GUIDE | P | 4 | 40 |  |  |  |  |  |  |  |  | EA
4 | MS35206-214 |  | SCREW | P | 26 | 260 |  |  |  |  |  |  |  |  | EA
4 | MS20470AD3-7 |  | RIVET | P | 26 | 260 |  |  |  |  |  |  |  |  | EA
4 | RTV-102 | 01139 | ADHESIVE | R | .01 | 0.1 |  |  |  |  |  |  |  |  | TU
3 | 001-1119-9-J |  | PC BOARD ASSY | A | 1 | 10 |  |  |  |  |  |  |  |  | EA
4 | 001-1120-D |  | PC BOARD | S | 1 | 10 |  |  |  |  |  |  |  |  | EA
4 | PKA2314P | 72347 | POWER SUPPLY | P | 1 | 10 |  |  |  |  |  |  |  |  | EA
4 | CSR13F476KM |  | CAPACITOR,47UF,35VDC | P | 1 | 10 |  |  |  |  |  |  |  |  | EA
4 | 109D827X9015T2 | 56289 | CAPACITOR,820UF,15DC | P | 1 | 10 |  |  |  |  |  |  |  |  | EA
4 | 001-5092 |  | PROCEDURE,TEST | T | 1 | 10 |  |  |  |  |  |  |  |  | EA
3 | 001-1174-9-D |  | CABLE ASSY, A/D BD. | A | 1 | 10 |  |  |  |  |  |  |  |  | EA
4 | 843-191-2801-020 | 02660 | CABLE,RIBBON | R | .5 | 5 |  |  |  |  |  |  |  |  | FT
4 | 842-812-2003-134 | 02660 | SOCKET | P | 2 | 20 |  |  |  |  |  |  |  |  | EA
4 | 842-812-1003-134 | 02660 | SOCKET | P | 1 | 10 |  |  |  |  |  |  |  |  | EA
4 | 001-1116-D |  | SCHEMATIC | T | 1 | 10 |  |  |  |  |  |  |  |  | EA
3 | 001-1188-9-H |  | INTERFACE BOARD ASSY | S | 1 | 10 |  |  |  |  |  |  |  |  | EA
4 | 001-1233-D |  | PC BOARD | T | 1 | 10 |  |  |  |  |  |  |  |  | EA
4 | 001-1234-A |  | SCHEMATIC | T | 1 | 10 |  |  |  |  |  |  |  |  | EA
4 | STD-0155 |  | PROCEDURE,ESD | T | 1 | 10 |  |  |  |  |  |  |  |  | EA
4 | 001-5095 |  | TEST PROCEDURE | T | 1 | 10 |  |  |  |  |  |  |  |  | EA
3 | 001-1218-9-H |  | 1805 CPU ASSY | A | 1 | 10 |  |  |  |  |  |  |  |  | EA
4 | 001-1224-9-K |  | EPROM ASSY | A | 1 | 10 |  |  |  |  |  |  |  |  | EA
5 | MD2716M |  | EPROM | P | 1 | 10 |  |  |  |  |  |  |  |  | EA
5 | 001-1224-1-K |  | DECAL | D | 1 | 10 |  |  |  |  |  |  |  |  | EA
6 | B-61H-250 | 96707 | TYVEX | R | .01 | 0.1 |  |  |  |  |  |  |  |  | RL
5 | STD-0155 |  | PROCEDURE,ESD | T | 1 | 10 |  |  |  |  |  |  |  |  | EA
5 | 001-5097-A |  | PROCEDURE,TEST | T | 1 | 10 |  |  |  |  |  |  |  |  | EA
5 | 001-1331-A |  | OBJECT CODE,EPROM | T | 1 | 10 |  |  |  |  |  |  |  |  | EA
4 | MB606 | MATRIC | 1805 CPU BOARD | P | 1 | 10 |  |  |  |  |  |  |  |  | EA
4 | RTV-162 | 01139 | ADHESIVE | R | .01 | 0.1 |  |  |  |  |  |  |  |  | TU
4 | 001-1224-19-K |  | EPROM ASSY | X | 1 | 10 |  |  |  |  |  |  |  |  | EA
5 | MD2716M |  | EPROM | X | 1 | 10 |  |  |  |  |  |  |  |  | EA
5 | 001-1224-3-K |  | DECAL | X | 1 | 10 |  |  |  |  |  |  |  |  | EA
6 | B-61H-250 | 96707 | TYVEX | X | .01 | 0.1 |  |  |  |  |  |  |  |  | RL
5 | STD-0155 |  | PROCEDURE,ESD | T | 1 | 10 |  |  |  |  |  |  |  |  | EA
5 | 001-5097-A |  | PROCEDURE,TEST | T | 1 | 10 |  |  |  |  |  |  |  |  | EA
5 | 001-1440 |  | OBJECT CODE,EPROM | T | 1 | 10 |  |  |  |  |  |  |  |  | EA
4 | 001-5098 |  | PROCEDURE,TEST | T | 1 | 10 |  |  |  |  |  |  |  |  | EA
3 | 001-1219-D |  | TM ENCODER | D | 1 | 10 |  |  |  |  |  |  |  |  | EA
4 | 001-5043-C |  | ENCODER BOARD ASSY | S | 1 | 10 |  |  |  |  |  |  |  |  | EA
4 | STD-0155 |  | PROCEDURE,ESD | T | 1 | 10 |  |  |  |  |  |  |  |  | EA
4 | 001-5094 |  | PROCEDURE,TEST | T | 1 | 10 |  |  |  |  |  |  |  |  | EA
3 | M16878/1BEE9 |  | WIRE,24,WHITE | R | 140 | 1400 |  |  |  |  |  |  |  |  | FT
3 | MS35206-217 |  | SCREW | P | 12 | 120 |  |  |  |  |  |  |  |  | EA
3 | 001-1424-A |  | A/D-D/A BOARD MOD | D | 1 | 10 |  |  |  |  |  |  |  |  | EA
4 | MB654A | MATRIC | A/D-D/A CONVERTER | P | 1 | 10 |  |  |  |  |  |  |  |  | EA
4 | RTV-162 | 01139 | ADHESIVE | R | .01 | 0.1 |  |  |  |  |  |  |  |  | TU
4 | 001-5096 |  | PROCEDURE,TEST | T | 1 | 10 |  |  |  |  |  |  |  |  | EA
3 | 001-1173 |  | BACKPLANE,COMPUTER | S | 1 | 10 |  |  |  |  |  |  |  |  | EA
3 | 001-5042-D |  | DECODER BOARD ASSY | S | 1 | 10 |  |  |  |  |  |  |  |  | EA
4 | 001-5093 |  | TEST PROCEDURE | T | 1 | 10 |  |  |  |  |  |  |  |  | EA
3 | 143-022-01-(110) | 13511 | CONNECTOR | P | 3 | 30 |  |  |  |  |  |  |  |  | EA
3 | 50-44SN-9 | 71785 | CONNECTOR | P | 1 | 10 |  |  |  |  |  |  |  |  | EA
3 | 583616-4 | 00779 | PIN | P | 19 | 190 |  |  |  |  |  |  |  |  | EA
3 | 583717-5 | 00779 | CONNECTOR | P | 1 | 10 |  |  |  |  |  |  |  |  | EA
3 | 22231 | 05972 | THREAD LOCK | R | .01 | 0.1 |  |  |  |  |  |  |  |  | BT
3 | 001-1116-D |  | SCHEMATIC | T | 1 | 10 |  |  |  |  |  |  |  |  | EA
3 | 001-1175-C |  | WIRE LIST | T | 1 | 10 |  |  |  |  |  |  |  |  | EA
3 | STD-0155 |  | PROCEDURE,ESD | T | 1 | 10 |  |  |  |  |  |  |  |  | EA
3 | 001-5055-H |  | PROCEDURE,TEST | T | 1 | 10 |  |  |  |  |  |  |  |  | EA
2 | 001-1115-9-G |  | TRAY ASSY | A | 1 | 10 |  |  |  |  |  |  |  |  | EA
3 | 001-1115-1-G |  | TRAY | D | 1 | 10 |  |  |  |  |  |  |  |  | EA
4 | 6061-T6 .050 250/11 |  | SHEET | R | .486 | 4.86 |  |  |  |  |  |  |  |  | SF
3 | 9655-08 | 19738 | NUTSERT | P | 6 | 60 |  |  |  |  |  |  |  |  | EA
2 | 001-1169-9-J |  | COVER/EXTENSION ASSY | A | 1 | 10 |  |  |  |  |  |  |  |  | EA
3 | 001-1176-1-B |  | COVER,TOP | D | 1 | 10 |  |  |  |  |  |  |  |  | EA
4 | 6061-T6 .050 250/11 |  | SHEET | R | .043 | 0.43 |  |  |  |  |  |  |  |  | SF
3 | 001-1176-3-B |  | COVER,SIDE | D | 1 | 10 |  |  |  |  |  |  |  |  | EA
4 | 6061-T6 .050 250/11 |  | SHEET | R | .035 | 0.35 |  |  |  |  |  |  |  |  | SF
3 | 001-1177-1-A |  | BAR | S | 2 | 20 |  |  |  |  |  |  |  |  | EA
3 | 001-1177-11-A |  | BAR | S | 1 | 10 |  |  |  |  |  |  |  |  | EA
3 | 001-1177-13-A |  | BAR | S | 1 | 10 |  |  |  |  |  |  |  |  | EA
3 | 001-1177-14-A |  | BAR | S | 1 | 10 |  |  |  |  |  |  |  |  | EA
3 | 001-1177-3-A |  | BAR | S | 1 | 10 |  |  |  |  |  |  |  |  | EA
3 | 001-1177-5-A |  | BAR | S | 1 | 10 |  |  |  |  |  |  |  |  | EA
3 | 001-1177-7-A |  | BAR | S | 1 | 10 |  |  |  |  |  |  |  |  | EA
3 | 001-1178-9-D |  | COVER ASSY | A | 1 | 10 |  |  |  |  |  |  |  |  | EA
4 | 001-1168-9-B |  | BUMPER ASSY | A | 2 | 20 |  |  |  |  |  |  |  |  | EA
5 | 001-1168-1-B |  | BUMPER | D | 1 | 20 |  |  |  |  |  |  |  |  | EA
6 | 6061-T6 .032 250/11 |  | SHEET | R | .008 | 0.16 |  |  |  |  |  |  |  |  | SF
5 | 001-1168-3-B |  | INSULATION | D | 1 | 20 |  |  |  |  |  |  |  |  | EA
6 | NES-41B-.25A | 72781 | SHEET,SPONGE RUBBER | R | .003 | 0.06 |  |  |  |  |  |  |  |  | SF
4 | 001-1104-11-J |  | COVER | D | 1 | 10 |  |  |  |  |  |  |  |  | EA
5 | 6061-T6 .050 250/11 |  | SHEET | R | .209 | 2.09 |  |  |  |  |  |  |  |  | SF
4 | MS20470AD3-4 |  | RIVET | P | 4 | 40 |  |  |  |  |  |  |  |  | EA
4 | 1201-052 | 51406 | FILTER & HARDWARE | P | 21 | 210 |  |  |  |  |  |  |  |  | EA
4 | 856 | 91833 | TERMINAL STRIP | P | 1 | 10 |  |  |  |  |  |  |  |  | EA
4 | MS20470AD3-3 |  | RIVET | P | 2 | 20 |  |  |  |  |  |  |  |  | EA
3 | 001-1181-9-C |  | COVER ASSY | A | 1 | 10 |  |  |  |  |  |  |  |  | EA
4 | 001-1104-1-J |  | COVER | D | 1 | 10 |  |  |  |  |  |  |  |  | EA
5 | 6061-T6 .050 250/11 |  | SHEET | R | .209 | 2.09 |  |  |  |  |  |  |  |  | SF
4 | MS21083N04 |  | NUT | P | 32 | 320 |  |  |  |  |  |  |  |  | EA
4 | MS3112E10-6S |  | CONNECTOR | P | 1 | 10 |  |  |  |  |  |  |  |  | EA
4 | MS3112E10-6SW |  | CONNECTOR | P | 1 | 10 |  |  |  |  |  |  |  |  | EA
4 | MS3112E10-98S |  | CONNECTOR | P | 1 | 10 |  |  |  |  |  |  |  |  | EA
4 | MS3112E14-19S |  | CONNECTOR | P | 1 | 10 |  |  |  |  |  |  |  |  | EA
4 | MS3112E8-33S |  | CONNECTOR | P | 1 | 10 |  |  |  |  |  |  |  |  | EA
4 | MS3112E8-4S |  | CONNECTOR | P | 1 | 10 |  |  |  |  |  |  |  |  | EA
4 | MS3112E8-4SW |  | CONNECTOR | P | 1 | 10 |  |  |  |  |  |  |  |  | EA
4 | MS35206-214 |  | SCREW | P | 32 | 320 |  |  |  |  |  |  |  |  | EA
4 | PT02E-8-2P | 77820 | CONNECTOR | P | 1 | 10 |  |  |  |  |  |  |  |  | EA
4 | 10-101949-10 | 77820 | GASKET | P | 3 | 30 |  |  |  |  |  |  |  |  | EA
4 | 10-101949-14 | 77820 | GASKET | P | 1 | 10 |  |  |  |  |  |  |  |  | EA
4 | 10-101949-8 | 77820 | GASKET | P | 4 | 40 |  |  |  |  |  |  |  |  | EA
4 | 10-101960-145 | 77820 | CAP,PROTECTION | P | 1 | 10 |  |  |  |  |  |  |  |  | EA
4 | 10-101960-105 | 77820 | CAP,PROTECTION | P | 1 | 10 |  |  |  |  |  |  |  |  | EA
4 | 7326 | 91833 | LUG,SOLDER | P | 1 | 10 |  |  |  |  |  |  |  |  | EA
3 | MS20470AD3-7 |  | RIVET | P | 28 | 280 |  |  |  |  |  |  |  |  | EA
3 | MS35206-214 |  | SCREW | P | 38 | 380 |  |  |  |  |  |  |  |  | EA
3 | M16878/1BEE9 |  | WIRE,24,WHITE | R | 45 | 450 |  |  |  |  |  |  |  |  | FT
3 | RCR07G562J |  | RESISTOR | P | 1 | 10 |  |  |  |  |  |  |  |  | EA
3 | FIT-221-3/32Y | 92194 | SHRINK TUBING | R | .17 | 1.7 |  |  |  |  |  |  |  |  | FT
3 | RTV-102 | 01139 | ADHESIVE | R | .01 | 0.1 |  |  |  |  |  |  |  |  | TU
3 | 001-1175-C |  | WIRE LIST | T | 1 | 10 |  |  |  |  |  |  |  |  | EA
3 | 001-1116-D |  | SCHEMATIC | T | 1 | 10 |  |  |  |  |  |  |  |  | EA
2 | 001-1179-9-C |  | COVER ASSY | A | 1 | 10 |  |  |  |  |  |  |  |  | EA
3 | 001-1104-7-J |  | COVER | D | 1 | 10 |  |  |  |  |  |  |  |  | EA
4 | 6061-T6 .050 250/11 |  | SHEET | R | .146 | 1.46 |  |  |  |  |  |  |  |  | SF
3 | MS20470AD3-4 |  | RIVET | P | 2 | 20 |  |  |  |  |  |  |  |  | EA
3 | 001-1179-1-C |  | SHEET,RUBBER | D | 2 | 20 |  |  |  |  |  |  |  |  | EA
4 | NES-41B-.75A |  | SHEET,SPONGE RUBBER | R | .013 | 0.26 |  |  |  |  |  |  |  |  | SF
3 | 001-1179-3-C |  | ANGLE | D | 1 | 10 |  |  |  |  |  |  |  |  | EA
4 | 6061-T6 .032 250/11 |  | SHEET | R | .008 | 0.08 |  |  |  |  |  |  |  |  | SF
3 | 224 |  | TAPE,DUCT .75IN | R | .1 | 1 |  |  |  |  |  |  |  |  | FT
2 | MS35206-214 |  | SCREW | P | 72 | 720 |  |  |  |  |  |  |  |  | EA
2 | 001-1155-2-B |  | DECAL | D | 1 | 10 |  |  |  |  |  |  |  |  | EA
3 | 3R994 | XEROX | DRAFTING FILM | R | 0.03 | 0.03 |  |  |  |  |  |  |  |  | EA
3 | B-61H-250 |  | TYVEX | R | .01 | 0.1 |  |  |  |  |  |  |  |  | RL
2 | 001-1116-D |  | SCHEMATIC | T | 1 | 10 |  |  |  |  |  |  |  |  | EA
2 | 001-1175-C |  | WIRE LIST | T | 1 | 10 |  |  |  |  |  |  |  |  | EA
2 | 001-5055-H |  | PROCEDURE,TEST | T | 1 | 10 |  |  |  |  |  |  |  |  | EA
2 | STD-0155 |  | PROCEDURE,ESD | T | 1 | 10 |  |  |  |  |  |  |  |  | EA
