dmarlowe69/Hayes-Targets/TLX DOCS/Target/0013055.xls

I | C |  | FED MFG |  |  | UN | QTY | QTY | NEXT HIGHER
N | L | PART NUMBER | CODE | DESCRIPTION | PIECE SIZE | IS | NHA | EI | ASSEMBLY | REMARKS
0 | A | 001-3055-9-A |  | TLX-1IR |  | EA | 1 | 1
1 | A | 001-1117-9-G |  | COMPUTER ASSY |  | EA | 1 | 1 | 001-3055-9
2 | A | 001-1114-9-M |  | COMPUTER SUBASSY |  | EA | 1 | 1 | 001-1117-9
3 | A | 001-1103-9-F |  | FRAME ASSY |  | EA | 1 | 1 | 001-1114-9
4 | S | 001-1167-1-B |  | BAR |  | EA | 2 | 2 | 001-1103-9
4 | S | 001-1167-3-B |  | BAR |  | EA | 8 | 8 | 001-1103-9
4 | S | 001-1167-5-B |  | BAR |  | EA | 2 | 2 | 001-1103-9
4 | S | 001-1167-7-B |  | BAR |  | EA | 1 | 1 | 001-1103-9
4 | S | 001-1167-11-B |  | BAR |  | EA | 2 | 2 | 001-1103-9
4 | S | 001-1167-13-B |  | BAR |  | EA | 1 | 1 | 001-1103-9
4 | A | 001-1180-9-B |  | COVER ASSY |  | EA | 1 | 1 | 001-1103-9
5 | D | 001-1104-3-J |  | COVER |  | EA | 1 | 1 | 001-1180-9
6 | R | 6061-T6 .050 250/11 |  | SHEET | .854X1.167 | SF | .997 | .997 | 001-1104-3
5 | D | 001-1112-1-B |  | SPACER |  | EA | 4 | 4 | 001-1180-9
6 | R | 6061-T6 .050 250/11 |  | SHEET | .042X.583 | SF | .024 | .096 | 001-1112-1
5 | D | 001-1112-3-B |  | SPACER |  | EA | 2 | 2 | 001-1180-9
6 | R | 6061-T6 .050 250/11 |  | SHEET | .042X.271 | SF | .011 | .022 | 001-1112-3
5 | D | 001-1113-C |  | SLIDE |  | EA | 2 | 2 | 001-1180-9
6 | P | PRD-6875 | 07556 | CARD GUIDE |  | EA | .5 | 1 | 001-1113
5 | P | MS20470A4-5 |  | RIVET |  | EA | 12 | 12 | 001-1180-9
5 | P | PRD-6875 | 07556 | CARD GUIDE |  | EA | 4 | 4 | 001-1180-9
4 | P | MS35206-214 |  | SCREW |  | EA | 26 | 26 | 001-1103-9
4 | P | MS20470AD3-7 |  | RIVET |  | EA | 26 | 26 | 001-1103-9
4 | R | RTV-102 | 01139 | ADHESIVE |  | TU | .01 | .01 | 001-1103-9
3 | A | 001-1119-9-K |  | PC BOARD ASSY |  | EA | 1 | 1 | 001-1114-9
4 | S | 001-1120-E |  | PC BOARD |  | EA | 1 | 1 | 001-1119-9
4 | P | PKA2314P | 72347 | POWER SUPPLY |  | EA | 1 | 1 | 001-1119-9
4 | P | CSR13F476KM |  | CAPACITOR,47UF,35VDC |  | EA | 1 | 1 | 001-1119-9
4 | P | 109D827X9015T2 | 56289 | CAPACITOR,820UF,15DC |  | EA | 1 | 1 | 001-1119-9
4 | T | 001-5092 |  | PROCEDURE,TEST |  | EA | 1 | 1 | 001-1119-9
3 | A | 001-1174-9-D |  | CABLE ASSY, A/D BD. |  | EA | 1 | 1 | 001-1114-9
4 | R | 843-191-2801-020 | 02660 | CABLE,RIBBON |  | FT | .5 | .5 | 001-1174-9
4 | P | 842-812-2003-134 | 02660 | SOCKET |  | EA | 2 | 2 | 001-1174-9
4 | P | 842-812-1003-134 | 02660 | SOCKET |  | EA | 1 | 1 | 001-1174-9
4 | T | 001-1116-D |  | SCHEMATIC |  | EA | 1 | 1 | 001-1174-9
3 | S | 001-1188-9-H |  | INTERFACE BOARD ASSY |  | EA | 1 | 1 | 001-1114-9
4 | T | 001-1233-D |  | PC BOARD |  | EA | 1 | 1 | 001-1188-9
4 | T | 001-1234-A |  | SCHEMATIC |  | EA | 1 | 1 | 001-1188-9
4 | T | STD-0155 |  | PROCEDURE,ESD |  | EA | 1 | 1 | 001-1188-9
4 | T | 001-5095 |  | TEST PROCEDURE |  | EA | 1 | 1 | 001-1188-9
3 | A | 001-1218-9-H |  | 1805 CPU ASSY |  | EA | 1 | 1 | 001-1114-9
4 | A | 001-1224-9-K |  | EPROM ASSY |  | EA | 1 | 1 | 001-1218-9
5 | P | MD2716M |  | EPROM |  | EA | 1 | 1 | 001-1224-9
5 | D | 001-1224-1-K |  | DECAL |  | EA | 1 | 1 | 001-1224-9
6 | R | B-61H-250 | 96707 | TYVEX |  | RL | .01 | .01 | 001-1224-1
5 | T | STD-0155 |  | PROCEDURE,ESD |  | EA | 1 | 1 | 001-1224-9
5 | T | 001-5097-A |  | PROCEDURE,TEST |  | EA | 1 | 1 | 001-1224-9
5 | T | 001-1331-A |  | OBJECT CODE,EPROM |  | EA | 1 | 1 | 001-1224-9
4 | P | MB606 | MATRIC | 1805 CPU BOARD |  | EA | 1 | 1 | 001-1218-9
4 | R | RTV-162 | 01139 | ADHESIVE |  | TU | .01 | .01 | 001-1218-9
4 | X | 001-1224-19-K |  | EPROM ASSY |  | EA | 1 | 1 | 001-1218-9
5 | X | MD2716M |  | EPROM |  | EA | 1 | 1 | 001-1224-9
5 | X | 001-1224-3-K |  | DECAL |  | EA | 1 | 1 | 001-1224-9
6 | X | B-61H-250 | 96707 | TYVEX |  | RL | .01 | .01 | 001-1224-1
5 | T | STD-0155 |  | PROCEDURE,ESD |  | EA | 1 | 1 | 001-1224-9
5 | T | 001-5097-A |  | PROCEDURE,TEST |  | EA | 1 | 1 | 001-1224-9
5 | T | 001-1440 |  | OBJECT CODE,EPROM |  | EA | 1 | 1 | 001-1224-9
4 | T | 001-5098 |  | PROCEDURE,TEST |  | EA | 1 | 1 | 001-1218-9
3 | D | 001-1219-D |  | TM ENCODER |  | EA | 1 | 1 | 001-1114-9
4 | S | 001-5043-C |  | ENCODER BOARD ASSY |  | EA | 1 | 1 | 001-1219
4 | T | STD-0155 |  | PROCEDURE,ESD |  | EA | 1 | 1 | 001-1219
4 | T | 001-5094 |  | PROCEDURE,TEST |  | EA | 1 | 1 | 001-1219
3 | R | M16878/1BEE9 |  | WIRE,24,WHITE |  | FT | 140 | 140 | 001-1114-9
3 | P | MS35206-217 |  | SCREW |  | EA | 12 | 12 | 001-1114-9
3 | D | 001-1424-A |  | A/D-D/A BOARD MOD |  | EA | 1 | 1 | 001-1114-9
4 | P | MB654A | MATRIC | A/D-D/A CONVERTER |  | EA | 1 | 1 | 001-1424
4 | R | RTV-162 | 01139 | ADHESIVE |  | TU | .01 | .01 | 001-1424
4 | T | 001-5096 |  | PROCEDURE,TEST |  | EA | 1 | 1 | 001-1424
3 | S | 001-1173 |  | BACKPLANE,COMPUTER |  | EA | 1 | 1 | 001-1114-9
3 | S | 001-5042-D |  | DECODER BOARD ASSY |  | EA | 1 | 1 | 001-1114-9
4 | T | 001-5093 |  | TEST PROCEDURE |  | EA | 1 | 1 | 001-5042
3 | P | 143-022-01-(110) | 13511 | CONNECTOR |  | EA | 3 | 3 | 001-1114-9
3 | P | 50-44SN-9 | 71785 | CONNECTOR |  | EA | 1 | 1 | 001-1114-9
3 | P | 583616-4 | 00779 | PIN |  | EA | 19 | 19 | 001-1114-9
3 | P | 583717-5 | 00779 | CONNECTOR |  | EA | 1 | 1 | 001-1114-9
3 | R | 22231 | 05972 | THREAD LOCK |  | BT | .01 | .01 | 001-1114-9
3 | T | 001-1116-D |  | SCHEMATIC |  | EA | 1 | 1 | 001-1114-9
3 | T | 001-1175-C |  | WIRE LIST |  | EA | 1 | 1 | 001-1114-9
3 | T | STD-0155 |  | PROCEDURE,ESD |  | EA | 1 | 1 | 001-1114-9
3 | T | 001-5055-H |  | PROCEDURE,TEST |  | EA | 1 | 1 | 001-1114-9
2 | A | 001-1115-9-G |  | TRAY ASSY |  | EA | 1 | 1 | 001-1117-9
3 | D | 001-1115-1-G |  | TRAY |  | EA | 1 | 1 | 001-1115-9
4 | R | 6061-T6 .050 250/11 |  | SHEET | .583X.833 | SF | .486 | .486 | 001-1115-1
3 | P | 9655-08 | 19738 | NUTSERT |  | EA | 6 | 6 | 001-1115-9
2 | A | 001-1169-9-J |  | COVER/EXTENSION ASSY |  | EA | 1 | 1 | 001-1117-9
3 | D | 001-1176-1-B |  | COVER,TOP |  | EA | 1 | 1 | 001-1169-9
4 | R | 6061-T6 .050 250/11 |  | SHEET | .104X.417 | SF | .043 | .043 | 001-1176-1
3 | D | 001-1176-3-B |  | COVER,SIDE |  | EA | 1 | 1 | 001-1169-9
4 | R | 6061-T6 .050 250/11 |  | SHEET | .104X.333 | SF | .035 | .035 | 001-1176-3
3 | S | 001-1177-1-A |  | BAR |  | EA | 2 | 2 | 001-1169-9
3 | S | 001-1177-11-A |  | BAR |  | EA | 1 | 1 | 001-1169-9
3 | S | 001-1177-13-A |  | BAR |  | EA | 1 | 1 | 001-1169-9
3 | S | 001-1177-14-A |  | BAR |  | EA | 1 | 1 | 001-1169-9
3 | S | 001-1177-3-A |  | BAR |  | EA | 1 | 1 | 001-1169-9
3 | S | 001-1177-5-A |  | BAR |  | EA | 1 | 1 | 001-1169-9
3 | S | 001-1177-7-A |  | BAR |  | EA | 1 | 1 | 001-1169-9
3 | A | 001-1178-9-D |  | COVER ASSY |  | EA | 1 | 1 | 001-1169-9
4 | A | 001-1168-9-B |  | BUMPER ASSY |  | EA | 2 | 2 | 001-1178-9
5 | D | 001-1168-1-B |  | BUMPER |  | EA | 1 | 2 | 001-1168-9
6 | R | 6061-T6 .032 250/11 |  | SHEET | .042X.177 | SF | .008 | .016 | 001-1168-1
5 | D | 001-1168-3-B |  | INSULATION |  | EA | 1 | 2 | 001-1168-9
6 | R | NES-41B-.25A | 72781 | SHEET,SPONGE RUBBER | .042X.063 | SF | .003 | .006 | 001-1168-3
4 | D | 001-1104-11-J |  | COVER |  | EA | 1 | 1 | 001-1178-9
5 | R | 6061-T6 .050 250/11 |  | SHEET | .417X.5 | SF | .209 | .209 | 001-1104-11
4 | P | MS20470AD3-4 |  | RIVET |  | EA | 4 | 4 | 001-1178-9
4 | P | 1201-052 | 51406 | FILTER & HARDWARE |  | EA | 21 | 21 | 001-1178-9
4 | P | 856 | 91833 | TERMINAL STRIP |  | EA | 1 | 1 | 001-1178-9
4 | P | MS20470AD3-3 |  | RIVET |  | EA | 2 | 2 | 001-1178-9
3 | A | 001-1181-9-C |  | COVER ASSY |  | EA | 1 | 1 | 001-1169-9
4 | D | 001-1104-1-J |  | COVER |  | EA | 1 | 1 | 001-1181-9
5 | R | 6061-T6 .050 250/11 |  | SHEET | .417X.5 | SF | .209 | .209 | 001-1104-1
4 | P | MS21083N04 |  | NUT |  | EA | 32 | 32 | 001-1181-9
4 | P | MS3112E10-6S |  | CONNECTOR |  | EA | 1 | 1 | 001-1181-9
4 | P | MS3112E10-6SW |  | CONNECTOR |  | EA | 1 | 1 | 001-1181-9
4 | P | MS3112E10-98S |  | CONNECTOR |  | EA | 1 | 1 | 001-1181-9
4 | P | MS3112E14-19S |  | CONNECTOR |  | EA | 1 | 1 | 001-1181-9
4 | P | MS3112E8-33S |  | CONNECTOR |  | EA | 1 | 1 | 001-1181-9
4 | P | MS3112E8-4S |  | CONNECTOR |  | EA | 1 | 1 | 001-1181-9
4 | P | MS3112E8-4SW |  | CONNECTOR |  | EA | 1 | 1 | 001-1181-9
4 | P | MS35206-214 |  | SCREW |  | EA | 32 | 32 | 001-1181-9
4 | P | PT02E-8-2P | 77820 | CONNECTOR |  | EA | 1 | 1 | 001-1181-9
4 | P | 10-101949-10 | 77820 | GASKET |  | EA | 3 | 3 | 001-1181-9
4 | P | 10-101949-14 | 77820 | GASKET |  | EA | 1 | 1 | 001-1181-9
4 | P | 10-101949-8 | 77820 | GASKET |  | EA | 4 | 4 | 001-1181-9
4 | P | 10-101960-145 | 77820 | CAP,PROTECTION |  | EA | 1 | 1 | 001-1181-9
4 | P | 10-101960-105 | 77820 | CAP,PROTECTION |  | EA | 1 | 1 | 001-1181-9
4 | P | 7326 | 91833 | LUG,SOLDER |  | EA | 1 | 1 | 001-1181-9
3 | P | MS20470AD3-7 |  | RIVET |  | EA | 28 | 28 | 001-1169-9
3 | P | MS35206-214 |  | SCREW |  | EA | 38 | 38 | 001-1169-9
3 | R | M16878/1BEE9 |  | WIRE,24,WHITE |  | FT | 45 | 45 | 001-1169-9
3 | P | RCR07G562J |  | RESISTOR |  | EA | 1 | 1 | 001-1169-9
3 | R | FIT-221-3/32Y | 92194 | SHRINK TUBING |  | FT | .17 | .17 | 001-1169-9
3 | R | RTV-102 | 01139 | ADHESIVE |  | TU | .01 | .01 | 001-1169-9
3 | T | 001-1175-C |  | WIRE LIST |  | EA | 1 | 1 | 001-1169-9
3 | T | 001-1116-D |  | SCHEMATIC |  | EA | 1 | 1 | 001-1169-9
2 | A | 001-1179-9-C |  | COVER ASSY |  | EA | 1 | 1 | 001-1117-9
3 | D | 001-1104-7-J |  | COVER |  | EA | 1 | 1 | 001-1179-9
4 | R | 6061-T6 .050 250/11 |  | SHEET | .323X.427 | SF | .146 | .146 | 001-1104-7
3 | P | MS20470AD3-4 |  | RIVET |  | EA | 2 | 2 | 001-1179-9
3 | D | 001-1179-1-C |  | SHEET,RUBBER |  | EA | 2 | 2 | 001-1179-9
4 | R | NES-41B-.75A |  | SHEET,SPONGE RUBBER | .053X.250 | SF | .013 | .026 | 001-1179-1
3 | D | 001-1179-3-C |  | ANGLE |  | EA | 1 | 1 | 001-1179-9
4 | R | 6061-T6 .032 250/11 |  | SHEET | .063X.125 | SF | .008 | .008 | 001-1179-3
3 | R | 224 |  | TAPE,DUCT .75IN |  | FT | .1 | .1 | 001-1179-3
2 | P | MS35206-214 |  | SCREW |  | EA | 72 | 72 | 001-1117-9
2 | D | 001-1155-2-D |  | DECAL |  | EA | 1 | 1 | 001-1117-9
3 | R | 3R994 | XEROX | DRAFTING FILM |  | SF | .03 | .03 | 001-1155-2
2 | T | 001-1116-D |  | SCHEMATIC |  | EA | 1 | 1 | 001-1117-9
2 | T | 001-1175-C |  | WIRE LIST |  | EA | 1 | 1 | 001-1117-9
2 | T | 001-5055-H |  | PROCEDURE,TEST |  | EA | 1 | 1 | 001-1117-9
2 | T | STD-0155 |  | PROCEDURE,ESD |  | EA | 1 | 1 | 001-1117-9
1 | A | 001-1152-9-F |  | WING |  | EA | 2 | 2 | 001-3055-9
2 | S | 001-1152-9S1-F |  | WING, ANODIZE |  | EA | 1 | 2 | 001-1152-9
2 | S | 001-1152-9S2-F |  | WING, PAINT |  | EA | 1 | 2 | 001-1152-9
3 | T | STD-5021-G |  | PAINT PROCEDURE |  | EA | 1 | 2 | 001-1152-9
2 | D | 001-1456-A |  | ADAPTER |  | EA | 1 | 2 | 001-1152-9
3 | R | 6061-T6511 .75 DIA |  | ROD QQ-A-200/8 | .2 | FT | .2 | .4 | 001-1456
2 | W | 001-1457-A |  | EXTRUSION,WING | .7 | FT | .7 | 1.4 | 001-1152-9
1 | A | 001-3020-9-A |  | NOSE CONE ASSY |  | EA | 1 | 1 | 001-3055-9
2 | A | 001-1171-9-E |  | NOSE CONE ASSY |  | EA | 1 | 1 | 001-3020-9
3 | D | 041-0389-1-N |  | NOSE CONE |  | EA | 1 | 1 | 001-1171-9
4 | S | 041-0389-1LH-N |  | NOSE CONE,LESS HOLES |  | EA | 1 | 1 | 041-0389-1
3 | A | 041-0477-9-G |  | REFLECTOR&BULKHEAD |  | EA | 1 | 1 | 001-1171-9
4 | P | MS35206-244 |  | SCREW |  | EA | 3 | 3 | 041-0477-9
4 | D | 041-0263-1-R |  | BULKHEAD |  | EA | 1 | 1 | 041-0477-9
5 | M | 056-00021-1-R |  | BULKHEAD |  | EA | 1 | 1 | 041-0263-1
6 | X | 056-00021-1S-R |  | BULKHEAD,FORM |  | EA | 1 | 1 | 056-00021-1
6 | Q | 2024-0 .063 250/4 |  | SHEET | 1.108X1.12 | SF | 1.24 | 1.24 | 056-00021-1
4 | M | 041-0444-9-B |  | REFLECTOR ASSY |  | EA | 1 | 1 | 041-0477-9
5 | X | MS20470AD3-4 |  | RIVET |  | EA | 15 | 15 | 041-0444-9
5 | X | 05-0860-3032-01 | 12881 | WIRE MESH |  | FT | 3 | 3 | 041-0444-9
5 | X | 22NA7-68-82 | 72962 | NUTPLATE |  | EA | 3 | 3 | 041-0444-9
5 | X | 041-0443-E |  | FRAME |  | EA | 3 | 3 | 041-0444-9
6 | X | 041-0443S-E |  | SERVICE,NICKLE COAT |  | EA | 1 | 3 | 041-0443
6 | X | STD-0142 |  | FINISH, ELECTRO TIN |  | EA | 1 | 3 | 041-0443
6 | X | 6061-T6 .063 250/11 |  | SHEET | .583X.750 | SF | .437 | 1.3119 | 041-0443
3 | A | 001-1165-9-A |  | BRACKET ASSY |  | EA | 3 | 3 | 001-1171-9
4 | M | 001-1159-D |  | BRACKET |  | EA | 1 | 3 | 001-1165-9
5 | X | 001-1159S-D |  | BRACKET,CAD PLATE |  | EA | 1 | 3 | 001-1159
5 | Q | 1020 .047 ASTM A366 |  | SHEET | .167X.229 | SF | .038 | .114 | 001-1159
4 | P | 9655-08 | 19738 | NUTSERT |  | EA | 2 | 6 | 001-1165-9
3 | P | Q4559 | 08806 | LAMP |  | EA | 1 | 1 | 001-1171-9
3 | P | 9655-08 | 19738 | NUTSERT |  | EA | 6 | 6 | 001-1171-9
3 | P | MS24693-S50 |  | SCREW |  | EA | 6 | 6 | 001-1171-9
3 | P | A3135-017-935 | 78553 | WASHER |  | EA | 6 | 6 | 001-1171-9
3 | P | KT80 | 75382 | TERMINAL |  | EA | 2 | 2 | 001-1171-9
3 | R | PPP-T-60TYPE4CL1 1W |  | TAPE |  | RL | .01 | .01 | 001-1171-9
3 | R | RTV-102 | 01139 | ADHESIVE |  | TU | .01 | .01 | 001-1171-9
2 | A | 001-3067-9-B |  | BULKHEAD ASSY |  | EA | 1 | 1 | 001-3020-9
3 | P | CGS622U040R4C | 90201 | CAPACITOR |  | EA | 1 | 1 | 001-3067-9
3 | P | 6176-2A | 91506 | CLIP |  | EA | 1 | 1 | 001-3067-9
3 | D | 001-1172-J |  | BULKHEAD |  | EA | 1 | 1 | 001-3067-9
4 | M | 056-00021-1-R |  | BULKHEAD |  | EA | 1 | 1 | 001-1172
5 | X | 056-00021-1S-R |  | BULKHEAD,FORM |  | EA | 1 | 1 | 056-00021-1
5 | Q | 2024-0 .063 250/4 |  | SHEET | 1.108X1.12 | SF | 1.24 | 1.24 | 056-00021-1
3 | P | MS35206-216 |  | SCREW |  | EA | 4 | 4 | 001-3067-9
3 | P | MS21083N04 |  | NUT |  | EA | 4 | 4 | 001-3067-9
3 | P | AN960D6 |  | WASHER |  | EA | 2 | 2 | 001-3067-9
3 | P | 70-903 | STANCOR | CONTACTOR,DC,24V |  | EA | 3 | 3 | 001-3067-9
3 | P | NO.9 | 44655 | BRACKET,MOUNTING |  | EA | 2 | 2 | 001-3067-9
3 | R | RTV-102 | 01139 | ADHESIVE |  | TU | .05 | .05 | 001-3067-9
3 | P | 2N3054 |  | TRANSISTOR |  | EA | 1 | 1 | 001-3067-9
3 | P | 4726 | 91833 | KIT,MOUNTING |  | EA | 1 | 1 | 001-3067-9
3 | P | MS21083N3 |  | NUT |  | EA | 4 | 4 | 001-3067-9
3 | P | AN960D10 |  | WASHER |  | EA | 4 | 4 | 001-3067-9
3 | P | AN525-10R8 |  | SCREW |  | EA | 4 | 4 | 001-3067-9
3 | P | CCR264CS-3-02 | 11815 | RIVET |  | EA | 24 | 24 | 001-3067-9
3 | P | MS3367-4-9 |  | STRAP |  | EA | 10 | 10 | 001-3067-9
3 | P | 1682-0412 | 19738 | RIVET |  | EA | 10 | 10 | 001-3067-9
3 | D | 001-3079 |  | DECAL |  | EA | 1 | 1 | 001-3067-9
4 | R | 3R994 | XEROX | DRAFTING FILM | .17X.17 | SF | .03 | .03 | 001-3079
3 | A | 001-3066-9-B |  | CABLE ASSY |  | EA | 1 | 1 | 001-3067-9
4 | R | M16878/4BGE0 |  | WIRE,20,BLACK |  | FT | 4.5 | 4.5 | 001-3066-9
4 | R | M16878/4BGE2 |  | WIRE,20,RED |  | FT | 1 | 1 | 001-3066-9
4 | R | M16878/4BGE9 |  | WIRE,20,WHITE |  | FT | 2 | 2 | 001-3066-9
4 | R | M16878/4BKE0 |  | WIRE,14,BLACK |  | FT | 2.13 | 2.13 | 001-3066-9
4 | R | M16878/4BKE2 |  | WIRE,14,RED |  | FT | .833 | .833 | 001-3066-9
4 | P | 879 | 83330 | TERMINAL STRIP |  | EA | 1 | 1 | 001-3066-9
4 | P | L50J1R0 | 44655 | RESISTOR,50W,1OHM |  | EA | 1 | 1 | 001-3066-9
4 | P | RCR42G681J |  | RESISTOR |  | EA | 1 | 1 | 001-3066-9
4 | P | 153-260FAK-B01 | 15801 | THERMISTOR |  | EA | 1 | 1 | 001-3066-9
4 | P | RCR20G121J |  | RESISTOR |  | EA | 1 | 1 | 001-3066-9
4 | A | 001-3068-9 |  | BRACKET ASSY |  | EA | 1 | 1 | 001-3066-9
5 | P | MR500F | 76055 | POTENTIOMETER |  | EA | 1 | 1 | 001-3068-9
5 | D | 041-0303-D |  | BRACKET,POT. |  | EA | 1 | 1 | 001-3068-9
6 | R | 6061-T6 .040 250/11 |  | SHEET | .146X.125 | SF | .018 | .018 | 041-0303
5 | P | 1682-0412 | 19738 | RIVET |  | EA | 2 | 2 | 001-3068-9
4 | P | MS3367-4-9 |  | STRAP |  | EA | 6 | 6 | 001-3066-9
4 | P | MS25036-103 |  | TERMINAL |  | EA | 1 | 1 | 001-3066-9
4 | P | MS25036-104 |  | TERMINAL |  | EA | 1 | 1 | 001-3066-9
4 | P | MS25036-109 |  | TERMINAL |  | EA | 2 | 2 | 001-3066-9
4 | P | 640905-1 | 00779 | TERMINAL |  | EA | 1 | 1 | 001-3066-9
4 | P | 66361-2 | 00779 | PIN |  | EA | 1 | 1 | 001-3066-9
4 | R | FIT-221-3/8Y | 92194 | SHRINK TUBING |  | FT | .25 | .25 | 001-3066-9
3 | A | 001-3066-19-B |  | CABLE ASSY |  | EA | 1 | 1 | 001-3067-9
4 | R | M16878/4BGE2 |  | WIRE,20,RED |  | FT | 1.17 | 1.17 | 001-3066-19
4 | P | CF-2 |  | FILTER,OPEK |  | EA | 1 | 1 | 001-3066-19
4 | P | MS3367-4-9 |  | STRAP |  | EA | 2 | 2 | 001-3066-19
4 | P | MS25036-104 |  | TERMINAL |  | EA | 2 | 2 | 001-3066-19
4 | R | FIT-221-1/8Y | 92194 | SHRINK TUBING |  | FT | .125 | .125 | 001-3066-19
4 | P | MS3367-5-9 |  | STRAP |  | EA | 1 | 1 | 001-3066-19
3 | A | 001-3066-29-B |  | CABLE ASSY |  | EA | 1 | 1 | 001-3067-9
4 | R | M16878/4BGE0 |  | WIRE,20,BLACK |  | FT | .563 | .563 | 001-3066-29
4 | R | M16878/4BGE2 |  | WIRE,20,RED |  | FT | 1.62 | 1.62 | 001-3066-29
4 | R | M16878/4BGE9 |  | WIRE,20,WHITE |  | FT | 1.06 | 1.06 | 001-3066-29
4 | R | M16878/4BKE2 |  | WIRE,14,RED |  | FT | 1.06 | 1.06 | 001-3066-29
4 | P | MS3367-4-9 |  | STRAP |  | EA | 6 | 6 | 001-3066-29
4 | P | 206705-1 | 00779 | RECEPTACLE |  | EA | 1 | 1 | 001-3066-29
4 | P | MS25036-103 |  | TERMINAL |  | EA | 3 | 3 | 001-3066-29
4 | P | MS25036-104 |  | TERMINAL |  | EA | 1 | 1 | 001-3066-29
4 | P | MS25036-109 |  | TERMINAL |  | EA | 1 | 1 | 001-3066-29
4 | P | 66103-2 | 00779 | PIN |  | EA | 4 | 4 | 001-3066-29
4 | P | 66361-2 | 00779 | PIN |  | EA | 2 | 2 | 001-3066-29
3 | A | 001-3066-39-B |  | CABLE ASSY |  | EA | 1 | 1 | 001-3067-9
4 | R | M16878/4BGE2 |  | WIRE,20,RED |  | FT | 2 | 2 | 001-3066-39
4 | R | M16878/4BGE9 |  | WIRE,20,WHITE |  | FT | .67 | .67 | 001-3066-39
4 | R | M16878/4BGE1 |  | WIRE,20,BROWN |  | FT | 1.33 | 1.33 | 001-3066-39
4 | P | MS3367-4-9 |  | STRAP |  | EA | 6 | 6 | 001-3066-39
4 | P | 2K-1B-126 | 02289 | RELAY |  | EA | 1 | 1 | 001-3066-39
4 | P | MS25036-103 |  | TERMINAL |  | EA | 1 | 1 | 001-3066-39
4 | P | MS25036-104 |  | TERMINAL |  | EA | 1 | 1 | 001-3066-39
4 | P | 66103-2 | 00779 | PIN |  | EA | 1 | 1 | 001-3066-39
4 | R | FIT-221-1/8Y | 92194 | SHRINK TUBING |  | FT | .5 | .5 | 001-3066-39
4 | P | 1N4002 |  | DIODE |  | EA | 1 | 1 | 001-3066-39
3 | A | 001-3066-49-B |  | CABLE ASSY |  | EA | 1 | 1 | 001-3067-9
4 | R | M16878/4BGE2 |  | WIRE,20,RED |  | FT | 1.55 | 1.55 | 001-3066-49
4 | R | M16878/4BGE9 |  | WIRE,20,WHITE |  | FT | .604 | .604 | 001-3066-49
4 | R | M16878/4BKE2 |  | WIRE,14,RED |  | FT | 1.8 | 1.8 | 001-3066-49
4 | P | MS3367-4-9 |  | STRAP |  | EA | 6 | 6 | 001-3066-49
4 | P | 1507-102 | 83330 | TIP,JACK |  | EA | 1 | 1 | 001-3066-49
4 | P | MS25036-103 |  | TERMINAL |  | EA | 2 | 2 | 001-3066-49
4 | P | MS25036-104 |  | TERMINAL |  | EA | 2 | 2 | 001-3066-49
4 | P | MS25036-109 |  | TERMINAL |  | EA | 3 | 3 | 001-3066-49
4 | P | 640905-1 | 00779 | TERMINAL |  | EA | 1 | 1 | 001-3066-49
3 | A | 001-3066-59-B |  | CABLE ASSY |  | EA | 1 | 1 | 001-3067-9
4 | R | M16878/4BKE2 |  | WIRE,14,RED |  | FT | .67 | .67 | 001-3066-59
4 | P | MS25036-109 |  | TERMINAL |  | EA | 2 | 2 | 001-3066-59
3 | A | 001-3066-69-B |  | CABLE ASSY |  | EA | 3 | 3 | 001-3067-9
4 | P | 1N5408 |  | DIODE |  | EA | 1 | 3 | 001-3066-69
4 | P | MS25036-103 |  | TERMINAL |  | EA | 2 | 6 | 001-3066-69
4 | R | FIT-221-1/8Y | 92194 | SHRINK TUBING |  | FT | .25 | .75 | 001-3066-69
3 | D | 001-3069-A |  | INSULATOR |  | EA | 1 | 1 | 001-3067-9
4 | R | NO.560 .010 FIBEROID | 72653 | PAPER, FISH |  | RL | .005 | .005 | 001-3069
3 | P | NAS697A08 |  | NUTPLATE |  | EA | 12 | 12 | 001-3067-9
3 | T | 001-3064-A |  | WIRING DIAGRAM |  | EA | 1 | 1 | 001-3067-9
3 | T | 001-5111 |  | BULKHEAD TEST PROC. |  | EA | 1 | 1 | 001-3067-9
2 | A | 001-3021 |  | BODY,FWD |  | EA | 1 | 1 | 001-3020-9
2 | P | MS24693-S50 |  | SCREW |  | EA | 18 | 18 | 001-3020-9
2 | P | A3135-017-935 | 78553 | WASHER |  | EA | 21 | 21 | 001-3020-9
2 | A | 001-3022-9 |  | BULKHEAD ASSY |  | EA | 1 | 1 | 001-3020-9
3 | D | 041-0263-1-R |  | BULKHEAD |  | EA | 1 | 1 | 001-3022-9
4 | M | 056-00021-1-R |  | BULKHEAD |  | EA | 1 | 1 | 041-0263-1
5 | X | 056-00021-1S-R |  | BULKHEAD,FORM |  | EA | 1 | 1 | 056-00021-1
5 | Q | 2024-0 .063 250/4 |  | SHEET | 1.108X1.12 | SF | 1.24 | 1.24 | 056-00021-1
3 | D | 001-3024-A |  | BRACKET |  | EA | 1 | 1 | 001-3022-9
4 | R | 6061-T6 .063 250/11 |  | SHEET | .146X.188 | SF | .027 | .027 | 001-3024
3 | P | MS21076-08 |  | NUTPLATE |  | EA | 6 | 6 | 001-3022-9
3 | P | CCR264CS-3-02 | 11815 | RIVET |  | EA | 12 | 12 | 001-3022-9
3 | P | MS35206-214 |  | SCREW |  | EA | 4 | 4 | 001-3022-9
3 | P | MS21083N04 |  | NUT |  | EA | 4 | 4 | 001-3022-9
3 | P | MS20470AD4-5 |  | RIVET |  | EA | 3 | 3 | 001-3022-9
3 | A | 001-3023-9-B |  | CABLE ASSY |  | EA | 1 | 1 | 001-3022-9
4 | P | 206708-1 | 00779 | PLUG |  | EA | 1 | 1 | 001-3023-9
4 | P | 206705-1 | 00779 | RECEPTACLE |  | EA | 1 | 1 | 001-3023-9
4 | P | 1-480424-0 | 00779 | HOUSING,SOCKET |  | EA | 1 | 1 | 001-3023-9
4 | P | 66360-2 | 00779 | SOCKET |  | EA | 2 | 2 | 001-3023-9
4 | P | 66105-2 | 00779 | SOCKET |  | EA | 4 | 4 | 001-3023-9
4 | P | 60617-4 | 00779 | SOCKET |  | EA | 4 | 4 | 001-3023-9
4 | P | 66361-2 | 00779 | PIN |  | EA | 2 | 2 | 001-3023-9
4 | P | 66103-2 | 00779 | PIN |  | EA | 6 | 6 | 001-3023-9
4 | R | M16878/4BKE0 |  | WIRE,14,BLACK |  | FT | .5 | .5 | 001-3023-9
4 | R | M16878/4BKE2 |  | WIRE,14,RED |  | FT | .5 | .5 | 001-3023-9
4 | R | M16878/4BGE0 |  | WIRE,20,BLACK |  | FT | 2 | 2 | 001-3023-9
4 | R | M16878/4BGE2 |  | WIRE,20,RED |  | FT | 2 | 2 | 001-3023-9
4 | R | M16878/4BGE9 |  | WIRE,20,WHITE |  | FT | 2.67 | 2.67 | 001-3023-9
4 | R | FIT-221-1/8Y | 92194 | SHRINK TUBING |  | FT | .063 | .063 | 001-3023-9
4 | R | M16878/4BGE1 |  | WIRE,20,GREY |  | FT | .833 | .833 | 001-3023-9
4 | R | FIT-221-3/8Y | 92194 | SHRINK TUBING |  | FT | .063 | .063 | 001-3023-9
4 | P | 60618-4 | 00779 | PIN |  | EA | 1 | 1 | 001-3023-9
2 | D | 041-0239-11-U |  | BALLAST |  | EA | 1 | 1 | 001-3020-9
3 | R | 03262 |  | INHIBITOR (SP-350) |  | CN | .01 | .01 | 041-0239-11
3 | S | STD-0161-A |  | BALLAST,CAST IRON |  | EA | 1 | 1 | 041-0239-11
4 | R | 03262 |  | INHIBITOR (SP-350) |  | CN | .02 | .02 | STD-0161
2 | P | MS21083N08 |  | NUT |  | EA | 3 | 3 | 001-3020-9
2 | P | MS24693-S62 |  | SCREW |  | EA | 3 | 3 | 001-3020-9
1 | A | 001-1185-9-H |  | ACCELEROMETER ASSY |  | EA | 1 | 1 | 001-3055-9
2 | A | 001-1185-1-H |  | HOUSING ASSY |  | EA | 1 | 1 | 001-1185-9
3 | D | 001-1182-B |  | HOUSING |  | EA | 1 | 1 | 001-1185-1
4 | P | HU-6605-2.781-AL | 02875 | CASE |  | EA | 1 | 1 | 001-1182
3 | A | 001-1189-9-F |  | SUPPORT ASSY |  | EA | 1 | 1 | 001-1185-1
4 | D | 001-1189-1-F |  | BRACKET |  | EA | 1 | 1 | 001-1189-9
5 | R | 6061-T6 .040 250/11 |  | SHEET | .2X.4 | SF | .1 | .1 | 001-1189-1
4 | P | 9655-08 | 19738 | NUTSERT |  | EA | 4 | 4 | 001-1189-9
3 | P | MS20470AD3-5 |  | RIVET |  | EA | 4 | 4 | 001-1185-1
2 | A | 001-1187-9-D |  | PANEL ASSY |  | EA | 1 | 1 | 001-1185-9
3 | D | 001-1190-B |  | COVER |  | EA | 1 | 1 | 001-1187-9
4 | R | ABS .060 WHITE |  | SHEET | .125X.208 | SF | .026 | .026 | 001-1190
3 | S | 001-1183-C |  | PANEL |  | EA | 1 | 1 | 001-1187-9
3 | A | 001-1122-49-G |  | CABLE ASSY |  | EA | 1 | 1 | 001-1187-9
4 | R | M22759/13-20-9 |  | WIRE,WHITE |  | FT | 2.25 | 2.25 | 001-1122-49
4 | P | MS3116E8-33P |  | CONNECTOR |  | EA | 1 | 1 | 001-1122-49
4 | P | MS3367-4-9 |  | STRAP |  | EA | 2 | 2 | 001-1122-49
3 | P | 1201-052 | 51046 | FILTER & HARDWARE |  | EA | 3 | 3 | 001-1187-9
3 | P | 1/8-5B | 95987 | CLAMP |  | EA | 1 | 1 | 001-1187-9
3 | P | 3250L-1-103M | 32997 | POTENTIOMETER |  | EA | 1 | 1 | 001-1187-9
3 | P | MS35206-226 |  | SCREW |  | EA | 2 | 2 | 001-1187-9
2 | P | MS35206-202 |  | SCREW |  | EA | 4 | 4 | 001-1185-9
2 | P | MS35206-213 |  | SCREW |  | EA | 4 | 4 | 001-1185-9
2 | R | M16878/1BEE9 |  | WIRE,24,WHITE |  | FT | 1 | 1 | 001-1185-9
2 | P | LA67-0132-1 | 98284 | ACCELEROMETER |  | EA | 1 | 1 | 001-1185-9
2 | D | 001-1155-1-D |  | DECAL |  | EA | 1 | 1 | 001-1185-9
3 | R | 3R994 | XEROX | DRAFTING FILM |  | SF | .03 | .03 | 001-1155-1
2 | P | MS35333-35 |  | WASHER |  | EA | 4 | 4 | 001-1185-9
2 | T | 001-5056-B |  | PROCEDURE,TEST |  | EA | 1 | 1 | 001-1185-9
2 | T | STD-0159 |  | PROCEDURE,HANDLING |  | EA | 1 | 1 | 001-1185-9
1 | A | 001-1217-9-D |  | TAIL CONE ASSY |  | EA | 1 | 1 | 001-3055-9
2 | A | 001-1216-9-F |  | BULKHEAD ASSY |  | EA | 1 | 1 | 001-1217-9
3 | D | 001-1216-1-F |  | BULKHEAD |  | EA | 1 | 1 | 001-1216-9
4 | M | 056-00021-1-R |  | BULKHEAD |  | EA | 1 | 1 | 001-1216-1
5 | X | 056-00021-1S-R |  | BULKHEAD,FORM |  | EA | 1 | 1 | 056-00021-1
5 | Q | 2024-0 .063 250/4 |  | SHEET | 1.108X1.12 | SF | 1.24 | 1.24 | 056-00021-1
3 | P | 9655-08 | 19738 | NUTSERT |  | EA | 9 | 9 | 001-1216-9
3 | P | MS21076-L3 | 19738 | NUTPLATE |  | EA | 12 | 12 | 001-1216-9
3 | P | CCR264CS-3-2 | 11815 | RIVET |  | EA | 24 | 24 | 001-1216-9
3 | R | MS21266-2N |  | GROMMET |  | FT | 2 | 2 | 001-1216-9
2 | A | 041-0273-K |  | TAIL CONE |  | EA | 1 | 1 | 001-1217-9
3 | D | 041-0272-D |  | BEARING |  | EA | 1 | 1 | 041-0273
4 | P | 4X727 | 16327 | BEARING |  | EA | 1 | 1 | 041-0272
3 | D | 041-0264-F |  | TAIL CONE |  | EA | 1 | 1 | 041-0273
4 | S | 056-01818-J |  | NOSE CONE |  | EA | 1 | 1 | 041-0264
3 | M | 041-0262-H |  | BULKHEAD |  | EA | 1 | 1 | 041-0273
4 | Q | 2024-0 .063 250/4 |  | SHEET | .833X.833 | SF | .694 | .694 | 041-0262
3 | P | 1604-0615 | 19738 | RIVET |  | EA | 4 | 4 | 041-0273
3 | P | SSD43SSBSLF | 04375 | RIVET |  | EA | 6 | 6 | 041-0273
2 | P | MS24693-S50 |  | SCREW |  | EA | 6 | 6 | 001-1217-9
2 | P | A3135-017-935 | 78553 | WASHER |  | EA | 6 | 6 | 001-1217-9
1 | D | STD-0107-1-L |  | WING |  | EA | 2 | 2 | 001-3055-9
2 | S | STD-0109-L |  | WING |  | EA | 1 | 5 | STD-0107-1
1 | A | 001-1220-1-C |  | ANTENNA, WING |  | EA | 1 | 1 | 001-3055-9
2 | D | 001-1220-3-C |  | WIRE,BARE |  | EA | 1 | 1 | 001-1220-1
3 | R | QQ-W-343 22AWG |  | WIRE,BARE |  | FT | .125 | .125 | 001-1220-3
2 | D | 001-1221-F |  | WING,MOD |  | EA | 1 | 1 | 001-1220-1
3 | D | STD-0107-1-L |  | WING |  | EA | 1 | 1 | 001-1221
4 | S | STD-0109-L |  | WING |  | EA | 1 | 1 | STD-0107-1
2 | D | 001-1223-C |  | GROUND PLANE |  | EA | 1 | 1 | 001-1220-1
3 | R | 6061-T6 .020 250/11 |  | SHEET | .417X.667 | SF | .278 | .278 | 001-1223
2 | P | MS35206-216 |  | SCREW |  | EA | 2 | 2 | 001-1220-1
2 | P | UG-290A/U |  | CONNECTOR |  | EA | 1 | 1 | 001-1220-1
2 | P | A1023 | 57771 | EYELET |  | EA | 2 | 2 | 001-1220-1
2 | R | X-1194 1/2WIDE | 28153 | TAPE,COPPER FOIL |  | RL | .013 | .013 | 001-1220-1
2 | R | 191 1.5WIDE | 28153 | TAPE,PLASTIC,CLEAR |  | RL | .155 | .155 | 001-1220-1
1 | D | 001-0351-B |  | DOOR |  | EA | 1 | 1 | 001-3055-9
2 | R | KYDEX .060 ORANGE |  | SHEET | .75X.75 | SF | .6 | .6 | 001-0351
1 | M | 041-0267-G |  | TURBINE |  | EA | 1 | 1 | 001-3055-9
2 | X | 041-0175-D |  | TURBINE |  | EA | 1 | 1 | 041-0267
2 | X | 041-0267-1-G |  | SHIPPING ARRANGEMENT |  | EA | 1 | 1 | 041-0267
3 | X | 041-0267-3-G |  | SPACER |  | EA | 1 | 1 | 041-0267-1
4 | Q | 1X1.25 |  | STYROFOAM |  | FT | 4 | 4 | 041-0267-3
3 | X | 041-1226-A |  | SUPPORT |  | EA | 2 | 2 | 041-0261-1
3 | Q | CLOTH 1.0W |  | TAPE |  | RL | .01 | .01 | 041-0267-1
1 | M | 041-0387-E |  | SPACER |  | EA | 1 | 1 | 001-3055-9
2 | Q | 2024-T3 .875ODX.188W |  | TUBE |  | FT | .032 | .032 | 041-0387
1 | A | 001-1369-9-C |  | ALTIMETER ASSY |  | EA | 1 | 1 | 001-3055-9
2 | D | 001-1365 |  | TRAY |  | EA | 1 | 1 | 001-1369-9
3 | R | 6061-T6 .050 250/11 |  | SHEET | .396X.688 | SF | .272 | .272 | 001-1365
2 | D | 001-1155-7-D |  | DECAL |  | EA | 1 | 1 | 001-1369-9
3 | R | 3R994 | XEROX | DRAFTING FILM |  | SF | .03 | .03 | 001-1155-7
2 | S | 001-5081-E |  | KIT, ALTIMETER |  | EA | 1 | 1 | 001-1369-9
3 | T | 001-5087-A |  | TEST PROCEDURE |  | EA | 1 | 1 | 001-5081
2 | P | MS35206-228 |  | SCREW |  | EA | 4 | 4 | 001-1369-9
2 | P | MS21083N06 |  | NUT |  | EA | 4 | 4 | 001-1369-9
2 | P | 9655-08 | 19738 | NUTSERT |  | EA | 4 | 4 | 001-1369-9
2 | P | AN960D6 |  | WASHER |  | EA | 4 | 4 | 001-1369-9
1 | A | 001-1367-9-F |  | TRANSMITTER ASSY |  | EA | 1 | 1 | 001-3055-9
2 | S | 001-5079-*-D |  | TRANSMITTER |  | EA | 1 | 1 | 001-1367-9
3 | T | 001-5085-A |  | TEST PROCEDURE |  | EA | 1 | 1 | 001-5079-1
2 | A | 001-1364-9-B |  | TRAY ASSY |  | EA | 1 | 1 | 001-1367-9
3 | D | 001-1364-1-B |  | TRAY |  | EA | 1 | 1 | 001-1364-9
4 | R | 6061-T6 .032 250/11 |  | SHEET | .375X.583 | SF | .219 | .219 | 001-1364-1
3 | P | 9655-08 | 19738 | NUTSERT |  | EA | 4 | 4 | 001-1364-9
2 | P | MS3114E8-4P |  | CONNECTOR |  | EA | 1 | 1 | 001-1367-9
2 | P | AN960D916 |  | WASHER |  | EA | 1 | 1 | 001-1367-9
2 | P | MS35206-242 |  | SCREW |  | EA | 4 | 4 | 001-1367-9
2 | P | MS21083N08 |  | NUT |  | EA | 4 | 4 | 001-1367-9
2 | P | 9S4J010 | 16428 | CONNECTOR |  | EA | 1 | 1 | 001-1367-9
2 | R | 8R28010 | 16428 | CABLE |  | FT | .25 | .25 | 001-1367-9
2 | R | RTV-162 | 01139 | ADHESIVE |  | TU | .01 | .01 | 001-1367-9
2 | P | MS25036-149 |  | TERMINAL |  | EA | 1 | 1 | 001-1367-9
2 | R | M16878/1BGE9 |  | WIRE,20,WHITE |  | FT | .25 | .25 | 001-1367-9
2 | D | 001-1417-B |  | DECAL |  | EA | 1 | 1 | 001-1367-9
3 | R | 3R994 | XEROX | DRAFTING FILM |  | SF | .03 | .03 | 001-1417
2 | T | 001-5085-A |  | TEST PROCEDURE |  | EA | 1 | 1 | 001-1367-9
1 | A | 001-1368-9-F |  | RECEIVER ASSY |  | EA | 1 | 1 | 001-3055-9
2 | S | 001-5080-*-F |  | RECEIVER |  | EA | 1 | 1 | 001-1368-9
3 | T | 001-5085-A |  | TEST PROCEDURE |  | EA | 1 | 1 | 001-5080
2 | A | 001-1364-9-B |  | TRAY ASSY |  | EA | 1 | 1 | 001-1368-9
3 | D | 001-1364-1-B |  | TRAY |  | EA | 1 | 1 | 001-1364-9
4 | R | 6061-T6 .032 250/11 |  | SHEET | .375X.583 | SF | .219 | .219 | 001-1364-1
3 | P | 9655-08 | 19738 | NUTSERT |  | EA | 4 | 4 | 001-1364-9
2 | P | MS3114E8-4SW |  | CONNECTOR |  | EA | 1 | 1 | 001-1368-9
2 | P | AN960D916 |  | WASHER |  | EA | 1 | 1 | 001-1368-9
2 | P | MS35206-242 |  | SCREW |  | EA | 4 | 4 | 001-1368-9
2 | P | MS21083N08 |  | NUT |  | EA | 4 | 4 | 001-1368-9
2 | P | 9S4J010 | 16428 | CONNECTOR |  | EA | 1 | 1 | 001-1368-9
2 | R | 8R28010 | 16428 | CABLE |  | FT | .25 | .25 | 001-1368-9
2 | R | RTV-162 | 01139 | ADHESIVE |  | TU | .01 | .01 | 001-1368-9
2 | P | MS25036-149 |  | TERMINAL |  | EA | 1 | 1 | 001-1368-9
2 | R | M16878/1BGE9 |  | WIRE,20,WHITE |  | FT | .25 | .25 | 001-1368-9
2 | D | 001-1418-B |  | DECAL |  | EA | 1 | 1 | 001-1368-9
3 | R | 3R994 | XEROX | DRAFTING FILM |  | SF | .03 | .03 | 001-1418
2 | T | 001-5085-A |  | TEST PROCEDURE |  | EA | 1 | 1 | 001-1368-9
1 | A | 001-3063-9-B |  | FUSELAGE ASSY |  | EA | 1 | 1 | 001-3055-9
2 | A | 001-0384-9-D |  | LAUNCH SWITCH ASSY |  | EA | 1 | 1 | 001-3063-9
3 | D | 001-0387-A |  | BRACKET |  | EA | 1 | 1 | 001-0384-9
4 | R | 6061-T6 .063 250/11 |  | SHEET | .125X.604 | SF | .076 | .076 | 001-0387
3 | D | 001-0127-D |  | BRACKET |  | EA | 1 | 1 | 001-0384-9
4 | R | 6061-T6 .063 250/11 |  | SHEET | .167X.417 | SF | .07 | .07 | 001-0127
3 | S | 001-0128-C |  | ROD |  | EA | 1 | 1 | 001-0384-9
3 | D | 001-0129-B |  | SPACER |  | EA | 2 | 2 | 001-0384-9
4 | P | P-577-M05-F02-832 | 04729 | SPACER |  | EA | 1 | 2 | 001-0129
3 | A | 001-0385-9-A |  | SWITCH ASSY |  | EA | 2 | 2 | 001-0384-9
4 | P | 111SM2-T | 91929 | SWITCH |  | EA | 1 | 2 | 001-0385-9
4 | R | M16878/1BGE0 |  | WIRE,20,BLACK |  | FT | .583 | 1.1672 | 001-0385-9
4 | R | M16878/1BGE2 |  | WIRE,20,RED |  | FT | .583 | 1.1672 | 001-0385-9
3 | A | 001-0238-9-A |  | ACTUATOR ASSY |  | EA | 1 | 1 | 001-0384-9
4 | D | 001-0241-1-A |  | ACTUATOR |  | EA | 1 | 1 | 001-0238-9
4 | D | 001-0126-1-H |  | ACTUATOR |  | EA | 1 | 1 | 001-0126-9
5 | R | 6061-T6 .187 250/11 |  | PLATE | .167X.33 | SF | .056 | .056 | 001-0126-1
4 | D | 001-0241-2-A |  | ACTUATOR |  | EA | 1 | 1 | 001-0238-9
4 | D | 001-0126-1-H |  | ACTUATOR |  | EA | 1 | 1 | 001-0126-9
5 | R | 6061-T6 .187 250/11 |  | PLATE | .167X.33 | SF | .056 | .056 | 001-0126-1
4 | S | 001-0128-C |  | ROD |  | EA | 1 | 1 | 001-0238-9
4 | P | MS16555-629 |  | PIN |  | EA | 1 | 1 | 001-0238-9
4 | P | MS20426AD4-9 |  | RIVET |  | EA | 1 | 1 | 001-0238-9
4 | R | 63531 | 05972 | COMPOUND,RETAINING |  | BT | .01 | .01 | 001-0238-9
4 | R | 74756 | 05972 | PRIMER |  | BT | .01 | .01 | 001-0238-9
3 | D | 001-0239 |  | SPACER |  | EA | 4 | 4 | 001-0384-9
4 | R | 6061-T6 .125 250/11 |  | SHEET | .021X.125 | SF | .003 | .012 | 001-0239
3 | P | MS20470A4-12 |  | RIVET |  | EA | 4 | 4 | 001-0384-9
3 | P | MS35206-209 |  | SCREW |  | EA | 2 | 2 | 001-0384-9
3 | P | MS35333-35 |  | WASHER |  | EA | 2 | 2 | 001-0384-9
3 | P | MS35649-222 |  | NUT |  | EA | 2 | 2 | 001-0384-9
3 | P | LE-037CD-10-MW | 84830 | SPRING |  | EA | 2 | 2 | 001-0384-9
3 | P | LWNY-002BK | 62619 | WASHER |  | EA | 4 | 4 | 001-0384-9
3 | R | 63531 | 05972 | COMPOUND,RETAINING |  | BT | .01 | .01 | 001-0384-9
3 | P | MS35206-215 |  | SCREW |  | EA | 8 | 8 | 001-0384-9
3 | P | MS21083N04 |  | NUT |  | EA | 8 | 8 | 001-0384-9
3 | P | PT00E8-2S | 77820 | CONNECTOR |  | EA | 2 | 2 | 001-0384-9
2 | A | 001-0350-1-B |  | GROUND PLANE ASSY |  | EA | 1 | 1 | 001-3063-9
3 | D | 001-0350-3-B |  | GROUND PLANE |  | EA | 1 | 1 | 001-0350-1
4 | R | 6061-T6 .020 250/11 |  | SHEET | .958X1.125 | SF | 1.08 | 1.08 | 001-0350-3
3 | P | NAS697A06 |  | NUTPLATE |  | EA | 2 | 2 | 001-0350-1
3 | P | MS20426AD2-3 |  | RIVET |  | EA | 4 | 4 | 001-0350-1
2 | A | 001-1068-9-F |  | DOUBLER ASSY |  | EA | 1 | 1 | 001-3063-9
3 | D | 001-1068-1-F |  | DOUBLER |  | EA | 1 | 1 | 001-1068-9
4 | R | 6061-T6 .050 250/11 |  | SHEET | .813X.813 | SF | .661 | .661 | 001-1068-1
3 | P | 9655-08 | 19738 | NUTSERT |  | EA | 30 | 30 | 001-1068-9
2 | A | 001-1225-9 |  | ANTENNA ASSY |  | EA | 1 | 1 | 001-3063-9
3 | D | 001-1228-C |  | BRACKET |  | EA | 1 | 1 | 001-1225-9
4 | R | 6061-T6 .050 250/11 |  | SHEET | .167X.250 | SF | .042 | .042 | 001-1228
3 | P | CI-106 | 51351 | ANTENNA |  | EA | 1 | 1 | 001-1225-9
2 | A | 001-1203-29-F |  | SHAFT ASSY |  | EA | 1 | 1 | 001-3063-9
3 | M | 001-1203-1-F |  | TUBE |  | EA | 1 | 1 | 001-1203-29
4 | X | 001-1203-1S-F |  | TUBE,CAD PLATE |  | EA | 1 | 1 | 001-1203-1
4 | Q | 4130N 1.00ODX.028W |  | TUBE |  | FT | 3.58 | 3.58 | 001-1203-1
3 | S | 041-1183-A |  | COUPLING |  | EA | 1 | 1 | 001-1203-29
3 | S | 041-1184-D |  | COUPLING |  | EA | 1 | 1 | 001-1203-29
3 | P | MS171522 |  | PIN |  | EA | 6 | 6 | 001-1203-29
3 | R | 63531 | 05972 | COMPOUND,RETAINING |  | BT | .01 | .01 | 001-1203-29
3 | A | 001-3060-9 |  | BULKHEAD ASSY |  | EA | 1 | 1 | 001-1203-29
4 | D | 001-3060-1 |  | BULKHEAD |  | EA | 1 | 1 | 001-3060-9
5 | M | 056-00021-1-R |  | BULKHEAD |  | EA | 1 | 1 | 001-3060-1
6 | X | 056-00021-1S-R |  | BULKHEAD,FORM |  | EA | 1 | 1 | 056-00021-1
6 | Q | 2024-0 .063 250/4 |  | SHEET | 1.108X1.12 | SF | 1.24 | 1.24 | 056-00021-1
4 | D | 041-0271-D |  | BEARING |  | EA | 1 | 1 | 001-3060-9
5 | P | 4X730 | 16327 | BEARING |  | EA | 1 | 1 | 041-0271
4 | P | 1604-0615 | 19738 | RIVET |  | EA | 4 | 4 | 001-3060-9
4 | P | NAS697A3 |  | NUTPLATE |  | EA | 12 | 12 | 001-3060-9
4 | P | CCR264CS-3-2 | 11815 | RIVET |  | EA | 30 | 30 | 001-3060-9
4 | P | NAS697A08 |  | NUTPLATE |  | EA | 3 | 3 | 001-3060-9
4 | P | 9655-08 | 19738 | NUTSERT |  | EA | 1 | 1 | 001-3060-9
4 | R | MS21266-2N |  | GROMMET |  | FT | 1.57 | 1.57 | 001-3060-9
2 | P | MS24693-S50 |  | SCREW |  | EA | 26 | 26 | 001-3063-9
2 | P | MS21083N5 |  | NUT |  | EA | 1 | 1 | 001-3063-9
2 | A | 001-1226-1-A |  | TOW FITTING |  | EA | 1 | 1 | 001-3063-9
3 | S | 001-1226-1S-A |  | FITTING,CAD PLATE |  | EA | 1 | 1 | 001-1226-1
3 | D | 001-1226-3-A |  | BASE |  | EA | 1 | 1 | 001-1226-1
4 | R | 4130 .125 |  | SHEET,MIL-S-18729 |  | SF | .083 | .083 | 001-1226-3
3 | D | 001-1226-5-A |  | SPACER |  | EA | 1 | 1 | 001-1226-1
4 | R | 4130 .625ODX.156W |  | TUBE MIL-T-6736 |  | FT | .011 | .011 | 001-1226-5
3 | P | AN45-7A |  | EYEBOLT |  | EA | 1 | 1 | 001-1226-1
2 | P | AN960-516 |  | WASHER |  | EA | 1 | 1 | 001-3063-9
2 | P | AN3-5A |  | BOLT |  | EA | 2 | 2 | 001-3063-9
2 | P | AN525-832R6 |  | SCREW |  | EA | 23 | 23 | 001-3063-9
2 | P | A3135-017-935 | 78553 | WASHER |  | EA | 20 | 20 | 001-3063-9
2 | P | AN960-10 |  | WASHER |  | EA | 2 | 2 | 001-3063-9
2 | P | MS21083N3 |  | NUT |  | EA | 2 | 2 | 001-3063-9
2 | P | MS35206-228 |  | SCREW |  | EA | 2 | 2 | 001-3063-9
2 | A | 001-3061-129-C |  | CABLE ASSY |  | EA | 1 | 1 | 001-3063-9
3 | R | M16878/4BKE0 |  | WIRE,14,BLACK |  | FT | 3.5 | 3.5 | 001-3061-129
3 | R | M16878/4BKE2 |  | WIRE,14,RED |  | FT | 3.5 | 3.5 | 001-3061-129
3 | P | MS3367-4-9 |  | STRAP |  | EA | 2 | 2 | 001-3061-129
3 | P | MS25036-154 |  | TERMINAL |  | EA | 1 | 1 | 001-3061-129
3 | P | MS25036-108 |  | TERMINAL |  | EA | 1 | 1 | 001-3061-129
3 | R | FIT-221-1/8Y | 92194 | SHRINK TUBING |  | FT | .125 | .125 | 001-3061-129
3 | P | 1-480318-0 | 00779 | HOUSING,SOCKET |  | EA | 1 | 1 | 001-3061-129
3 | P | 60619-4 | 00779 | SOCKET |  | EA | 2 | 2 | 001-3061-129
2 | A | 001-0353-9-H |  | FUEL TANK ASSY |  | EA | 1 | 1 | 001-3063-9
3 | D | 001-0347-1-D |  | FUEL TANK WELDMENT |  | EA | 1 | 1 | 001-0353-9
4 | D | 001-0347-3-D |  | CYLINDER |  | EA | 1 | 1 | 001-0347-1
5 | R | 6061-T6 .050 250/11 |  | SHEET | 1.4X1.6 | SF | 2.3 | 2.3 | 001-0347-3
4 | A | 001-0365-1-A |  | END PLATE WELDMENT |  | EA | 1 | 1 | 001-0347-1
5 | D | 001-0362-1 |  | END PLATE |  | EA | 1 | 1 | 001-0365-1
6 | R | 6061-T6 .050 250/11 |  | SHEET | .729X.729 | SF | .531 | .531 | 001-0362-1
5 | D | 001-0348-1-A |  | TUBE |  | EA | 1 | 1 | 001-0365-1
6 | R | 6061-T6 .125IPS SC40 |  | TUBE,MIL-P-25995 |  | FT | .333 | .333 | 001-0348-1
5 | D | 001-0348-3-A |  | TUBE |  | EA | 1 | 1 | 001-0365-1
6 | R | 6061-T6 .250IPS SC40 |  | TUBE,MIL-P-25995 |  | FT | .21 | .21 | 001-0348-3
5 | D | 001-0348-5-A |  | TUBE |  | EA | 1 | 1 | 001-0365-1
6 | R | 6061-T6 .125IPS SC40 |  | TUBE,MIL-P-25995 |  | FT | .21 | .21 | 001-0348-5
4 | D | 001-0362-3 |  | END PLATE |  | EA | 1 | 1 | 001-0347-1
5 | R | 6061-T6 .050 250/11 |  | SHEET | .729X.729 | SF | .531 | .531 | 001-0347-7
4 | D | 001-0347-11-D |  | BAFFLE |  | EA | 1 | 1 | 001-0347-1
5 | R | 6061-T6 .040 250/11 |  | SHEET | .7X.7 | SF | .49 | .49 | 001-0347-11
4 | D | 001-0347-13-D |  | TUBE |  | EA | 1 | 1 | 001-0347-1
5 | R | 6061-T6 1.625ODX.049 |  | TUBE,WW-T-700/6 |  | FT | 1.71 | 1.71 | 001-0347-13
4 | D | 001-0347-15-D |  | TUBE |  | EA | 1 | 1 | 001-0347-1
5 | R | 6061-T6 1.00ODX.049W |  | TUBE,WW-T-700/6 |  | FT | 1.13 | 1.13 | 001-0347-15
4 | P | 9655-08 | 19738 | NUTSERT |  | EA | 10 | 10 | 001-0347-1
3 | P | A-4CP5-1 | 18034 | VALVE,RELIEF |  | EA | 1 | 1 | 001-0353-9
3 | P | 1069X4 | 79470 | ELBOW |  | EA | 2 | 2 | 001-0353-9
3 | P | MS3367-1-9 |  | STRAP |  | EA | 1 | 1 | 001-0353-9
3 | P | A-4CP5-1 | 18034 | VALVE,RELIEF |  | EA | 1 | 1 | 001-0353-9
3 | P | A-400-8-4 | 02570 | FEMALE ELBOW |  | EA | 1 | 1 | 001-0353-9
3 | R | RTV-102 | 01139 | ADHESIVE |  | TU | .01 | .01 | 001-0353-9
3 | P | 1523M2B | 28968 | VALVE |  | EA | 1 | 1 | 001-0353-9
3 | P | SS-2-T | 02570 | TEE |  | EA | 2 | 2 | 001-0353-9
3 | P | B-405-2 | 02570 | INSERT |  | EA | 1 | 1 | 001-0353-9
3 | D | 001-0353-3-H |  | TUBE |  | EA | 1 | 1 | 001-0353-9
4 | R | B-44-3X1/4ODX1/8ID | 34384 | TUBING,TYGON |  | FT | 2.67 | 2.67 | 001-0353-3
3 | P | B-5-HC-1-2 | 02570 | HOSE CONNECTOR |  | EA | 1 | 1 | 001-0353-9
3 | D | 001-0353-1-H |  | TUBE |  | EA | 1 | 1 | 001-0353-9
4 | R | B-44-3X1/4ODX1/8ID | 34384 | TUBING,TYGON |  | FT | .792 | .792 | 001-0353-1
2 | A | 001-0352-1-B |  | SUPPORT ASSY |  | EA | 2 | 2 | 001-3063-9
3 | D | 001-0352-3-B |  | SUPPORT |  | EA | 1 | 2 | 001-0352-1
4 | R | 6061-T6 .063 250/11 |  | SHEET | .146X.525 | SF | .08 | .16 | 001-0352-3
3 | D | 001-0352-5-B |  | SPACER |  | EA | 1 | 2 | 001-0352-1
4 | R | 6061-T6 .063 250/11 |  | SHEET | .146X.625 | SF | .1 | .2 | 001-0352-5
3 | P | 9655-08 | 19738 | NUTSERT |  | EA | 8 | 16 | 001-0352-1
3 | P | 1682-0412 | 19738 | RIVET |  | EA | 3 | 6 | 001-0352-1
2 | A | 001-1107-19-R |  | INNER STRUCTURE |  | EA | 1 | 1 | 001-3063-9
3 | A | 001-1166-9-A |  | ALTERNATOR ASSY |  | EA | 1 | 1 | 001-1107-19
4 | A | 001-1157-9-E |  | BULKHEAD ASSY |  | EA | 1 | 1 | 001-1166-9
5 | D | 001-1157-1-E |  | BULKHEAD |  | EA | 1 | 1 | 001-1157-9
6 | M | 056-00021-1-R |  | BULKHEAD |  | EA | 1 | 1 | 001-1157-1
7 | X | 056-00021-1S-R |  | BULKHEAD,FORM |  | EA | 1 | 1 | 056-00021-1
7 | Q | 2024-0 .063 250/4 |  | SHEET | 1.108X1.12 | SF | 1.24 | 1.24 | 056-00021-1
5 | P | CCR264CS-3-2 | 11815 | RIVET |  | EA | 8 | 8 | 001-1157-9
5 | P | NAS1068A08 |  | NUTPLATE |  | EA | 4 | 4 | 001-1157-9
4 | A | 001-1205-9-N |  | ALTERNATOR,MODIFIED |  | EA | 1 | 1 | 001-1166-9
5 | D | 001-1291-B |  | COVER,ALTERNATOR |  | EA | 1 | 1 | 001-1205-9
6 | X | 8EM3003GA COVER |  | COVER,ALTERNATOR |  | EA | 1 | 1 | 001-1291
5 | P | AN960D10 |  | WASHER |  | EA | 8 | 8 | 001-1205-9
5 | P | AN960-10 |  | WASHER |  | EA | 2 | 2 | 001-1205-9
5 | P | AN960-10L |  | WASHER |  | EA | 4 | 4 | 001-1205-9
5 | P | MS25036-103 |  | TERMINAL |  | EA | 2 | 2 | 001-1205-9
5 | P | MS35207-265 |  | SCREW |  | EA | 2 | 2 | 001-1205-9
5 | P | MS35333-39 |  | WASHER |  | EA | 4 | 4 | 001-1205-9
5 | R | M16878/1BGE0 |  | WIRE,20,BLACK |  | FT | .5 | .5 | 001-1205-9
5 | R | 10-9002 | 72653 | VARNISH,SEALING |  | GL | .01 | .01 | 001-1205-9
5 | P | 103-57 | 68505 | BRUSH ASSY |  | EA | 1 | 1 | 001-1205-9
5 | P | 405 | 02972 | KEY,WOODRUFF,1/8X5/8 |  | EA | 1 | 1 | 001-1205-9
5 | R | 63531 | 05972 | COMPOUND,RETAINING |  | BT | .01 | .01 | 001-1205-9
5 | P | 8EM3003GA | 68505 | ALTERNATOR |  | EA | 1 | 1 | 001-1205-9
5 | P | MS35650-302 |  | NUT |  | EA | 4 | 4 | 001-1205-9
5 | P | MS21083N3 |  | NUT |  | EA | 8 | 8 | 001-1205-9
5 | D | 001-1205-1-N |  | ROD,THREADED |  | EA | 4 | 4 | 001-1205-9
6 | R | 10-32 STL CAD PLATED |  | ROD,THREADED |  | FT | .417 | 1.67 | 001-1205-1
4 | R | 10-9002 | 72653 | VARNISH,SEALING |  | GL | .01 | .01 | 001-1166-9
3 | A | 001-1080-19-Y |  | TOW BULKHEAD ASSY |  | EA | 1 | 1 | 001-1107-19
4 | D | 001-1063-H |  | BRACKET |  | EA | 1 | 1 | 001-1080-19
5 | R | 6061-T6 .063 250/11 |  | SHEET | .667X1.25 | SF | .833 | .8332 | 001-1063
4 | D | 001-1101-D |  | ANGLE |  | EA | 1 | 1 | 001-1080-19
5 | R | 6061-T6 .125 250/11 |  | SHEET | .188X.25 | SF | .047 | .047 | 001-1101
4 | A | 001-1095-9-K |  | SERVO ASSY |  | EA | 1 | 1 | 001-1080-19
5 | S | 001-5023-D |  | MOTOR |  | EA | 1 | 1 | 001-1095-9
5 | P | F78SA103 | 08815 | POTENTIOMETER |  | EA | 1 | 1 | 001-1095-9
5 | S | 001-1096-D |  | BRACKET |  | EA | 1 | 1 | 001-1095-9
5 | A | 001-1072-9-P |  | GEAR&LINK ASSY |  | EA | 1 | 1 | 001-1095-9
6 | A | 001-1072-3-P |  | WELDMENT |  | EA | 1 | 1 | 001-1072-9
7 | S | 001-1072-3S-P |  | WELDMENT,CAD PLATE |  | EA | 1 | 1 | 001-1072-3
7 | D | 001-1072-1-P |  | LINK |  | EA | 1 | 1 | 001-1072-3
8 | R | 4130 .063 |  | SHEET,MIL-S-18729 | .104X.167 | SF | .017 | .017 | 001-1072-1
7 | S | 001-1069-E |  | SCREW,SHOULDER |  | EA | 1 | 1 | 001-1072-3
6 | P | MS20470AD2-5 |  | RIVET |  | EA | 4 | 4 | 001-1072-9
6 | P | P64S28-60 | 29440 | GEAR,SPUR |  | EA | 1 | 1 | 001-1072-9
6 | P | AN565B6H6 |  | SCREW,SET |  | EA | 2 | 2 | 001-1072-9
5 | P | AN500-4-5 |  | SCREW |  | EA | 4 | 42 | 001-1095-9
5 | P | P64S10-20 | 29440 | GEAR,SPUR |  | EA | 1 | 1 | 001-1095-9
5 | P | L3-22 | 00141 | CLEATS,MOTOR MOUNT |  | EA | 3 | 3 | 001-1095-9
5 | P | CCR264CS-3-03 | 11815 | RIVET |  | EA | 4 | 4 | 001-1095-9
5 | P | NAS1068A08 |  | NUTPLATE |  | EA | 2 | 2 | 001-1095-9
5 | R | 22231 | 05972 | THREAD LOCK |  | BT | .01 | .01 | 001-1095-9
5 | R | 63531 | 05972 | COMPOUND,RETAINING |  | BT | .01 | .01 | 001-1095-9
5 | R | 74756 | 05972 | PRIMER T |  | BT | .01 | .01 | 001-1095-9
4 | A | 001-1070-1-K |  | ARM WELDMENT |  | EA | 1 | 1 | 001-1080-19
5 | S | 001-1070-1S-K |  | ARM,CAD PLATE |  | EA | 1 | 1 | 001-1070-1
5 | D | 001-1070-3-K |  | BRACKET |  | EA | 1 | 1 | 001-1070-1
6 | R | 4130A .063 |  | SHEET,MIL-S-18729 | .292X.292 | SF | .085 | .085 | 001-1070-3
5 | D | 001-1070-5-K |  | TUBE |  | EA | 1 | 1 | 001-1070-1
6 | R | 4130 1.00ODX.134W |  | TUBE,MIL-T-6736 |  | FT | .052 | .052 | 001-1070-3
5 | S | 001-1069-E |  | SCREW,SHOULDER |  | EA | 1 | 1 | 001-1070-1
4 | D | 001-1071-C |  | LINK |  | EA | 1 | 1 | 001-1080-19
5 | S | 001-1071S-C |  | LINK,CAD PLATE |  | EA | 1 | 1 | 001-1071
5 | R | 4130A .063 MILS18729 |  | SHEET | .083X.333 | SF | .028 | .028 | 001-1071
4 | A | 001-1054-9-F |  | SUPPORT ASSY |  | EA | 2 | 2 | 001-1080-19
5 | P | 9655-08 | 19738 | NUTSERT |  | EA | 4 | 8 | 001-1054-9
5 | D | 001-1054-1-F |  | SUPPORT |  | EA | 1 | 2 | 001-1054-9
6 | R | 6061-T6 .090 250/11 |  | SHEET | .417X.583 | SF | .243 | .4861 | 001-1054-1
4 | A | 001-1102-1-D |  | COLLAR WELDMENT |  | EA | 2 | 2 | 001-1080-19
5 | S | 001-1102-1S-D |  | COLLAR,CAD PLATE |  | EA | 1 | 2 | 001-1102-1
5 | D | 001-1102-3-D |  | TUBE |  | EA | 1 | 2 | 001-1102-1
6 | R | 4130 1.00ODX.134W |  | TUBE,MIL-T-6736 |  | FT | .042 | .084 | 001-1102-3
5 | D | 001-1102-5-D |  | ACTUATOR |  | EA | 1 | 2 | 001-1102-1
6 | R | 1020 .25X.25 |  | BAR |  | FT | .031 | .062 | 001-1102-5
4 | A | 001-1110-9-K |  | SHAFT ASSY |  | EA | 1 | 1 | 001-1080-19
5 | S | 001-1110-1-K |  | SHAFT |  | EA | 1 | 1 | 001-1110-9
5 | P | NAS577B4A |  | NUT,BARREL |  | EA | 2 | 2 | 001-1110-9
5 | P | 2577-048RET | 72962 | RETAINER |  | EA | 2 | 2 | 001-1110-9
4 | P | F3NY-187NA | 62619 | CLAMP |  | EA | 3 | 3 | 001-1080-19
4 | P | 111SM2-T | 91929 | SWITCH |  | EA | 2 | 2 | 001-1080-19
4 | P | 4X729 | 25795 | PILLOW BLOCK |  | EA | 2 | 2 | 001-1080-19
4 | P | 1N4002 |  | DIODE |  | EA | 2 | 2 | 001-1080-19
4 | P | 6H1 | 05245 | FILTER |  | EA | 1 | 1 | 001-1080-19
4 | D | 001-0142-D |  | ANGLE |  | EA | 1 | 1 | 001-1080-19
5 | R | 6061-T6 .25X1.5X1.5 |  | ANGLE |  | FT | .167 | .167 | 001-0142
4 | P | NAS1068A4 |  | NUTPLATE |  | EA | 1 | 1 | 001-1080-19
4 | P | MS20426AD3-8 |  | RIVET |  | EA | 2 | 2 | 001-1080-19
4 | D | 001-1080-1-Y |  | INSULATOR |  | EA | 1 | 1 | 001-1080-19
5 | R | NO.560 .010 FIBEROID | 72653 | PAPER, FISH |  | RL | .005 | .005 | 001-1080-1
4 | A | 001-1075-9-G |  | INNER STRUCTURE ASSY |  | EA | 1 | 1 | 001-1080-19
5 | D | 001-1052-1-B |  | BULKHEAD |  | EA | 1 | 1 | 001-1075-9
6 | M | 056-00021-1-R |  | BULKHEAD |  | EA | 1 | 1 | 001-1052-1
7 | X | 056-00021-1S-R |  | BULKHEAD,FORM |  | EA | 1 | 1 | 056-00021-1
7 | Q | 2024-0 .063 250/4 |  | SHEET | 1.108X1.12 | SF | 1.24 | 1.24 | 056-00021-1
5 | D | 001-1053-1-F |  | SUPPORT |  | EA | 1 | 1 | 001-1075-9
6 | R | 6061-T6 .090 250/11 |  | SHEET | .583X.833 | SF | .486 | .4904 | 001-1053-1
5 | D | 001-1053-3-F |  | SUPPORT |  | EA | 2 | 2 | 001-1075-9
6 | R | 6061-T6 .090 250/11 |  | SHEET | .583X.833 | SF | .486 | .9787 | 001-1053-3
5 | D | 001-1158-E |  | BULKHEAD |  | EA | 1 | 1 | 001-1075-9
6 | M | 056-00021-1-R |  | BULKHEAD |  | EA | 1 | 1 | 001-1158
7 | X | 056-00021-1S-R |  | BULKHEAD,FORM |  | EA | 1 | 1 | 056-00021-1
7 | Q | 2024-0 .063 250/4 |  | SHEET | 1.108X1.12 | SF | 1.24 | 1.24 | 056-00021-1
5 | P | CCR264CS-3-03 | 11815 | RIVET |  | EA | 4 | 4 | 001-1075-9
5 | P | MS20426AD5-5 |  | RIVET |  | EA | 12 | 12 | 001-1075-9
5 | P | NAS1068A08 |  | NUTPLATE |  | EA | 2 | 2 | 001-1075-9
5 | P | 9505-08 | 19738 | NUTSERT |  | EA | 3 | 3 | 001-1075-9
5 | P | 9655-08 | 19738 | NUTSERT |  | EA | 2 | 2 | 001-1075-9
4 | P | AN6-5 |  | BOLT |  | EA | 4 | 4 | 001-1080-19
4 | P | MS21083N6 |  | NUT |  | EA | 4 | 4 | 001-1080-19
4 | P | CL-257 | 99862 | WASHER |  | EA | 4 | 4 | 001-1080-19
4 | P | MS35206-244 |  | SCREW |  | EA | 8 | 8 | 001-1080-19
4 | P | MS21083N08 |  | NUT |  | EA | 8 | 8 | 001-1080-19
4 | P | MS35206-208 |  | SCREW |  | EA | 4 | 4 | 001-1080-19
4 | P | MS21042-02 |  | NUT |  | EA | 6 | 6 | 001-1080-19
4 | P | MS21083N04 |  | NUT |  | EA | 4 | 4 | 001-1080-19
4 | P | AN565A8H3 |  | SCREW,SET |  | EA | 4 | 4 | 001-1080-19
4 | P | MS15795-802 |  | WASHER |  | EA | 4 | 4 | 001-1080-19
4 | P | AN960-8 |  | WASHER |  | EA | 2 | 2 | 001-1080-19
4 | P | MS35206-243 |  | SCREW |  | EA | 2 | 2 | 001-1080-19
4 | P | MS3367-1-9 |  | STRAP |  | EA | 1 | 1 | 001-1080-19
4 | P | MS35206-205 |  | SCREW |  | EA | 2 | 2 | 001-1080-19
4 | P | MS35206-246 |  | SCREW |  | EA | 6 | 6 | 001-1080-19
4 | R | 22231 | 05972 | THREAD LOCK |  | BT | .01 | .01 | 001-1080-19
4 | D | 001-1151-E |  | STIFFENER |  | EA | 1 | 1 | 001-1080-19
5 | R | 6061-T6 .063 250/11 |  | SHEET | .166X.667 | SF | .11 | .11 | 001-1151
4 | P | ASK-3 | 06915 | CLIP |  | EA | 2 | 2 | 001-1080-19
4 | P | MS20426AD4-5 |  | RIVET |  | EA | 5 | 5 | 001-1080-19
4 | P | MS24694-S4 |  | SCREW |  | EA | 1 | 1 | 001-1080-19
4 | P | 3059J-1-203 | 32997 | POTENTIOMETER |  | EA | 1 | 1 | 001-1080-19
4 | P | M83519/2-8 |  | SLEEVE,SOLDER |  | EA | 1 | 1 | 001-1080-19
4 | A | 001-1375-9-D |  | SERVO AMP ASSY |  | EA | 1 | 1 | 001-1080-19
5 | A | 001-1377-9-F |  | PC BOARD ASSY |  | EA | 1 | 1 | 001-1375-9
6 | S | 001-1376-B |  | PC BOARD |  | EA | 1 | 1 | 001-1377-9
6 | P | 30GAT27 | 11187 | CAPACITOR |  | EA | 1 | 1 | 001-1377-9
6 | P | RC07GF103J |  | RESISTOR |  | EA | 2 | 2 | 001-1377-9
6 | P | 199D335X0035BA1 | 56289 | CAPACITOR |  | EA | 1 | 1 | 001-1377-9
6 | P | RC07GF303J |  | RESISTOR |  | EA | 2 | 2 | 001-1377-9
6 | P | RC07GF512J |  | RESISTOR |  | EA | 2 | 2 | 001-1377-9
6 | P | RC07GF134J |  | RESISTOR |  | EA | 2 | 2 | 001-1377-9
6 | P | RC07GF243J |  | RESISTOR |  | EA | 2 | 2 | 001-1377-9
6 | P | 199D476X0035FE2 | 56289 | CAPACITOR |  | EA | 1 | 1 | 001-1377-9
6 | R | QQW343S20SIT |  | WIRE,JUMPER |  | FT | .33 | .33 | 001-1377-9
6 | P | 199D106X0035DA1 | 56289 | CAPACITOR,10UF,33V |  | EA | 2 | 2 | 001-1377-9
6 | T | 001-1378-B |  | SCHEMATIC |  | EA | 1 | 1 | 001-1377-9
5 | D | 001-1379-D |  | BRACKET |  | EA | 1 | 1 | 001-1375-9
6 | R | 6061-T6 .032 250/11 |  | SHEET | .250X.531 | SF | .133 | .133 | 001-1379
5 | P | MS35206-226 |  | SCREW |  | EA | 4 | 4 | 001-1375-9
5 | P | MS35206-217 |  | SCREW |  | EA | 4 | 4 | 001-1375-9
5 | P | MS21083N04 |  | NUT |  | EA | 4 | 4 | 001-1375-9
5 | P | NAS43DD0-12 |  | SPACER |  | EA | 4 | 4 | 001-1375-9
5 | P | LWNY-002BK | 95987 | WASHER |  | EA | 4 | 4 | 001-1375-9
5 | P | LM12CLK | 27014 | POWER OP AMP |  | EA | 2 | 2 | 001-1375-9
5 | A | 001-1122-19-G |  | CABLE ASSY |  | EA | 1 | 1 | 001-1377-9
6 | P | MS3116E10-6P |  | CONNECTOR |  | EA | 1 | 1 | 001-1122-19
6 | R | M22759/13-20-9 |  | WIRE,WHITE |  | FT | 17 | 17 | 001-1122-19
6 | P | MS3367-1-9 |  | STRAP |  | EA | 8 | 8 | 001-1122-19
5 | P | MS21083N06 |  | NUT |  | EA | 4 | 4 | 001-1375-9
4 | P | MS35206-217 |  | SCREW |  | EA | 4 | 4 | 001-1080-19
4 | R | M16878/1BEE9 |  | WIRE,24,WHITE |  | FT | 4 | 4 | 001-1080-19
4 | R | M16878/1BGE9 |  | WIRE,20,WHITE |  | FT | 4.67 | 4.6714 | 001-1080-19
4 | P | NAS43DD0-12 |  | SPACER |  | EA | 4 | 4 | 001-1080-19
4 | P | MS3367-4-9 |  | STRAP |  | EA | 7 | 7 | 001-1080-19
4 | T | 001-1204-E |  | SCHEMATIC |  | EA | 1 | 1 | 001-1080-19
3 | R | MS21266-2N |  | GROMMET |  | FT | .67 | .67 | 001-1107-19
3 | P | NAS43DD3-68 |  | SPACER |  | EA | 4 | 4 | 001-1107-19
3 | P | MS21083N3 |  | NUT |  | EA | 4 | 4 | 001-1107-19
3 | A | 001-1238-9-E |  | BRACKET ASSY |  | EA | 1 | 1 | 001-1107-19
4 | D | 001-1259-C |  | BRACKET |  | EA | 1 | 1 | 001-1238-9
5 | R | 6061-T6 .050 250/11 |  | SHEET | .417X.583 | SF | .243 | .243 | 001-1259
4 | P | MS20470A3-3 |  | RIVET |  | EA | 2 | 2 | 001-1238-9
4 | P | MS25036-150 |  | TERMINAL |  | EA | 1 | 1 | 001-1238-9
4 | P | MS25036-103 |  | TERMINAL |  | EA | 2 | 2 | 001-1238-9
4 | P | AN960D10 |  | WASHER |  | EA | 3 | 3 | 001-1238-9
4 | P | 1682-0412 | 19738 | RIVET |  | EA | 2 | 2 | 001-1238-9
4 | P | 1604-0615 | 19738 | RIVET |  | EA | 3 | 3 | 001-1238-9
4 | P | 9655-08 | 19738 | NUTSERT |  | EA | 4 | 4 | 001-1238-9
4 | P | 856 | 91833 | TERMINAL STRIP |  | EA | 1 | 1 | 001-1238-9
4 | P | 2K-1B-126 | 02289 | RELAY |  | EA | 1 | 1 | 001-1238-9
4 | P | 8RD3024A | 31211 | REGULATOR |  | EA | 1 | 1 | 001-1238-9
4 | R | M16878/1BGE0 |  | WIRE,20,BLACK |  | FT | 1 | 1 | 001-1238-9
4 | R | M16878/1BGE2 |  | WIRE,20,RED |  | FT | 1 | 1 | 001-1238-9
4 | R | M16878/1BGE5 |  | WIRE,20,GREEN |  | FT | 1 | 1 | 001-1238-9
3 | D | 001-1155-6-D |  | DECAL |  | EA | 1 | 1 | 001-1107-19
4 | R | 3R994 | XEROX | DRAFTING FILM |  | SF | .03 | .03 | 001-1155-6
3 | P | MS35206-244 |  | SCREW |  | EA | 4 | 4 | 001-1107-19
3 | T | 001-1204-E |  | SCHEMATIC |  | EA | 1 | 1 | 001-1107-19
3 | T | 001-3091-B |  | SCHEMATIC |  | EA | 1 | 1 | 001-1107-19
3 | T | 001-5054-D |  | PROCEDURE,ASSEMBLY |  | EA | 1 | 1 | 001-1107-19
2 | A | 001-1382-9-C |  | CABLE ASSY |  | EA | 1 | 1 | 001-3063-9
3 | P | MS3116E8-4S |  | CONNECTOR |  | EA | 1 | 1 | 001-1382-9
3 | P | MS3116E8-4P |  | CONNECTOR |  | EA | 1 | 1 | 001-1382-9
3 | P | M83519/2-2 |  | SLEEVE,SOLDER |  | EA | 2 | 2 | 001-1382-9
3 | R | M22759/13-20-9 |  | WIRE,WHITE |  | FT | 10.7 | 10.7 | 001-1382-9
3 | R | M27500-20ML1T08 |  | WIRE |  | FT | 5.33 | 5.33 | 001-1382-9
3 | P | MS3367-4-9 |  | STRAP |  | EA | 16 | 16 | 001-1382-9
2 | A | 001-1374-9 |  | CABLE ASSY |  | EA | 1 | 1 | 001-3063-9
3 | P | UG-913A/U |  | CONNECTOR |  | EA | 1 | 1 | 001-1374-9
3 | P | 2031-5002-02 | 26805 | CONNECTOR |  | EA | 1 | 1 | 001-1374-9
3 | R | RG-223/U |  | CABLE,COAX |  | FT | 4.09 | 4.09 | 001-1374-9
2 | D | 001-3073-B |  | FUSELAGE |  | EA | 1 | 1 | 001-3063-9
3 | S | STD-0143-3-C |  | BODY |  | EA | 1 | 1 | 001-3073
2 | A | 001-1210-39-J |  | CABLE ASSY |  | EA | 1 | 1 | 001-3063-9
3 | P | UG-88E/U |  | CONNECTOR |  | EA | 1 | 1 | 001-1210-39
3 | R | RG-223/U |  | CABLE,COAX |  | FT | 2.09 | 2.09 | 001-1210-39
3 | P | 2031-5002-02 | 26805 | CONNECTOR |  | EA | 1 | 1 | 001-1210-39
2 | A | 001-3059-9-B |  | BRACKET ASSY |  | EA | 1 | 1 | 001-3063-9
3 | D | 001-3059-1-B |  | PLATE |  | EA | 1 | 1 | 001-3059-9
4 | R | 6061-T6 .063 250/11 |  | SHEET | .198X.427 | SF | .085 | .085 | 001-3059-1
3 | P | MS24510-A-10 |  | BREAKER |  | EA | 1 | 1 | 001-3059-9
3 | P | 1506-102 | 83330 | TIP,JACK,RED |  | EA | 3 | 3 | 001-3059-9
3 | P | 1506-103 | 83330 | TIP,JACK,BLACK |  | EA | 2 | 2 | 001-3059-9
3 | R | FIT-221-1/8Y | 92194 | SHRINK TUBING |  | FT | 1 | 1 | 001-3059-9
3 | R | M16878/1BGE9 |  | WIRE,20,WHITE |  | FT | 6 | 6 | 001-3059-9
3 | R | M16878/1BKE9 |  | WIRE,14,WHITE |  | FT | 4.5 | 4.5 | 001-3059-9
3 | P | 1-480426-0 | 00779 | HOUSING,PIN |  | EA | 1 | 1 | 001-3059-9
3 | P | 60618-4 | 00779 | PIN |  | EA | 9 | 9 | 001-3059-9
3 | P | 1-480319-0 | 00779 | HOUSING,PIN |  | EA | 3 | 3 | 001-3059-9
3 | P | 9655-08 | 19738 | NUTSERT |  | EA | 4 | 4 | 001-3059-9
3 | R | FIT-221-1/4Y | 92194 | SHRINK TUBING |  | FT | .083 | .083 | 001-3059-9
3 | P | MS25036-153 |  | TERMINAL |  | EA | 2 | 2 | 001-3059-9
2 | A | 001-1202-9-H |  | CABLE ASSY |  | EA | 1 | 1 | 001-3063-9
3 | P | PT06E-8-2P | 77820 | CONNECTOR |  | EA | 1 | 1 | 001-1202-9
3 | P | PT06E-8-2S | 77820 | CONNECTOR |  | EA | 1 | 1 | 001-1202-9
3 | P | 206708-1 | 00779 | PLUG |  | EA | 1 | 1 | 001-1202-9
3 | P | 66105-2 | 00779 | SOCKET |  | EA | 4 | 4 | 001-1202-9
3 | P | MS25036-108 |  | TERMINAL |  | EA | 1 | 1 | 001-1202-9
3 | P | MS25036-154 |  | TERMINAL |  | EA | 1 | 1 | 001-1202-9
3 | P | 66360-2 | 00779 | SOCKET |  | EA | 2 | 2 | 001-1202-9
3 | R | M16878/4BKE2 |  | WIRE,14,RED |  | FT | 4.17 | 4.1714 | 001-1202-9
3 | R | M16878/4BGE0 |  | WIRE,20,BLACK |  | FT | 6.67 | 6.6713 | 001-1202-9
3 | R | M16878/4BGE2 |  | WIRE,20,RED |  | FT | 6.67 | 6.6713 | 001-1202-9
3 | P | MS3367-4-9 |  | STRAP |  | EA | 12 | 12 | 001-1202-9
3 | R | M16878/4BKE0 |  | WIRE,14,BLACK |  | FT | 6.67 | 6.6714 | 001-1202-9
3 | R | FIT-221-1/8Y | 92194 | SHRINK TUBING |  | FT | .08 | .08 | 001-1202-9
3 | R | FIT-221-3/8Y | 92194 | SHRINK TUBING |  | FT | .08 | .08 | 001-1202-9
2 | P | 33032 | VANCE | FUEL FILTER |  | EA | 1 | 1 | 001-3063-9
2 | D | 001-3063-1-B |  | HOSE |  | EA | 1 | 1 | 001-3063-9
3 | R | 27085 | 24161 | HOSE |  | FT | 1.42 | 1.42 | 001-3063-1
2 | P | 6604 | 62789 | CLAMP |  | EA | 4 | 4 | 001-3063-9
2 | D | 001-3063-3-B |  | HOSE |  | EA | 1 | 1 | 001-3063-9
3 | R | 27085 | 24161 | HOSE |  | FT | 1 | 1 | 001-3063-3
2 | T | 001-3091-B |  | SCHEMATIC |  | EA | 1 | 1 | 001-3063-9
1 | A | 001-3029-9-B |  | TRAY ASSY |  | EA | 1 | 1 | 001-3055-9
2 | A | 001-3026-9-B |  | TRAY ASSY |  | EA | 1 | 1 | 001-3029-9
3 | D | 001-3026-1-B |  | TRAY |  | EA | 1 | 1 | 001-3026-9
4 | R | 6061-T6 .063 250/11 |  | SHEET | .75X1.042 | SF | .782 | .782 | 001-3026-1
3 | D | 001-3027-1-B |  | ANGLE BRACKET |  | EA | 2 | 2 | 001-3026-9
4 | R | 6061-T6 .032 250/11 |  | SHEET | .042X.098 | SF | .004 | .008 | 001-3027-1
3 | P | MS21075-08N |  | NUTPLATE |  | EA | 6 | 6 | 001-3026-9
3 | P | CCR264CS-3-02 | 11815 | RIVET |  | EA | 12 | 12 | 001-3026-9
3 | P | MS20426AD4-5 |  | RIVET |  | EA | 2 | 2 | 001-3026-9
2 | A | 001-3027-5-B |  | BRACKET |  | EA | 2 | 2 | 001-3029-9
3 | R | 6061-T6 .063 250/11 |  | SHEET | .052X.167 | SF | .009 | .018 | 001-3027-5
2 | D | 001-3027-3-B |  | ANGLE |  | EA | 1 | 1 | 001-3029-9
3 | R | 6061-T6 .032 250/11 |  | SHEET | .125X.875 | SF | .109 | .109 | 001-3027-3
2 | A | 001-3034-9-C |  | CONVERTER ASSY |  | EA | 1 | 1 | 001-3029-9
3 | P | 1-480319-0 | 00779 | HOUSING,PIN |  | EA | 1 | 1 | 001-3034-9
3 | P | 1-480426-0 | 00779 | HOUSING,PIN |  | EA | 1 | 1 | 001-3034-9
3 | P | 1-480318-0 | 00779 | HOUSING,SOCKET |  | EA | 2 | 2 | 001-3034-9
3 | P | 60618-4 | 00779 | PIN |  | EA | 6 | 6 | 001-3034-9
3 | P | 60617-4 | 00779 | SOCKET |  | EA | 6 | 6 | 001-3034-9
3 | R | M16878/4BGE0 |  | WIRE,20,BLACK |  | FT | 1.67 | 1.67 | 001-3034-9
3 | R | M16878/4BGE2 |  | WIRE,20,RED |  | FT | 1.75 | 1.75 | 001-3034-9
3 | R | M16878/4BGE3 |  | WIRE,20,ORANGE |  | FT | .25 | .25 | 001-3034-9
3 | R | M16878/4BGE4 |  | WIRE,20,YELLOW |  | FT | .33 | .33 | 001-3034-9
3 | R | M16878/4BGE6 |  | WIRE,20,BLUE |  | FT | .50 | .5 | 001-3034-9
3 | R | M16878/4BGE8 |  | WIRE,20,GRAY |  | FT | 1 | 1 | 001-3034-9
3 | P | 2K-1B-126 | 02289 | RELAY |  | EA | 1 | 1 | 001-3034-9
3 | P | 143-022-01-(110) | 13511 | CONNECTOR |  | EA | 1 | 1 | 001-3034-9
3 | R | FIT-221-1/4Y | 92194 | SHRINK TUBING |  | FT | .33 | .33 | 001-3034-9
3 | R | FIT-221-1/8Y | 92194 | SHRINK TUBING |  | FT | .583 | .583 | 001-3034-9
3 | A | 001-1119-19-K |  | PC BOARD ASSY |  | EA | 1 | 1 | 001-3034-9
4 | P | PKA2314P | 72347 | POWER SUPPLY |  | EA | 1 | 1 | 001-1119-19
4 | P | CSR13F476KM |  | CAPACITOR,47UF,35VDC |  | EA | 1 | 1 | 001-1119-19
4 | P | 109D827X9015T2 | 56289 | CAPACITOR,820UF,15DC |  | EA | 1 | 1 | 001-1119-19
4 | S | 001-1120-1-E |  | PC BOARD |  | EA | 1 | 1 | 001-1119-19
4 | T | 001-5092 |  | PROCEDURE,TEST |  | EA | 1 | 1 | 001-1119-19
3 | P | 1N4002 |  | DIODE |  | EA | 1 | 1 | 001-3034-9
3 | P | 1-480305-0 | 00779 | HOUSING,PIN |  | EA | 2 | 2 | 001-3034-9
2 | P | 1682-0412 | 19738 | RIVET |  | EA | 2 | 2 | 001-3029-9
2 | R | NES-41B .25A | 72781 | SHEET,SPONGE RUBBER | .021X.167 | SF | .004 | .004 | 001-3029-9
2 | P | MS35206-230 |  | SCREW |  | EA | 2 | 2 | 001-3029-9
2 | P | MS24693-S48 |  | SCREW |  | EA | 1 | 1 | 001-3029-9
2 | P | MS35207-263 |  | SCREW |  | EA | 4 | 4 | 001-3029-9
2 | P | MS21083N06 |  | NUT |  | EA | 2 | 2 | 001-3029-9
2 | P | MS21083N08 |  | NUT |  | EA | 1 | 1 | 001-3029-9
2 | P | MS20365-1032 |  | NUT |  | EA | 4 | 4 | 001-3029-9
1 | A | 001-3061-9-C |  | CABLE ASSY |  | EA | 1 | 1 | 001-3055-9
2 | R | M16878/4BGE2 |  | WIRE,20,RED |  | FT | 2.5 | 2.5 | 001-3061-9
2 | R | M16878/4BGE0 |  | WIRE,20,BLACK |  | FT | 2.5 | 2.5 | 001-3061-9
2 | P | PT06E-8-2S | 77820 | CONNECTOR |  | EA | 1 | 1 | 001-3061-9
2 | P | MS3367-4-9 |  | STRAP |  | EA | 5 | 5 | 001-3061-9
2 | R | FIT-221-1/8Y | 92194 | SHRINK TUBING |  | FT | .167 | .167 | 001-3061-9
2 | P | MS3116E8-4P |  | CONNECTOR |  | EA | 1 | 1 | 001-3061-9
1 | A | 001-3072-9-B |  | APC-6 IR POD |  | EA | 1 | 1 | 001-3055-9
2 | D | 001-3032-A |  | COVER |  | EA | 2 | 2 | 001-3072-9
3 | R | KYDEX .093 WHITE | 12626 | SHEET | .800X2 | SF | 1.60 | 3.2 | 001-3032
2 | A | 001-3084-9-A |  | NOSE CONE ASSY |  | EA | 1 | 1 | 001-3072-9
3 | A | 001-3085-9-A |  | NOSE CONE |  | EA | 1 | 1 | 001-3084-9
4 | S | 001-3085-9LR-A |  | NOSE CONE |  | EA | 1 | 1 | 001-3085-9
4 | P | MS20470A3-5 |  | RIVET |  | EA | 32 | 32 | 001-3085-9
4 | P | AN960D3 |  | WASHER |  | EA | 64 | 64 | 001-3085-9
3 | D | 001-3086-1 |  | ORIFICE |  | EA | 1 | 1 | 001-3084-9
4 | R | G-10 1.063IDX.032W |  | TUBE,NEMA TYPE 0111 |  | FT | .083 | .083 | 001-3086
3 | S | 001-0345 |  | SPLICE RING |  | EA | 1 | 1 | 001-3084-9
3 | P | NAS1068A08 |  | NUTPLATE |  | EA | 6 | 6 | 001-3084-9
3 | P | MS20470A4-5 |  | RIVET |  | EA | 6 | 6 | 001-3084-9
3 | R | RTV-102 | 01139 | ADHESIVE |  | TU | .01 | .01 | 001-3084-9
3 | P | CCR264CS-3-02 | 11815 | RIVET |  | EA | 12 | 12 | 001-3084-9
3 | R | 27B | 08028 | SEALANT |  | TU | .25 | .25 | 001-3084-9
2 | P | MS35206-244 |  | SCREW |  | EA | 8 | 8 | 001-3072-9
2 | P | MS35206-243 |  | SCREW |  | EA | 3 | 3 | 001-3072-9
2 | P | MS35206-214 |  | SCREW |  | EA | 8 | 8 | 001-3072-9
2 | P | MS35206-242 |  | SCREW |  | EA | 2 | 2 | 001-3072-9
2 | P | 6604 | 62789 | CLAMP |  | EA | 2 | 2 | 001-3072-9
2 | D | 001-3072-1-B |  | HOSE |  | EA | 1 | 1 | 001-3072-9
3 | R | 27082 | 24161 | HOSE |  | FT | 2.5 | 2.5 | 001-3072-1
2 | P | X2003-8/1150 | 81901 | THERMAL SWITCH |  | EA | 1 | 1 | 001-3072-9
2 | P | AN960-816 |  | WASHER |  | EA | 3 | 3 | 001-3072-9
2 | P | P-561-M05-F02-832 | 04729 | SPACER |  | EA | 1 | 1 | 001-3072-9
2 | A | 001-3061-119-C |  | CABLE ASSY |  | EA | 1 | 1 | 001-3072-9
3 | R | M16878/4BGE9 |  | WIRE,20,WHITE |  | FT | .833 | .833 | 001-3061-119
3 | R | FIT-221-1/8Y | 92194 | SHRINK TUBING |  | FT | .125 | .125 | 001-3061-119
3 | P | 1-480318-0 | 00779 | HOUSING,SOCKET |  | EA | 1 | 1 | 001-3061-119
3 | P | 60617-4 | 00779 | SOCKET |  | EA | 2 | 2 | 001-3061-119
3 | P | MS25036-149 |  | TERMINAL |  | EA | 2 | 2 | 001-3061-119
2 | A | 001-0331-9-G |  | FUEL LINE ASSY |  | EA | 1 | 1 | 001-3072-9
3 | D | 001-0332-C |  | PLATE |  | EA | 1 | 1 | 001-0331-9
4 | R | 304 .075 MIL-S-5059 |  | SHEET | .125X.250 | SF | .031 | .031 | 001-0332
3 | D | 001-0333-B |  | TUBE |  | EA | 1 | 1 | 001-0331-9
4 | R | 304 .250ODX.049W |  | TUBE |  | FT | .5 | .5 | 001-0333
3 | P | 1/8TT-SS+TG-SS1 | 82247 | NOZZLE,FUEL |  | EA | 1 | 1 | 001-0331-9
3 | P | A-400-8-2 | 02570 | ELBOW |  | EA | 1 | 1 | 001-0331-9
3 | P | 9655-08 | 19738 | NUTSERT |  | EA | 3 | 3 | 001-0331-9
3 | P | 60X4 | 79470 | SLEEVE |  | EA | 1 | 1 | 001-0331-9
3 | P | 6051-SS-24 | 82247 | STRAINER |  | EA | 1 | 1 | 001-0331-9
2 | D | 001-3071 |  | COVER |  | EA | 2 | 2 | 001-3072-9
3 | R | MIL-P-18177 .063 |  | SHEET,GRADE GEE | .156X1.271 | SF | .198 | .396 | 001-3071
2 | A | 001-3070-9-C |  | FUSELAGE ASSY |  | EA | 1 | 1 | 001-3072-9
3 | A | 001-3070-1-C |  | FUSELAGE WELDMENT |  | EA | 1 | 1 | 001-3070-9
4 | D | 001-3070-3-C |  | FUSELAGE |  | EA | 1 | 1 | 001-3070-1
5 | R | 321W 5.00ODX.022W |  | TUBE |  | FT | 3.27 | 3.27 | 001-3070-3
4 | D | 001-0337-A |  | BRACKET |  | EA | 2 | 2 | 001-3070-1
5 | R | 304A 1.12ODX.035W |  | TUBE,MIL-T-5695 |  | FT | .063 | .504 | 001-0337
4 | D | 001-0339 |  | ADAPTER |  | EA | 1 | 1 | 001-3070-1
5 | R | 304 .875 QQ-S-766 |  | ROD |  | FT | .021 | .021 | 001-0339
4 | A | 001-0326-1-M |  | ADAPTER WELDMENT |  | EA | 1 | 1 | 001-3070-1
5 | D | 001-0326-5-M |  | BRACKET |  | EA | 1 | 1 | 001-0326-1
6 | R | 304 .035 FINISH NO4 |  | SHEET,MIL-S-5059 | .333X.417 | SF | .139 | .139 | 001-0326-5
5 | D | 001-0326-7-M |  | FAIRING |  | EA | 1 | 1 | 001-0326-1
6 | R | 304 .035 FINISH NO4 |  | SHEET,MIL-S-5059 | .167X2 | SF | .334 | .334 | 001-0326-7
5 | D | 001-0326-11-M |  | FILLER |  | EA | 1 | 1 | 001-0326-1
6 | R | 304 .035 FINISH NO4 |  | SHEET,MIL-S-5059 | .083X.167 | SF | .014 | .014 | 001-0326-11
5 | A | 001-0327-1-A |  | CLAMP,ADAPTER |  | EA | 2 | 2 | 001-0326-1
6 | D | 001-0327-5-A |  | STRIP |  | EA | 1 | 2 | 001-0327-1
7 | R | 304 .025 |  | SHEET | .042X.698 | SF | .029 | .058 | 001-0327-5
6 | D | 001-0327-11-A |  | STRIP |  | EA | 1 | 2 | 001-0327-1
7 | P | MS35842-16 |  | CLAMP |  | EA | .5 | 1 | 001-0327-11
5 | A | 001-0327-3-A |  | CLAMP,ADAPTER |  | EA | 2 | 2 | 001-0326-1
6 | D | 001-0327-7-A |  | STRIP |  | EA | 1 | 2 | 001-0327-3
7 | R | 304 .025 |  | SHEET | .042X.813 | SF | .034 | .068 | 001-0327-7
6 | D | 001-0327-13-A |  | STRIP |  | EA | 1 | 2 | 001-0327-3
7 | P | MS35842-16 |  | CLAMP |  | EA | .5 | 1 | 001-0327-13
5 | P | NAS697A04 |  | NUT |  | EA | 4 | 4 | 001-0326-1
5 | P | MS20426AD2-3 |  | RIVET |  | EA | 8 | 8 | 001-0326-1
4 | D | 001-0326-3-M |  | ADAPTER WELDMENT |  | EA | 1 | 1 | 001-3070-1
5 | D | 001-0326-13-M |  | SUPPORT |  | EA | 1 | 1 | 001-0326-3
6 | R | 304 1.00X1.00X.049W |  | TUBE,SQUARE |  | FT | .17 | .17 | 001-0326-13
5 | D | 001-0326-15-M |  | STRAP |  | EA | 1 | 1 | 001-0326-3
6 | R | 304 .035 FINISH NO4 |  | SHEET,MIL-S-5059 | .083X.75 | SF | .063 | .063 | 001-0326-15
5 | P | NAS697A04 |  | NUT |  | EA | 4 | 4 | 001-0326-3
5 | P | MS20426AD2-3 |  | RIVET |  | EA | 8 | 8 | 001-0326-3
4 | D | 001-3083-A |  | BRACKET |  | EA | 2 | 2 | 001-3070-1
5 | R | 304A 1.12ODX.035W |  | TUBE,MIL-T-5695 |  | FT | .021 | .042 | 001-3083
3 | D | 007-0303 |  | BOSS,IGNITER |  | EA | 2 | 2 | 001-3070-9
4 | R | 6061-T6511 .25X.75 |  | BAR,QQ-A-200/8 |  | FT | .33 | .66 | 007-0303
3 | D | 007-0304-C |  | FLAME HOLDER |  | EA | 4 | 4 | 001-3070-9
4 | R | 347A .032 AMS5512 |  | SHEET | .167X.542 | SF | .091 | .364 | 007-0304
3 | R | RTV-102 | 01139 | ADHESIVE |  | TU | .05 | .05 | 001-3070-9
3 | P | 9655-08 | 19738 | NUTSERT |  | EA | 2 | 2 | 001-3070-9
3 | P | MS35206-245 |  | SCREW |  | EA | 4 | 4 | 001-3070-9
3 | P | MS21083N08 |  | NUT |  | EA | 4 | 4 | 001-3070-9
3 | A | 007-0408-1-J |  | EMITTER WELDMENT |  | EA | 1 | 1 | 001-3070-9
4 | D | 007-0408-3-J |  | CHANNEL |  | EA | 1 | 1 | 007-0408-1
4 | D | 007-0408-5-J |  | CHANNEL |  | EA | 1 | 1 | 007-0408-1
4 | D | 007-0408-7-J |  | CHANNEL |  | EA | 1 | 1 | 007-0408-1
4 | D | 007-0408-11-J |  | SUPPORT |  | EA | 4 | 4 | 007-0408-1
5 | R | 304A .035 MIL-S-5059 |  | SHEET | .032X.063 | SF | .002 | .008 | 007-0408-11
4 | D | 007-0408-13-J |  | RING |  | EA | 1 | 1 | 007-0408-1
5 | R | 304A .035 MIL-S-5059 |  | SHEET | .104X1.375 | SF | .143 | .143 | 007-0408-13
4 | D | 007-0408-15-J |  | DISC |  | EA | 1 | 1 | 007-0408-1
4 | D | 007-0408-17-J |  | DISC |  | EA | 1 | 1 | 007-0408-1
5 | W | STD-5025-D |  | WIREMESH | 1.17X1.17 | SF | 1.36 | 1.36 | 007-0408-17
3 | S | 007-0409-B |  | SHIELD,IR |  | EA | 1 | 1 | 001-3070-9
3 | P | SSD42SSBS | 07707 | RIVET |  | EA | 16 | 16 | 001-3070-9
3 | D | 001-3092-1 |  | DECAL |  | EA | 1 | 1 | 001-3070-9
4 | R | 3R994 | XEROX | DRAFTING FILM | .063X.250 | SF | .016 | .016 | 001-3092-1
3 | D | 001-3092-3 |  | DECAL |  | EA | 1 | 1 | 001-3070-9
4 | R | 3R994 | XEROX | DRAFTING FILM | .063X.250 | SF | .016 | .016 | 001-3092-3
1 | D | 001-3074 |  | NAMEPLATE |  | EA | 1 | 1 | 001-3055-9
2 | R | 3R994 | XEROX | DRAFTING FILM |  | SF | .042 | .042 | 001-3074
1 | D | 001-1073-F |  | DOOR |  | EA | 1 | 1 | 001-3055-9
2 | R | KYDEX .060 ORANGE |  | SHEET | .688X.688 | SF | .473 | .473 | 001-1073
1 | S | 001-1330 |  | DECAL,WING |  | EA | 4 | 4 | 001-3055-9
1 | A | 001-3061-19-C |  | CABLE ASSY |  | EA | 1 | 1 | 001-3055-9
2 | R | M16878/4BGE2 |  | WIRE,20,RED |  | FT | 6.5 | 6.5 | 001-3061-19
2 | R | M16878/4BGE0 |  | WIRE,20,BLACK |  | FT | 1.09 | 1.09 | 001-3061-19
2 | P | PT06E-8-2S | 77820 | CONNECTOR |  | EA | 1 | 1 | 001-3061-19
2 | P | PT06E-8-2P | 77820 | CONNECTOR |  | EA | 1 | 1 | 001-3061-19
2 | P | MS3367-4-9 |  | STRAP |  | EA | 8 | 8 | 001-3061-19
2 | R | FIT-221-1/8Y | 92194 | SHRINK TUBING |  | FT | .167 | .167 | 001-3061-19
2 | P | MS3116E8-4P |  | CONNECTOR |  | EA | 1 | 1 | 001-3061-19
1 | A | 001-3061-29-C |  | CABLE ASSY |  | EA | 1 | 1 | 001-3055-9
2 | R | M16878/4BGE2 |  | WIRE,20,RED |  | FT | 1 | 1 | 001-3061-29
2 | R | M16878/4BGE0 |  | WIRE,20,BLACK |  | FT | 1 | 1 | 001-3061-29
2 | P | PT06E-8-2S | 77820 | CONNECTOR |  | EA | 1 | 1 | 001-3061-29
2 | P | PT07E-8-2P | 77820 | CONNECTOR |  | EA | 2 | 2 | 001-3061-29
2 | P | MS3367-4-9 |  | STRAP |  | EA | 4 | 4 | 001-3061-29
2 | R | FIT-221-1/8Y | 92194 | SHRINK TUBING |  | FT | .167 | .167 | 001-3061-29
2 | P | 327583 | 00779 | SPLICE,BUTT |  | EA | 2 | 2 | 001-3061-29
1 | A | 001-3061-39-C |  | CABLE ASSY |  | EA | 1 | 1 | 001-3055-9
2 | R | M16878/4BGE8 |  | WIRE,20,GREY |  | FT | .417 | .417 | 001-3061-39
2 | R | M16878/4BGE9 |  | WIRE,20,WHITE |  | FT | 16 | 16 | 001-3061-39
2 | R | M16878/4BGE1 |  | WIRE,20,BROWN |  | FT | .417 | .417 | 001-3061-39
2 | P | MS3367-4-9 |  | STRAP |  | EA | 8 | 8 | 001-3061-39
2 | R | FIT-221-1/8Y | 92194 | SHRINK TUBING |  | FT | .167 | .167 | 001-3061-39
2 | P | 1-480318-0 | 00779 | HOUSING,SOCKET |  | EA | 1 | 1 | 001-3061-39
2 | P | 60617-4 | 00779 | SOCKET |  | EA | 2 | 2 | 001-3061-39
2 | P | MS3116E10-6PW |  | CONNECTOR |  | EA | 2 | 2 | 001-3061-39
1 | A | 001-3061-59-C |  | CABLE ASSY |  | EA | 1 | 1 | 001-3055-9
2 | R | M16878/4BGE8 |  | WIRE,20,GREY |  | FT | 2.92 | 2.92 | 001-3061-59
2 | R | M16878/4BGE1 |  | WIRE,20,BROWN |  | FT | 2.92 | 2.92 | 001-3061-59
2 | P | MS3367-4-9 |  | STRAP |  | EA | 6 | 6 | 001-3061-59
2 | R | FIT-221-1/8Y | 92194 | SHRINK TUBING |  | FT | .167 | .167 | 001-3061-59
2 | P | 66105-2 | 00779 | PIN |  | EA | 2 | 2 | 001-3061-59
2 | P | 1-480319-0 | 00779 | HOUSING,PIN |  | EA | 1 | 1 | 001-3061-59
2 | P | 60618-4 | 00779 | PIN |  | EA | 2 | 2 | 001-3061-59
1 | A | 001-3061-69-C |  | CABLE ASSY |  | EA | 1 | 1 | 001-3055-9
2 | R | M16878/4BKE0 |  | WIRE,14,BLACK |  | FT | .333 | .333 | 001-3061-69
2 | R | FIT-221-1/8Y | 92194 | SHRINK TUBING |  | FT | .167 | .167 | 001-3061-69
2 | P | G1820CT | 2S894 | DIODE,5A |  | EA | 1 | 1 | 001-3061-69
2 | P | 1-480318-0 | 00779 | HOUSING,SOCKET |  | EA | 1 | 1 | 001-3061-69
2 | P | 1-480319-0 | 00779 | HOUSING,PIN |  | EA | 1 | 1 | 001-3061-69
2 | P | 60619-4 | 00779 | SOCKET |  | EA | 2 | 2 | 001-3061-69
2 | P | 60620-4 | 00779 | PIN |  | EA | 2 | 2 | 001-3061-69
1 | S | STD-0096-J |  | NAMEPLATE |  | EA | 1 | 1 | 001-3055-9
1 | A | 001-3056-9-C |  | CONTROLLER ASSY |  | EA | 1 | 1 | 001-3055-9
2 | A | 001-3056-19-C |  | COVER ASSY |  | EA | 1 | 1 | 001-3056-9
3 | D | 001-3056-1-C |  | COVER |  | EA | 1 | 1 | 001-3056-19
4 | P | 0711061820 | 4Y520 | COVER |  | EA | 1 | 1 | 001-3056-1
3 | P | MS3112E10-6SW |  | CONNECTOR |  | EA | 1 | 1 | 001-3056-19
3 | P | 10-101949-10 | 77820 | GASKET |  | EA | 1 | 1 | 001-3056-19
3 | P | MS3112E8-4S |  | CONNECTOR |  | EA | 1 | 1 | 001-3056-19
3 | P | 10-101949-8 | 77820 | GASKET |  | EA | 1 | 1 | 001-3056-19
3 | P | MS35206-215 |  | SCREW |  | EA | 8 | 8 | 001-3056-19
3 | P | MS21083N04 |  | NUT |  | EA | 8 | 8 | 001-3056-19
3 | R | M16878/4BGE9 |  | WIRE,20,WHITE |  | FT | 8 | 8 | 001-3056-19
3 | P | 09-50-8043 | 27264 | CONNECTOR |  | EA | 1 | 1 | 001-3056-19
3 | P | 09-50-8063 | 27264 | CONNECTOR |  | EA | 1 | 1 | 001-3056-19
3 | P | 08-56-0106 | 27264 | PIN |  | EA | 10 | 10 | 001-3056-19
2 | A | 001-3056-29-C |  | COVER ASSY |  | EA | 1 | 1 | 001-3056-9
3 | D | 001-3056-3-C |  | COVER |  | EA | 1 | 1 | 001-3056-29
4 | P | 0711061820 | 4Y520 | COVER |  | EA | 1 | 1 | 001-3056-3
3 | P | MS35206-215 |  | SCREW |  | EA | 4 | 4 | 001-3056-29
3 | P | MS21083N04 |  | NUT |  | EA | 4 | 4 | 001-3056-29
3 | R | M16878/4BGE9 |  | WIRE,20,WHITE |  | FT | 7 | 7 | 001-3056-29
3 | P | MS3112E14-19S |  | CONNECTOR |  | EA | 1 | 1 | 001-3056-29
3 | P | 10-101949-14 | 77820 | GASKET |  | EA | 1 | 1 | 001-3056-29
3 | A | 001-3065-9 |  | PC. BOARD ASSY |  | EA | 1 | 1 | 001-3056-29
4 | S | 001-3065-1 |  | PC BOARD |  | EA | 1 | 1 | 001-3065-9
4 | S | 001-3065-3 |  | PC BOARD |  | EA | 1 | 1 | 001-3065-9
4 | P | 240QBK-ND | 2S894 | RESISTOR,240,1/4W,5% |  | EA | 2 | 2 | 001-3065-9
4 | P | 10KQBK-ND | 2S894 | RESISTOR,10K,1/4W,5% |  | EA | 5 | 5 | 001-3065-9
4 | P | 1N5230BCT-ND | 2S894 | DIODE,ZENER,4.7V |  | EA | 2 | 2 | 001-3065-9
4 | P | GI820CT-ND | 2S894 | DIODE,5 AMP |  | EA | 1 | 1 | 001-3065-9
4 | P | 1N4002 |  | DIODE |  | EA | 10 | 10 | 001-3065-9
4 | P | TP0005 | 7T184 | THERMO PAD |  | EA | 2 | 2 | 001-3065-9
4 | P | ED5318-ND | 2S894 | SOCKET,18 PIN IC |  | EA | 2 | 2 | 001-3065-9
4 | P | ULN2803A | OCJC4 | POWER DRIVER INVERTR |  | EA | 2 | 2 | 001-3065-9
4 | P | ED5624-ND | 2S894 | SOCKET,24 PIN IC |  | EA | 1 | 1 | 001-3065-9
4 | P | BS2-1C | 2P190 | BASIC STAMP |  | EA | 1 | 1 | 001-3065-9
4 | P | MC7805CT | 04713 | REGULATOR,5 VOLT |  | EA | 1 | 1 | 001-3065-9
4 | P | MC7812CT | 04713 | REGULATOR,12 VOLT |  | EA | 1 | 1 | 001-3065-9
4 | P | P2049-ND | 2S894 | CAPACITOR,10UF |  | EA | 2 | 2 | 001-3065-9
4 | P | P1353-ND | 2S894 | CAPACITOR,100UF |  | EA | 1 | 1 | 001-3065-9
4 | P | P4887-ND | 2S894 | CAPACITOR,.1UF |  | EA | 1 | 1 | 001-3065-9
4 | P | WM5237-ND | 2S894 | HEADER,4 PIN RT.ANGL |  | EA | 1 | 1 | 001-3065-9
4 | P | WM5239-ND | 2S894 | HEADER,6 PIN RT.ANGL |  | EA | 1 | 1 | 001-3065-9
4 | P | WM2713-ND | 2S894 | HEADER,4 PIN RT.ANGL |  | EA | 1 | 1 | 001-3065-9
4 | P | SLW-110-01-SS | 55322 | SOCKET,BOARD INTER. |  | EA | 2 | 2 | 001-3065-9
4 | P | MTSW-110-09-S-S-495 | 55322 | PIN,BOARD INTERCNNCT |  | EA | 2 | 2 | 001-3065-9
4 | P | P3.9W-2BK-ND | 2S894 | RESISTOR,3.6OHM,2W |  | EA | 9 | 9 | 001-3065-9
4 | P | LZ-24H | 05292 | RELAY,SPDT,5AMP |  | EA | 9 | 9 | 001-3065-9
4 | P | MS21083N04 |  | NUT |  | EA | 6 | 6 | 001-3065-9
4 | P | MS35338-40 |  | WASHER |  | EA | 2 | 2 | 001-3065-9
4 | P | NAS43DD0-45 |  | SPACER |  | EA | 4 | 4 | 001-3065-9
4 | P | MS35206-221 |  | SCREW |  | EA | 4 | 4 | 001-3065-9
2 | A | 001-3056-39-C |  | TRAY ASSY |  | EA | 1 | 1 | 001-3056-29
3 | D | 001-3056-5-C |  | TRAY |  | EA | 1 | 1 | 001-3056-39
4 | R | 6061-T6 .063 250/11 |  | SHEET | .521X.896 | SF | .467 | .467 | 001-3056-5
3 | R | 07111102-40 | 4Y520 | EXTRUSION |  | EA | .083 | .083 | 001-3056-39
3 | P | 6176-2A | 91506 | CLIP |  | EA | 1 | 1 | 001-3056-39
3 | P | MS21075-08 |  | NUTPLATE |  | EA | 4 | 4 | 001-3056-39
3 | P | CCR264CS-3-02 | 11815 | RIVET |  | EA | 8 | 8 | 001-3056-39
3 | P | 1682-0412 | 19738 | RIVET |  | EA | 6 | 6 | 001-3056-39
2 | R | 07111102-40 | 4Y520 | EXTRUSION |  | EA | .083 | .083 | 001-3056-9
2 | R | RTV-102 | 01139 | ADHESIVE |  | TU | .05 | .05 | 001-3056-9
2 | P | CGS622U040R4C | 90201 | CAPACITOR |  | EA | 1 | 1 | 001-3056-9
2 | P | MS35842-13 |  | CLAMP |  | EA | 2 | 2 | 001-3056-9
2 | P | MS35206-227 |  | SCREW |  | EA | 2 | 2 | 001-3056-9
2 | P | MS21083N06 |  | NUT |  | EA | 2 | 2 | 001-3056-9
2 | P | EP286 | 4K816 | PUMP |  | EA | 1 | 1 | 001-3056-9
2 | A | 001-3061-49-B |  | CABLE ASSY |  | EA | 1 | 1 | 001-3056-9
3 | R | M16878/4BGE2 |  | WIRE,20,RED |  | FT | 1.92 | 1.92 | 001-3061-49
3 | R | M16878/4BGE4 |  | WIRE,20,YELLOW |  | FT | 8.67 | 8.67 | 001-3061-49
3 | R | M16878/4BGE6 |  | WIRE,20,BLUE |  | FT | .583 | .583 | 001-3061-49
3 | R | M16878/4BGEPNK |  | WIRE,20,PINK |  | FT | 1.75 | 1.75 | 001-3061-49
3 | R | M16878/4BHE0 |  | WIRE,18,BLACK |  | FT | .833 | .833 | 001-3061-49
3 | R | M16878/4BHE2 |  | WIRE,18,RED |  | FT | .833 | .833 | 001-3061-49
3 | R | M16878/4BGE0 |  | WIRE,20,BLACK |  | FT | 4.09 | 4.09 | 001-3061-49
3 | P | PT06E-14-19P | 77820 | CONNECTOR |  | EA | 1 | 1 | 001-3061-49
3 | P | MS3367-4-9 |  | STRAP |  | EA | 5 | 5 | 001-3061-49
3 | P | MS25036-108 |  | TERMINAL |  | EA | 2 | 2 | 001-3061-49
3 | R | FIT-221-1/8Y | 92194 | SHRINK TUBING |  | FT | .1 | .1 | 001-3061-49
3 | R | FIT-221-1/2Y | 92194 | SHRINK TUBING |  | FT | .1 | .1 | 001-3061-49
3 | P | 1-480318-0 | 00779 | SOCKET,HOUSING |  | EA | 9 | 9 | 001-3061-49
3 | P | 1-480424-0 | 00779 | SOCKET,HOUSING |  | EA | 1 | 1 | 001-3061-49
3 | P | 60617-4 | 00779 | SOCKET |  | EA | 23 | 23 | 001-3061-49
2 | A | 001-3061-79-C |  | CABLE ASSY |  | EA | 1 | 1 | 001-3056-9
3 | R | M16878/4BKE0 |  | WIRE,14,BLACK |  | FT | 1 | 1 | 001-3061-79
3 | P | MS25036-153 |  | TERMINAL |  | EA | 1 | 1 | 001-3061-79
3 | P | MS25036-108 |  | TERMINAL |  | EA | 1 | 1 | 001-3061-79
3 | R | FIT-221-1/8Y | 92194 | SHRINK TUBING |  | FT | .1 | .1 | 001-3061-79
2 | A | 001-3061-99-C |  | CABLE ASSY |  | EA | 1 | 1 | 001-3056-9
3 | R | M16878/4BGE2 |  | WIRE,20,RED |  | FT | .5 | .5 | 001-3061-99
3 | R | M16878/4BKE2 |  | WIRE,14,RED |  | FT | 1 | 1 | 001-3061-99
3 | R | M16878/4BGE0 |  | WIRE,20,BLACK |  | FT | .5 | .5 | 001-3061-99
3 | P | M83536/10-026M |  | RELAY |  | EA | 1 | 1 | 001-3061-99
3 | R | FIT-221-1/8Y | 92194 | SHRINK TUBING |  | FT | .1 | .1 | 001-3061-99
3 | P | 1-480426-0 | 00779 | HOUSING,PIN |  | EA | 1 | 1 | 001-3061-99
3 | P | 60618-4 | 00779 | PIN |  | EA | 2 | 2 | 001-3061-99
3 | P | 60620-4 | 00779 | PIN |  | EA | 2 | 2 | 001-3061-99
3 | R | PVC-105-6 | 92194 | TUBING |  | FT | .167 | .167 | 001-3061-99
2 | A | 001-3061-109-C |  | CABLE ASSY |  | EA | 1 | 1 | 001-3056-9
3 | R | M16878/4BKE2 |  | WIRE,14,RED |  | FT | 3.75 | 3.75 | 001-3061-109
3 | R | M16878/4BGE0 |  | WIRE,20,BLACK |  | FT | .413 | .413 | 001-3061-109
3 | R | FIT-221-1/8Y | 92194 | SHRINK TUBING |  | FT | .1 | .1 | 001-3061-109
3 | P | 1-480318-0 | 00779 | HOUSING,SOCKET |  | EA | 1 | 1 | 001-3061-109
3 | P | 1-480424-0 | 00779 | HOUSING,SOCKET |  | EA | 1 | 1 | 001-3061-109
3 | P | 60617-4 | 00779 | SOCKET |  | EA | 6 | 6 | 001-3061-109
3 | P | MS25036-103 |  | TERMINAL |  | EA | 3 | 3 | 001-3061-109
3 | R | FIT-221-3/8Y | 92194 | SHRINK TUBING |  | FT | .1 | .1 | 001-3061-109
3 | P | M7928/5-5 |  | SPLICE,BUTT |  | EA | 1 | 1 | 001-3061-109
2 | A | 001-3061-139-C |  | CABLE ASSY |  | EA | 1 | 1 | 001-3056-9
3 | R | M16878/4BKE0 |  | WIRE,14,BLACK |  | FT | .5 | .5 | 001-3061-139
3 | R | M16878/4BKE2 |  | WIRE,14,RED |  | FT | .5 | .5 | 001-3061-139
3 | P | MS25036-108 |  | TERMINAL |  | EA | 2 | 2 | 001-3061-139
3 | R | FIT-221-1/8Y | 92194 | SHRINK TUBING |  | FT | .125 | .125 | 001-3061-139
3 | P | 1-480319-0 | 00779 | HOUSING,PIN |  | EA | 1 | 1 | 001-3061-139
3 | P | 60620-4 | 00779 | PIN |  | EA | 2 | 2 | 001-3061-139
2 | R | 10-9002 | 72653 | VARNISH,SEALING |  | GL | .01 | .01 | 001-3056-9
2 | T | 001-3062 |  | WIRING DIAGRAM |  | EA | 1 | 1 | 001-3056-9
2 | T | 001-5144 |  | TEST PROCEDURE |  | EA | 1 | 1 | 001-3056-9
1 | A | 001-0367-9-E |  | SHIPPING ARRANGEMENT |  | EA | 1 | 1 | 001-3055-9
2 | S | 041-0326-B |  | CUSHION |  | EA | 1 | 1 | 001-0367-9
2 | S | 001-0366-1 |  | BOX |  | EA | 1 | 1 | 001-0367-9
2 | S | 001-0366-3 |  | DOUBLER |  | EA | 2 | 2 | 001-0367-9
2 | S | 001-0368 |  | DOUBLER |  | EA | 2 | 2 | 001-0367-9
2 | S | 041-0322-E |  | CRADLE |  | EA | 6 | 6 | 001-0367-9
2 | D | 001-0397 |  | END STOP |  | EA | 1 | 1 | 001-0367-9
3 | S | 041-0323-B |  | END STOP |  | EA | 1 | 1 | 001-0397
2 | R | MIL-B-117-24W |  | BARRIER TUBE |  | FT | 10.9 | 10.92 | 001-0367-9
2 | D | 001-0367-1-E |  | STOP |  | EA | 1 | 1 | 001-0367-9
3 | R | PLYWOOD 1/2THK |  | SHEET | 1.333X2 | SH | .083 | .083 | 001-0367-1
2 | S | 041-1227 |  | SPACER |  | EA | 1 | 1 | 001-0367-9
2 | D | 001-0367-3-E |  | BRACE |  | EA | 2 | 2 | 001-0367-9
3 | R | 1X4X8FT |  | LUMBER,PINE |  | EA | .23 | .46 | 001-0367-3
2 | R | ST-120 | 51875 | CAP,AIR |  | RL | .01 | .01 | 001-0367-9
2 | P | BCS834-1.5 | 08075 | STAPLE |  | EA | 34 | 34 | 001-0367-9
2 | P | SW9040X.875 | 08075 | STAPLE |  | EA | 20 | 20 | 001-0367-9
2 | R | STL .020X.375W |  | BANDING,STEEL |  | RL | 24 | 24 | 001-0367-9
2 | R | E-395 | 86142 | GLUE |  | GL | .01 | .01 | 001-0367-9
2 | P | MIL-D-3464TYI 8UNIT |  | DESICANT |  | BG | 5 | 5 | 001-0367-9
2 | S | 001-0371 |  | CRADLE |  | EA | 2 | 2 | 001-0367-9
2 | S | 001-0370 |  | SUPPORT |  | EA | 2 | 2 | 001-0367-9
2 | P | MIL-D-3464TYI 1UNIT |  | DESICANT |  | BG | 1 | 1 | 001-0367-9
2 | R | MIL-B-117-18W |  | BARRIER TUBE |  | FT | 2.5 | 2.5 | 001-0367-9
2 | R | MIL-B-117-6W |  | BARRIER TUBE |  | FT | .833 | .833 | 001-0367-9
1 | D | 001-3087-A |  | DECAL |  | EA | 1 | 1 | 001-3055-9
2 | R | 3R994 | XEROX | DRAFTING FILM |  | SF | .042 | .042 | 001-3087
1 | A | 001-1372-9-B |  | CABLE ASSY |  | EA | 1 | 1 | 001-3055-9
2 | P | MS3116F10-98P |  | CONNECTOR |  | EA | 1 | 1 | 001-1372-9
2 | R | 5196 | 92194 | CABLE |  | FT | 1.09 | 1.09 | 001-1372-9
2 | P | MS25036-102 |  | TERMINAL |  | EA | 1 | 1 | 001-1372-9
1 | A | 001-1373-9-C |  | ANTENNA ASSY |  | EA | 2 | 2 | 001-3055-9
2 | X | 1900-0457-00 |  | ANTENNA |  | EA | 1 | 2 | 001-1373-9
2 | X | 1910-6785-02 |  | GASKET |  | EA | 2 | 4 | 001-1373-9
2 | A | 001-1366-9 |  | BRACKET ASSY |  | EA | 1 | 2 | 001-1373-9
3 | D | 001-1366-1 |  | BRACKET |  | EA | 1 | 2 | 001-1366-9
4 | R | 6061-T6 .050 250/11 |  | SHEET | .358X.608 | SF | .218 | .436 | 001-1366-1
3 | P | 9655-08 | 19738 | NUTSERT |  | EA | 4 | 8 | 001-1366-9
2 | P | MS35206-231 |  | SCREW |  | EA | 4 | 8 | 001-1373-9
2 | P | MS21083N06 |  | NUT |  | EA | 4 | 8 | 001-1373-9
1 | A | 001-1412-9-A |  | CABLE ASSY |  | EA | 1 | 1 | 001-3055-9
2 | P | MS3116E8-4PW |  | CONNECTOR |  | EA | 2 | 2 | 001-1412-9
2 | P | M83519/2-2 |  | SLEEVE,SOLDER |  | EA | 2 | 2 | 001-1412-9
2 | R | M27500-20ML1T08 |  | WIRE |  | FT | .75 | .75 | 001-1412-9
2 | R | M22759/13-20-9 |  | WIRE,WHITE |  | FT | 1.5 | 1.5 | 001-1412-9
2 | P | MS3367-4-9 |  | STRAP |  | EA | 4 | 4 | 001-1412-9
1 | P | MS21083N8 |  | NUT |  | EA | 1 | 1 | 001-3055-9
1 | P | MS24693-S50 |  | SCREW |  | EA | 51 | 51 | 001-3055-9
1 | P | A3135-017-935 | 78553 | WASHER |  | EA | 48 | 48 | 001-3055-9
1 | P | MS24693-S51 |  | SCREW |  | EA | 24 | 24 | 001-3055-9
1 | P | 1/4-28X3.25LG |  | SCREW,SOCKET HD CAP |  | EA | 2 | 2 | 001-3055-9
1 | P | AN525-832R6 |  | SCREW |  | EA | 14 | 14 | 001-3055-9
1 | A | 001-0153-9-L |  | TARGET ADAPTER ASSY |  | EA | 1 | 1 | 001-3055-9
2 | S | TE21046-C |  | LOCK COLLAR |  | EA | 1 | 1 | 001-0153-9
2 | S | TE21051-B |  | NOSE |  | EA | 1 | 1 | 001-0153-9
2 | P | NTA-613 | 60380 | THRUST BEARING |  | EA | 1 | 1 | 001-0153-9
2 | S | TE21106-A |  | BUSHING |  | EA | 1 | 1 | 001-0153-9
2 | M | 001-0154 |  | KEY |  | EA | 1 | 1 | 001-0153-9
2 | P | AN960C516L |  | WASHER |  | EA | 1 | 1 | 001-0153-9
2 | P | MS9245-44 |  | PIN,COTTER |  | EA | 1 | 1 | 001-0153-9
2 | P | MS20392-4C23 |  | PIN,STRAIGHT,HEADED |  | EA | 1 | 1 | 001-0153-9
2 | S | 001-0152-1-F |  | END FITTING |  | EA | 1 | 1 | 001-0153-9
2 | P | TRA-613 | 60380 | THRUST RACE |  | EA | 2 | 2 | 001-0153-9
2 | R | MICROFOAM 1/8 | 13164 | SHEET | 1X1 | RL | .01 | .01 | 001-0153-9
2 | D | 001-0177 |  | DECAL |  | EA | 1 | 1 | 001-0153-9
3 | R | 3R994 | XEROX | DRAFTING FILM | .17X.17 | SF | .03 | .03 | 001-0177
1 | P | AN960PD816L |  | WASHER |  | EA | 1 | 1 | 001-3055-9
1 | D | 041-0239-15-U |  | BALLAST |  | EA | 2 | 2 | 001-3055-9
2 | R | 03262 |  | INHIBITOR (SP-350) |  | CN | .01 | .02 | 041-0239-1
2 | S | STD-0161-A |  | BALLAST,CAST IRON |  | EA | .5 | 1 | 041-0239-1
3 | R | 03262 |  | INHIBITOR (SP-350) |  | CN | .02 | .04 | STD-0161
1 | P | MS24693-S62 |  | SCREW |  | EA | 3 | 3 | 001-3055-9
1 | P | MS21083N08 |  | NUT |  | EA | 3 | 3 | 001-3055-9
1 | A | 001-3088-9-A |  | WING, LABEL |  | EA | 1 | 1 | 001-3055-9
2 | D | STD-0107-1-L |  | WING |  | EA | 1 | 1 | 001-3088-9
3 | S | STD-0109-L |  | WING |  | EA | 1 | 1 | STD-0107-1
2 | D | 001-3087-A |  | DECAL |  | EA | 1 | 1 | 001-3088-9
3 | R | 3R994 | XEROX | DRAFTING FILM |  | SF | .042 | .042 | 001-3087
1 | D | 001-0354-1 |  | WING |  | EA | 1 | 1 | 001-3055-9
2 | D | STD-0107-1-L |  | WING |  | EA | 1 | 1 | 001-0354-1
3 | S | STD-0109-L |  | WING |  | EA | 1 | 1 | STD-0107-1
1 | D | 001-0354-2 |  | WING |  | EA | 1 | 1 | 001-3055-9
2 | D | STD-0107-1-L |  | WING |  | EA | 1 | 1 | 001-0354-2
3 | S | STD-0109-L |  | WING |  | EA | 1 | 1 | STD-0107-1
1 | A | 001-3089-9 |  | KEY ASSY |  | EA | 1 | 1 | 001-3055-9
2 | D | 001-3089-1 |  | WEBBING |  | EA | 1 | 1 | 001-3089-9
3 | R | MIL-W-4088TYICL2RED |  | WEBING,9/16W |  | YD | .292 | .292 | 001-3089-9
2 | P | CL-2-C-8.0 | 99862 | NYLON CABLE |  | EA | 1 | 1 | 001-3089-9
2 | S | 002-5027 |  | FERRULE, CABLE |  | EA | 1 | 1 | 001-3089-9
1 | A | 001-3061-89-C |  | CABLE ASSY |  | EA | 1 | 1 | 001-3055-9
2 | R | M16878/4BGE9 |  | WIRE,20,WHITE |  | FT | 3.5 | 3.5 | 001-3061-89
2 | P | P201133WM03N02 | 0BB05 | SWITCH,KEY |  | EA | 1 | 1 | 001-3061-89
2 | R | FIT-221-1/8Y | 92194 | SHRINK TUBING |  | FT | .1 | .1 | 001-3061-89
2 | P | 60618-4 | 00779 | PIN |  | EA | 3 | 3 | 001-3061-89
2 | P | 1-480305-0 | 00779 | HOUSING,PIN |  | EA | 1 | 1 | 001-3061-89
1 | A | 001-0378-9-D |  | BATTERY PACK |  | EA | 1 | 1 | 001-3055-9
2 | P | MS21083N04 |  | NUT |  | EA | 8 | 8 | 001-0378-9
2 | P | MS35206-214 |  | SCREW |  | EA | 8 | 8 | 001-0378-9
2 | P | PT02E-8-4S | 77820 | CONNECTOR |  | EA | 1 | 1 | 001-0378-9
2 | P | 112A | 82389 | JACK |  | EA | 1 | 1 | 001-0378-9
2 | P | PT02E-8-2P | 77820 | CONNECTOR |  | EA | 1 | 1 | 001-0378-9
2 | P | 1682-0412 | 19738 | RIVET |  | EA | 4 | 4 | 001-0378-9
2 | P | 9655-08 | 19738 | NUTSERT |  | EA | 6 | 6 | 001-0378-9
2 | P | MS24693-S25 |  | SCREW |  | EA | 2 | 2 | 001-0378-9
2 | A | 001-0375-1-A |  | BATTERY PACK |  | EA | 1 | 1 | 001-0378-9
3 | D | 001-0375-3-A |  | SIDE |  | EA | 2 | 2 | 001-0375-1
4 | R | 950-109 | 1AT51 | SHEET | .125X.542 | SH | .02 | .04
3 | D | 001-0375-5-A |  | COVER |  | EA | 2 | 2 | 001-0375-1
4 | R | 950-109 | 1AT51 | SHEET | .233X.542 | SH | .03 | .06
3 | R | RTV-102 | 01139 | ADHESIVE |  | TU | .01 | .01 | 001-0375-1
3 | D | 001-0375-7-A |  | END |  | EA | 2 | 2 | 001-0375-1
4 | R | 950-109 | 1AT51 | SHEET | .125X.183 | SF | .006 | .012
3 | S | 001-5048-A |  | BATTERY PACK |  | EA | 1 | 1 | 001-0375-1
2 | D | 001-0374-D |  | BRACKET |  | EA | 1 | 1 | 001-0378-9
3 | R | 6061-T6 .050 250/11 |  | SHEET | .193X.417 | SF | .080 | .08 | 001-0374
2 | D | 001-0373 |  | BRACKET |  | EA | 1 | 1 | 001-0378-9
3 | R | 6061-T6 .050 250/11 |  | SHEET | .073X.354 | SF | .026 | .026 | 001-0373
2 | D | 001-0372-C |  | BRACKET |  | EA | 1 | 1 | 001-0378-9
3 | R | 6061-T6 .050 250/11 |  | SHEET | .604X.718 | SF | .434 | .434 | 001-0372
2 | P | 1N5408 |  | DIODE |  | EA | 2 | 2 | 001-0378-9
2 | P | RCR32G390K |  | RESISTOR |  | EA | 1 | 1 | 001-0378-9
2 | P | 856 | 91833 | TERMINAL STRIP |  | EA | 1 | 1 | 001-0378-9
2 | P | 1506-102 | 83330 | TIP,JACK,RED |  | EA | 1 | 1 | 001-0378-9
2 | P | 1506-103 | 83330 | TIP,JACK,BLACK |  | EA | 1 | 1 | 001-0378-9
2 | P | MS35333-40 |  | WASHER |  | EA | 2 | 2 | 001-0378-9
2 | R | M16878/1BFE9 |  | WIRE,22,WHITE |  | FT | 1 | 1 | 001-0378-9
2 | P | MS20470A3-3 |  | RIVET |  | EA | 2 | 2 | 001-0378-9
2 | P | MS21083N06 |  | NUT |  | EA | 2 | 2 | 001-0378-9
2 | T | 001-0379-A |  | SCHEMATIC |  | EA | 1 | 1 | 001-0378-9
1 | A | 056-00379-9-E |  | SAFETY PLUG ASSY |  | EA | 1 | 1 | 001-3055-9
2 | D | 056-00379-1-E |  | PLUG |  | EA | 1 | 1 | 056-00379-9
3 | P | 240 | 82389 | PLUG |  | EA | 1 | 1 | 056-00379-1
2 | D | 056-00379-3-E |  | WEBBING |  | EA | 1 | 1 | 056-00379-9
3 | R | MIL-W-4088TYICL2RED |  | WEBBING,9/16W | .292 | YD | .292 | .292 | 056-00379-3
1 | T | 001-3091-B |  | SCHEMATIC |  | EA | 1 | 1 | 001-3055-9
1 | T | 001-5143-B |  | PROCEDURE,TEST |  | EA | 1 | 1 | 001-3055-9
1 | T | 001-5146-A |  | PROCEDURE,TEST |  | EA | 1 | 1 | 001-3055-9
1 | T | 001-5147-A |  | PROCEDURE,TEST |  | EA | 1 | 1 | 001-3055-9
