dmarlowe69/Hayes-Targets/TLX Technical Documents/Excel/Weight &Balance/TLX.XLS

Sheet: TLX-1
TLX-1 001-1060-19 Standard Configuration
ITEM | Unit Weight (gms) | Unit Weight (lb.) | Qty Next Assembly | Total Weight (gms) | Total Weight (lb.) | Moment Arm STA (in.) | MOMENT (in-gms) | MOMENT (in-lbs)
Nose Cone Assembly | 3170.00 | 6.99 | 1 | 3170.00 | 6.99 | 102.250 | 324132.500 | 714.712
Canard Assembly | 685.00 | 1.51 | 2 | 1370.00 | 3.02 | 141.000 | 193170.000 | 425.940
Plastic Fin Assemby | 435.00 | 0.96 | 5 | 2175.00 | 4.80 | 178.000 | 387150.000 | 853.666
Antenna Fin Assembly | 480.00 | 1.06 | 1 | 480.00 | 1.06 | 177.000 | 84960.000 | 187.337
Transmit Antenna | 35.00 | 0.08 | 1 | 35.00 | 0.08 | 169.000 | 5915.000 | 13.043
Tail Cone Assembly | 837.00 | 1.85 | 1 | 837.00 | 1.85 | 188.375 | 157669.875 | 347.662
Turbine | 359.00 | 0.79 | 1 | 359.00 | 0.79 | 193.750 | 69556.250 | 153.372
Body Tube Assembly | 17573.50 | 38.75 | 1 | 17573.50 | 38.75 | 141.360 | 2484187.812 | 5477.634
Fwd Body Ballast | 2947.85 | 6.50 | 1 | 2947.85 | 6.50 | 117.000 | 344897.959 | 760.500
 |  |  | Total | 28947.35 | 63.83 |  | 4051639.397 | 8933.865
 |  |  | XCG | 139.97 | 139.97
 |  |  | Range | 137 | 140
 |  |  | Desired | 140
Body Tube Assembly
ITEM | Unit Weight (gms) | Unit Weight (lb.) | Qty Next Assembly | Total Weight (gms) | Total Weight (lb.) | Moment Arm STA. (in.) | MOMENT (in-gms) | MOMENT (in-lb.)
Body Tube | 3318.00 | 7.32 | 1 | 3318.00 | 7.32 | 142.625 | 473229.750 | 1043.472
Tow Fitting | 95.00 | 0.21 | 1 | 95.00 | 0.21 | 137.000 | 13015.000 | 28.698
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
Fwd Body Ballast | 2947.85 | 6.50 | 1 | 2947.85 | 6.50 | 117.000 | 344897.959 | 760.500
Misc | 0.00 | 0.00 | 1 | 0.00 | 0.00 | 109.000 | 0.000 | 0.000
 |  |  | Total | 43900.23 | 96.80 |  | 6038507.483 | 13314.909
 |  |  | XCG | 137.55 | 137.55
 |  |  | Range | 137 | 140
 |  |  | Desired | 138

Sheet: TLX-1A
TLX-1A 001-3100-9 Scoring Configuration (extended Nose)
ITEM | Unit Weight (gms) | Unit Weight (lb.) | Qty Next Assembly | Total Weight (gms) | Total Weight (lb.) | Moment Arm STA (in.) | MOMENT (in-gms) | MOMENT (in-lbs)
Nose Cone Assembly | 3300.00 | 7.28 | 1 | 3300.00 | 7.28 | 99.000 | 326700.000 | 720.373
Canard Assembly | 685.00 | 1.51 | 2 | 1370.00 | 3.02 | 141.000 | 193170.000 | 425.940
Plastic Fin Assemby | 435.00 | 0.96 | 5 | 2175.00 | 4.80 | 178.000 | 387150.000 | 853.666
Antenna Fin Assembly | 480.00 | 1.06 | 1 | 480.00 | 1.06 | 177.000 | 84960.000 | 187.337
Transmit Antenna | 35.00 | 0.08 | 1 | 35.00 | 0.08 | 169.000 | 5915.000 | 13.043
Tail Cone Assembly | 837.00 | 1.85 | 1 | 837.00 | 1.85 | 188.375 | 157669.875 | 347.662
Turbine | 359.00 | 0.79 | 1 | 359.00 | 0.79 | 193.750 | 69556.250 | 153.372
Body Tube Assembly | 18585.50 | 40.98 | 1 | 18585.50 | 40.98 | 140.898 | 2618667.326 | 5774.161
Payload Tray with power module |  | 0.00 | 1 | 0.00 | 0.00 | 110.375 | 0.000 | 0.000
Ground Plane |  | 0.00 | 1 | 0.00 | 0.00 | 112.000 | 0.000 | 0.000
Scoring Unit |  | 0.00 | 1 | 0.00 | 0.00 | 111.000 | 0.000 | 0.000
Scoring Sensors |  | 0.00 | 4 | 0.00 | 0.00 | 103.000 | 0.000 | 0.000
Scoring Antenna Installtion |  | 0.00 | 1 | 0.00 | 0.00 | 111.000 | 0.000 | 0.000
Scoring Installtion Cables |  | 0.00 | 1 | 0.00 | 0.00 | 105.000 | 0.000 | 0.000
Fwd Body Ballast | 1927.44 | 4.25 | 1 | 1927.44 | 4.25 | 115.000 | 221655.329 | 488.750
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
Aft Body Ballast | 453.51 | 1.00 | 1 | 453.51 | 1.00 | 180.000 | 81632.653 | 180.000
Misc | 0.00 | 0.00 | 1 | 0.00 | 0.00 | 109.000 | 0.000 | 0.000
 |  |  | Total | 32929.46 | 72.71 |  | 4514563.344 | 9968.179
 |  |  | XCG | 137.10 | 137.10
 |  |  | Range | 137 | 140
 |  |  | Desired | 137

Sheet: TLX-1B
TLX-1B 001-3100-9 Extended Nose Cofiguration with Augmentation Controls
ITEM | Unit Weight (gms) | Unit Weight (lb.) | Qty Next Assembly | Total Weight (gms) | Total Weight (lb.) | Moment Arm STA (in.) | MOMENT (in-gms) | MOMENT (in-lbs)
Nose Cone Assembly | 3275.00 | 7.22 | 1 | 3275.00 | 7.22 | 102.000 | 334050.000 | 736.580
Canard Assembly | 685.00 | 1.51 | 2 | 1370.00 | 3.02 | 141.000 | 193170.000 | 425.940
Plastic Fin Assemby | 435.00 | 0.96 | 5 | 2175.00 | 4.80 | 178.000 | 387150.000 | 853.666
Antenna Fin Assembly | 480.00 | 1.06 | 1 | 480.00 | 1.06 | 177.000 | 84960.000 | 187.337
Transmit Antenna | 35.00 | 0.08 | 1 | 35.00 | 0.08 | 169.000 | 5915.000 | 13.043
Tail Cone Assembly | 837.00 | 1.85 | 1 | 837.00 | 1.85 | 188.375 | 157669.875 | 347.662
Turbine | 359.00 | 0.79 | 1 | 359.00 | 0.79 | 193.750 | 69556.250 | 153.372
Body Tube Assembly | 18585.50 | 40.98 | 1 | 18585.50 | 40.98 | 140.898 | 2618667.326 | 5774.161
Fwd Body Ballast | 1927.44 | 4.25 | 1 | 1927.44 | 4.25 | 115.000 | 221655.329 | 488.750
 |  |  | Total | 29043.94 | 64.04 |  | 4072793.779 | 8980.510
 |  |  | XCG | 140.23 | 140.23
 |  |  | Range | 137 | 140
 |  |  | Desired | 140
Body Tube Assembly
ITEM | Unit Weight (gms) | Unit Weight (lb.) | Qty Next Assembly | Total Weight (gms) | Total Weight (lb.) | Moment Arm STA. (in.) | MOMENT (in-gms) | MOMENT (in-lb.)
Body Tube | 3318.00 | 7.32 | 1 | 3318.00 | 7.32 | 142.625 | 473229.750 | 1043.472
Tow Fitting | 95.00 | 0.21 | 1 | 95.00 | 0.21 | 137.000 | 13015.000 | 28.698
Servo Unit Assembly | 7545.00 | 16.64 | 1 | 7545.00 | 16.64 | 144.875 | 1093081.875 | 2410.246
Computer | 2104.00 | 4.64 | 1 | 2104.00 | 4.64 | 123.250 | 259318.000 | 571.796
Accelerometer | 250.00 | 0.55 | 1 | 250.00 | 0.55 | 124.750 | 31187.500 | 68.768
Receiver | 305.50 | 0.67 | 1 | 305.50 | 0.67 | 128.750 | 39333.125 | 86.730
Altimeter Assembly | 1720.00 | 3.79 | 1 | 1720.00 | 3.79 | 123.250 | 211990.000 | 467.438
Fwd Door Doubler | 142.00 | 0.31 | 1 | 142.00 | 0.31 | 131.125 | 18619.750 | 41.057
Fwd Door | 107.00 | 0.24 | 1 | 107.00 | 0.24 | 131.125 | 14030.375 | 30.937
Aft Door Doubler | 142.00 | 0.31 | 1 | 142.00 | 0.31 | 157.224 | 22325.808 | 49.228
Aft Door (metal) | 170.00 | 0.37 | 1 | 170.00 | 0.37 | 157.224 | 26728.080 | 58.935
Bearing Bulkhead | 511.00 | 1.13 | 1 | 511.00 | 1.13 | 171.500 | 87636.500 | 193.238
Drive Shaft | 563.00 | 1.24 | 1 | 563.00 | 1.24 | 172.000 | 96836.000 | 213.523
Ground Plane | 152.00 | 0.34 | 1 | 152.00 | 0.34 | 169.000 | 25688.000 | 56.642
Double Launch Switch | 173.00 | 0.38 | 1 | 173.00 | 0.38 | 131.688 | 22781.938 | 50.234
Battery Pack | 655.00 | 1.44 | 1 | 655.00 | 1.44 | 122.125 | 79991.875 | 176.382
Battery Cable Assembly | 45.00 | 0.10 | 1 | 45.00 | 0.10 | 120.750 | 5433.750 | 11.981
Transmitter | 304.00 | 0.67 | 1 | 304.00 | 0.67 | 175.375 | 53314.000 | 117.557
Transmitter Coax | 55.00 | 0.12 | 1 | 55.00 | 0.12 | 171.000 | 9405.000 | 20.738
Transmitter Cable | 73.00 | 0.16 | 1 | 73.00 | 0.16 | 155.000 | 11315.000 | 24.950
Cable Tray | 28.00 | 0.06 | 1 | 28.00 | 0.06 | 159.500 | 4466.000 | 9.848
Receiver Cable | 28.00 | 0.06 | 1 | 28.00 | 0.06 | 130.000 | 3640.000 | 8.026
Receiver Coax | 100.00 | 0.22 | 1 | 100.00 | 0.22 | 153.000 | 15300.000 | 33.736
Misc | 0.00 | 0.00 | 1 | 0.00 | 0.00 | 0.000 | 0.000 | 0.000
 |  |  | Total | 18585.50 | 40.98 |  | 2618667.326 | 5774.161
 |  |  | XCG | 140.90 | 140.90
TLX-1B CHECK
ITEM | Unit Weight (gms) | Unit Weight (lb.) | Qty Next Assembly | Total Weight (gms) | Total Weight (lb.) | Moment Arm STA (in.) | MOMENT (in-gms) | MOMENT (in-lbs)
Basic Airframe | 29024.94 | 64.00 | 1 | 29024.94 | 64.04 | 140.229 | 4070130.229 | 8980.510
Misc | 0.00 | 0.00 | 1 | 0.00 | 0.00 | 109.000 | 0.000 | 0.000
 |  |  | Total | 29024.94 | 64.04 |  | 4070130.229 | 8980.510
 |  |  | XCG | 140.23 | 140.23
 |  |  | Range | 137 | 140
 |  |  | Desired | 139

Sheet: TLX-1 IR
TLX-1IR 001-3055-9
ITEM | Unit Weight (gms) | Unit Weight (lb.) | Qty Next Assembly | Total Weight (gms) | Total Weight (lb.) | Moment Arm STA (in.) | MOMENT (in-gms) | MOMENT (in-lbs)
Nose Cone Assembly | 9305.00 | 20.52 | 1 | 9305.00 | 20.52 | 98.625 | 917705.625 | 2023.541
Canard Assembly | 685.00 | 1.51 | 2 | 1370.00 | 3.02 | 141.000 | 193170.000 | 425.940
Plastic Fin Assemby | 435.00 | 0.96 | 5 | 2175.00 | 4.80 | 178.000 | 387150.000 | 853.666
Antenna Fin Assembly | 480.00 | 1.06 | 1 | 480.00 | 1.06 | 177.000 | 84960.000 | 187.337
Transmit Antenna | 35.00 | 0.08 | 1 | 35.00 | 0.08 | 169.000 | 5915.000 | 13.043
Tail Cone Assembly | 837.00 | 1.85 | 1 | 837.00 | 1.85 | 188.375 | 157669.875 | 347.662
Turbine | 359.00 | 0.79 | 1 | 359.00 | 0.79 | 193.750 | 69556.250 | 153.372
Body Tube Assembly | 22630.42 | 49.90 | 1 | 22630.42 | 49.90 | 145.834 | 3300284.037 | 7277.126
Fuel | 8299.32 | 18.30 | 1 | 8299.32 | 18.30 | 157.250 | 1305068.027 | 2877.675
APC-6 Assembly | 3551.00 | 7.83 | 1 | 3551.00 | 7.83 | 173.720 | 616879.720 | 1360.220
ignitors | 22.00 | 0.05 | 8 | 176.00 | 0.39 | 167.220 | 29430.720 | 64.895
Payload Tray with power module | 426.00 | 0.94 | 1 | 426.00 | 0.94 | 110.375 | 47019.750 | 103.679
Ground Plane | 118.00 | 0.26 | 1 | 118.00 | 0.26 | 112.000 | 13216.000 | 29.141
Scoring Unit | 1650.00 | 3.64 | 1 | 1650.00 | 3.64 | 111.000 | 183150.000 | 403.846
Scoring Sensors | 210.00 | 0.46 | 4 | 840.00 | 1.85 | 103.000 | 86520.000 | 190.777
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
Turbine | 359.00 | 0.79 | 1 | 359.00 | 0.79 | 193.750 | 69556.250 | 153.372
Body Tube Assembly | 22630.42 | 49.90 | 1 | 22630.42 | 49.90 | 145.834 | 3300284.037 | 7277.126
Fuel | 8299.32 | 18.30 | 0 | 0.00 | 0.00 | 157.250 | 0.000 | 0.000
APC-6 Assembly | 3551.00 | 7.83 | 1 | 3551.00 | 7.83 | 173.720 | 616879.720 | 1360.220
ignitors | 22.00 | 0.05 | 0 | 0.00 | 0.00 | 167.220 | 0.000 | 0.000
Payload Tray with power module | 426.00 | 0.94 | 1 | 426.00 | 0.94 | 110.375 | 47019.750 | 103.679
Ground Plane | 118.00 | 0.26 | 1 | 118.00 | 0.26 | 112.000 | 13216.000 | 29.141
Scoring Unit | 1650.00 | 3.64 | 0 | 0.00 | 0.00 | 111.000 | 0.000 | 0.000
Scoring Sensors | 210.00 | 0.46 | 0 | 0.00 | 0.00 | 103.000 | 0.000 | 0.000
Scoring Antenna Installtion | 100.00 | 0.22 | 0 | 0.00 | 0.00 | 111.000 | 0.000 | 0.000
Scoring Installtion Cables | 410.00 | 0.90 | 0 | 0.00 | 0.00 | 105.000 | 0.000 | 0.000
Fwd Body Ballast | 1927.44 | 4.25 | 1 | 1927.44 | 4.25 | 107.000 | 206235.828 | 454.750
Fwd Body Ballast | 1927.44 | 4.25 | 1 | 1927.44 | 4.25 | 109.000 | 210090.703 | 463.250
 |  |  | Total | 45141.30 | 99.54 |  | 6209852.787 | 13692.725
 |  |  | XCG | 137.56 | 137.56
 |  |  | Range | 135 | 140
 |  |  | Desired | 139

Sheet: TLX-1 IR NO POD
TLX-1IR 001-3055-9
ITEM | Unit Weight (gms) | Unit Weight (lb.) | Qty Next Assembly | Total Weight (gms) | Total Weight (lb.) | Moment Arm STA (in.) | MOMENT (in-gms) | MOMENT (in-lbs)
Nose Cone Assembly | 3862.82 | 8.52 | 1 | 3862.82 | 8.52 | 99.625 | 384833.754 | 848.558
Canard Assembly | 685.00 | 1.51 | 2 | 1370.00 | 3.02 | 141.000 | 193170.000 | 425.940
Plastic Fin Assemby | 435.00 | 0.96 | 5 | 2175.00 | 4.80 | 178.000 | 387150.000 | 853.666
Antenna Fin Assembly | 480.00 | 1.06 | 1 | 480.00 | 1.06 | 177.000 | 84960.000 | 187.337
Transmit Antenna | 35.00 | 0.08 | 1 | 35.00 | 0.08 | 169.000 | 5915.000 | 13.043
Tail Cone Assembly | 837.00 | 1.85 | 1 | 837.00 | 1.85 | 188.375 | 157669.875 | 347.662
Turbine | 359.00 | 0.79 | 1 | 359.00 | 0.79 | 193.750 | 69556.250 | 153.372
Body Tube Assembly | 22630.42 | 49.90 | 1 | 22630.42 | 49.90 | 145.834 | 3300284.037 | 7277.126
Fuel | 8299.32 | 18.30 | 0 | 0.00 | 0.00 | 157.250 | 0.000 | 0.000
APC-6 Assembly | 3551.00 | 7.83 | 0 | 0.00 | 0.00 | 173.720 | 0.000 | 0.000
ignitors | 22.00 | 0.05 | 0 | 0.00 | 0.00 | 167.220 | 0.000 | 0.000
Payload Tray with power module | 426.00 | 0.94 | 1 | 426.00 | 0.94 | 110.375 | 47019.750 | 103.679
Ground Plane | 118.00 | 0.26 | 1 | 118.00 | 0.26 | 112.000 | 13216.000 | 29.141
Scoring Unit | 1650.00 | 3.64 | 1 | 1650.00 | 3.64 | 111.000 | 183150.000 | 403.846
Scoring Sensors | 210.00 | 0.46 | 4 | 840.00 | 1.85 | 103.000 | 86520.000 | 190.777
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
Body Tube Assembly | 22630.42 | 49.90 | 1 | 22630.42 | 49.90 | 145.834 | 3300284.037 | 7277.126
Fuel | 8299.32 | 18.30 | 0 | 0.00 | 0.00 | 157.250 | 0.000 | 0.000
APC-6 Assembly | 3551.00 | 7.83 | 1 | 3551.00 | 7.83 | 173.720 | 616879.720 | 1360.220
ignitors | 22.00 | 0.05 | 0 | 0.00 | 0.00 | 167.220 | 0.000 | 0.000
Payload Tray with power module | 426.00 | 0.94 | 1 | 426.00 | 0.94 | 110.375 | 47019.750 | 103.679
Ground Plane | 118.00 | 0.26 | 1 | 118.00 | 0.26 | 112.000 | 13216.000 | 29.141
Scoring Unit | 1650.00 | 3.64 | 0 | 0.00 | 0.00 | 111.000 | 0.000 | 0.000
Scoring Sensors | 210.00 | 0.46 | 0 | 0.00 | 0.00 | 103.000 | 0.000 | 0.000
Scoring Antenna Installtion | 100.00 | 0.22 | 0 | 0.00 | 0.00 | 111.000 | 0.000 | 0.000
Scoring Installtion Cables | 410.00 | 0.90 | 0 | 0.00 | 0.00 | 105.000 | 0.000 | 0.000
Fwd Body Ballast | 1927.44 | 4.25 | 1 | 1927.44 | 4.25 | 107.000 | 206235.828 | 454.750
Fwd Body Ballast | 1927.44 | 4.25 | 1 | 1927.44 | 4.25 | 109.000 | 210090.703 | 463.250
 |  |  | Total | 45141.30 | 99.54 |  | 6209852.787 | 13692.725
 |  |  | XCG | 137.56 | 137.56
 |  |  | Range | 135 | 140
 |  |  | Desired | 139

Sheet: TLX-1 IR Navy
TLX-1IR 001-3055-9
ITEM | Unit Weight (gms) | Unit Weight (lb.) | Qty Next Assembly | Total Weight (gms) | Total Weight (lb.) | Moment Arm STA (in.) | MOMENT (in-gms) | MOMENT (in-lbs)
Nose Cone Assembly | 8870.00 | 19.56 | 1 | 8870.00 | 19.56 | 98.750 | 875912.500 | 1931.387
Canard Assembly | 685.00 | 1.51 | 2 | 1370.00 | 3.02 | 141.000 | 193170.000 | 425.940
Plastic Fin Assemby | 435.00 | 0.96 | 5 | 2175.00 | 4.80 | 178.000 | 387150.000 | 853.666
Antenna Fin Assembly | 480.00 | 1.06 | 1 | 480.00 | 1.06 | 177.000 | 84960.000 | 187.337
Transmit Antenna | 35.00 | 0.08 | 1 | 35.00 | 0.08 | 169.000 | 5915.000 | 13.043
Tail Cone Assembly | 837.00 | 1.85 | 1 | 837.00 | 1.85 | 188.375 | 157669.875 | 347.662
Turbine | 359.00 | 0.79 | 1 | 359.00 | 0.79 | 193.750 | 69556.250 | 153.372
Body Tube Assembly | 22630.42 | 49.90 | 1 | 22630.42 | 49.90 | 145.814 | 3299834.037 | 7276.134
Fuel | 8299.32 | 18.30 | 1 | 8299.32 | 18.30 | 157.250 | 1305068.027 | 2877.675
APC-6 Assembly | 3927.00 | 8.66 | 1 | 3927.00 | 8.66 | 173.970 | 683180.190 | 1506.412
ignitors | 22.00 | 0.05 | 8 | 176.00 | 0.39 | 167.220 | 29430.720 | 64.895
Payload Tray | 426.00 | 0.94 | 1 | 426.00 | 0.94 | 114.500 | 48777.000 | 107.553
C Band Beacon | 1275.50 | 2.81 | 1 | 1275.50 | 2.81 | 114.500 | 146044.750 | 322.029
Antenna | 50.00 | 0.11 | 1 | 50.00 | 0.11 | 114.500 | 5725.000 | 12.624
RF Cable | 50.00 | 0.11 | 4 | 200.00 | 0.44 | 114.500 | 22900.000 | 50.495
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
Fuel | 8299.32 | 18.30 | 0 | 0.00 | 0.00 | 157.250 | 0.000 | 0.000
APC-6 Assembly | 3551.00 | 7.83 | 1 | 3551.00 | 7.83 | 173.720 | 616879.720 | 1360.220
ignitors | 22.00 | 0.05 | 0 | 0.00 | 0.00 | 167.220 | 0.000 | 0.000
Payload Tray with power module | 426.00 | 0.94 | 1 | 426.00 | 0.94 | 110.375 | 47019.750 | 103.679
Ground Plane | 118.00 | 0.26 | 1 | 118.00 | 0.26 | 112.000 | 13216.000 | 29.141
Scoring Unit | 1650.00 | 3.64 | 0 | 0.00 | 0.00 | 111.000 | 0.000 | 0.000
Scoring Sensors | 210.00 | 0.46 | 0 | 0.00 | 0.00 | 103.000 | 0.000 | 0.000
Scoring Antenna Installtion | 100.00 | 0.22 | 0 | 0.00 | 0.00 | 111.000 | 0.000 | 0.000
Scoring Installtion Cables | 410.00 | 0.90 | 0 | 0.00 | 0.00 | 105.000 | 0.000 | 0.000
Fwd Body Ballast | 1927.44 | 4.25 | 1 | 1927.44 | 4.25 | 107.000 | 206235.828 | 454.750
Fwd Body Ballast | 1927.44 | 4.25 | 1 | 1927.44 | 4.25 | 109.000 | 210090.703 | 463.250
 |  |  | Total | 45141.30 | 99.54 |  | 6209402.787 | 13691.733
 |  |  | XCG | 137.55 | 137.55
 |  |  | Range | 135 | 140
 |  |  | Desired | 139

Sheet: TLX-1 IRF
TLX-1IRFlare 001-3000-9
ITEM | Unit Weight (gms) | Unit Weight (lb.) | Qty Next Assembly | Total Weight (gms) | Total Weight (lb.) | Moment Arm STA (in.) | MOMENT (in-gms) | MOMENT (in-lbs)
Nose Cone Assembly | 8977.00 | 19.79 | 1 | 8977.00 | 19.79 | 98.250 | 881990.250 | 1944.789
Canard Assembly | 685.00 | 1.51 | 2 | 1370.00 | 3.02 | 141.000 | 193170.000 | 425.940
Metal Tail Assembly | 1008.75 | 2.22 | 4 | 4035.00 | 8.90 | 178.000 | 718230.000 | 1583.697
Plastic Fin Assemby | 435.00 | 0.96 | 1 | 435.00 | 0.96 | 178.000 | 77430.000 | 170.733
Antenna Fin Assembly | 480.00 | 1.06 | 1 | 480.00 | 1.06 | 177.000 | 84960.000 | 187.337
Transmit Antenna | 35.00 | 0.08 | 1 | 35.00 | 0.08 | 169.000 | 5915.000 | 13.043
Tail Cone Assembly | 837.00 | 1.85 | 1 | 837.00 | 1.85 | 188.375 | 157669.875 | 347.662
Turbine | 359.00 | 0.79 | 1 | 359.00 | 0.79 | 193.750 | 69556.250 | 153.372
Body Tube Assembly | 20493.50 | 45.19 | 1 | 20493.50 | 45.19 | 141.315 | 2896048.464 | 6385.787
Flare Mount | 3933.00 | 8.67 | 1 | 3933.00 | 8.67 | 154.825 | 608926.725 | 1342.683
Flares (1150gms or 1050gms) | 1150.00 | 2.54 | 6 | 6900.00 | 15.21 | 154.745 | 1067740.500 | 2354.368
Scoring Unit | 1650.00 | 3.64 | 1 | 1650.00 | 3.64 | 111.000 | 183150.000 | 403.846
Scoring Sensors | 210.00 | 0.46 | 4 | 840.00 | 1.85 | 103.000 | 86520.000 | 190.777
Scoring Antenna Installtion | 100.00 | 0.22 | 1 | 100.00 | 0.22 | 111.000 | 11100.000 | 24.476
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
Fwd Body Ballast | 1927.44 | 4.25 | 1 | 1927.44 | 4.25 | 107.000 | 206235.828 | 454.750
Misc | 0.00 | 0.00 | 1 | 0.00 | 0.00 | 109.000 | 0.000 | 0.000
 |  |  | Total | 52779.82 | 116.38 |  | 7291405.851 | 16077.550
 |  |  | XCG | 138.15 | 138.15
 |  |  | Range | 137 | 140
 |  |  | Desired | 138

Sheet: TGX-2
TGX-2 001-0300-9
ITEM | Unit Weight (gms) | Unit Weight (lb.) | Qty Next Assembly | Total Weight (gms) | Total Weight (lb.) | Moment Arm STA (in.) | MOMENT (in-gms) | MOMENT (in-lbs)
Nose Cone Assembly | 1547.00 | 3.41 | 1 | 1547.00 | 3.41 | 98.250 | 151992.750 | 335.144
Plastic Fin Assemby | 435.00 | 0.96 | 6 | 2610.00 | 5.76 | 156.500 | 408465.000 | 900.665
Tail Cone Assembly | 782.00 | 1.72 | 1 | 782.00 | 1.72 | 169.250 | 132353.500 | 291.839
Turbine | 359.00 | 0.79 | 1 | 359.00 | 0.79 | 174.750 | 62735.250 | 138.331
Body Tube Assembly | 10777.00 | 23.76 | 1 | 10777.00 | 23.76 | 132.366 | 1426509.000 | 3145.452
Fwd Body Ballast | 4535.15 | 10.00 | 1 | 4535.15 | 10.00 | 103.281 | 468394.558 | 1032.810
 |  |  | Total | 20610.15 | 45.45 |  | 2650450.058 | 5844.242
 |  |  | XCG | 128.60 | 128.60
 |  |  | Range | 128 | 129
 |  |  | Desired | 128.5
Body Tube Assembly
ITEM | Unit Weight (gms) | Unit Weight (lb.) | Qty Next Assembly | Total Weight (gms) | Total Weight (lb.) | Moment Arm STA. (in.) | MOMENT (in-gms) | MOMENT (in-lb.)
Body Tube/Hardback | 3813.00 | 8.41 | 1 | 3813.00 | 8.41 | 130.000 | 495690.000 | 1092.996
Tow Fitting
HardBack
Alternator | 4328.00 | 9.54 | 1 | 4328.00 | 9.54 | 135.375 | 585903.000 | 1291.916
Electronic Bulkhead | 1640.00 | 3.62 | 1 | 1640.00 | 3.62 | 109.500 | 179580.000 | 395.974
Bearing Bulkhead/Drive Shaft | 996.00 | 2.20 | 1 | 996.00 | 2.20 | 166.000 | 165336.000 | 364.566
Drive Shaft
Launch Switch
Misc | 0.00 | 0.00 | 1 | 0.00 | 0.00 | 0.000 | 0.000 | 0.000
 |  |  | Total | 10777.00 | 23.76 |  | 1426509.000 | 3145.452
 |  |  | XCG | 132.37 | 132.37
TGX-2 CHECK
ITEM | Unit Weight (gms) | Unit Weight (lb.) | Qty Next Assembly | Total Weight (gms) | Total Weight (lb.) | Moment Arm STA (in.) | MOMENT (in-gms) | MOMENT (in-lbs)
Nose Cone Assembly | 1547.00 | 3.41 | 1 | 1547.00 | 3.41 | 98.250 | 151992.750 | 335.144
Fuselage Assembly | 11483.00 | 25.32 | 1 | 11483.00 | 25.32 | 135.375 | 1554511.125 | 3427.697
Plastic Fin Assembly | 435.00 | 0.96 | 6 | 2610.00 | 5.76 | 156.500 | 408465.000 | 900.665
Turbine | 359.00 | 0.79 | 1 | 359.00 | 0.79 | 174.750 | 62735.250 | 138.331
Fwd Body Ballast | 4535.15 | 10.00 | 1 | 4535.15 | 10.00 | 103.000 | 467120.181 | 1030.000
Misc | 0.00 | 0.00 | 1 | 0.00 | 0.00 | 100.000 | 0.000 | 0.000
 |  |  | Total | 20534.15 | 45.28 |  | 2644824.306 | 5831.838
 |  |  | XCG | 128.80 | 128.80
 |  |  | Range | 128 | 129
 |  |  | Desired | 128.5

Sheet: TGX-2A
TGX-2 001-0300-9
ITEM | Unit Weight (gms) | Unit Weight (lb.) | Qty Next Assembly | Total Weight (gms) | Total Weight (lb.) | Moment Arm STA (in.) | MOMENT (in-gms) | MOMENT (in-lbs)
Nose Cone Assembly | 1547.00 | 3.41 | 1 | 1547.00 | 3.41 | 98.250 | 151992.750 | 335.144
Plastic Fin Assemby | 435.00 | 0.96 | 6 | 2610.00 | 5.76 | 156.500 | 408465.000 | 900.665
Tail Cone Assembly | 782.00 | 1.72 | 1 | 782.00 | 1.72 | 169.250 | 132353.500 | 291.839
Turbine | 359.00 | 0.79 | 1 | 359.00 | 0.79 | 174.750 | 62735.250 | 138.331
Body Tube Assembly | 10777.00 | 23.76 | 1 | 10777.00 | 23.76 | 132.366 | 1426509.000 | 3145.452
Saber CPU | 2057.00 | 4.54 | 1 | 2057.00 | 4.54 | 113.109 | 232665.213 | 513.027
Saber Tray | 268.00 | 0.59 | 1 | 268.00 | 0.59 | 113.109 | 30313.212 | 66.841
Battery and Cable | 1787.00 | 3.94 | 0 | 0.00 | 0.00 | 113.109 | 0.000 | 0.000
antenna | 30.00 | 0.07 | 1 | 30.00 | 0.07 | 128.344 | 3850.320 | 8.490
antenna cable | 43.00 | 0.09 | 1 | 43.00 | 0.09 | 120.727 | 5191.239 | 11.447
microphones and mounts | 448.50 | 0.99 | 4 | 1794.00 | 3.96 | 118.375 | 212364.750 | 468.264
mic cables | 54.00 | 0.12 | 4 | 216.00 | 0.48 | 115.742 | 25000.272 | 55.126
Fwd Body Ballast | 2104.31 | 4.64 | 1 | 2104.31 | 4.64 | 103.281 | 217335.075 | 479.224
 |  |  | Total | 22587.31 | 49.81 |  | 2908775.581 | 6413.850
 |  |  | XCG | 128.78 | 128.78
 |  |  | Range | 128 | 129
 |  |  | Desired | 128.5
Body Tube Assembly
ITEM | Unit Weight (gms) | Unit Weight (lb.) | Qty Next Assembly | Total Weight (gms) | Total Weight (lb.) | Moment Arm STA. (in.) | MOMENT (in-gms) | MOMENT (in-lb.)
Body Tube/Hardback | 3813.00 | 8.41 | 1 | 3813.00 | 8.41 | 130.000 | 495690.000 | 1092.996
Tow Fitting
HardBack
Alternator | 4328.00 | 9.54 | 1 | 4328.00 | 9.54 | 135.375 | 585903.000 | 1291.916
Electronic Bulkhead | 1640.00 | 3.62 | 1 | 1640.00 | 3.62 | 109.500 | 179580.000 | 395.974
Bearing Bulkhead/Drive Shaft | 996.00 | 2.20 | 1 | 996.00 | 2.20 | 166.000 | 165336.000 | 364.566
Drive Shaft
Launch Switch
Misc | 0.00 | 0.00 | 1 | 0.00 | 0.00 | 0.000 | 0.000 | 0.000
 |  |  | Total | 10777.00 | 23.76 |  | 1426509.000 | 3145.452
 |  |  | XCG | 132.37 | 132.37
TGX-2 CHECK
ITEM | Unit Weight (gms) | Unit Weight (lb.) | Qty Next Assembly | Total Weight (gms) | Total Weight (lb.) | Moment Arm STA (in.) | MOMENT (in-gms) | MOMENT (in-lbs)
Nose Cone Assembly | 1547.00 | 3.41 | 1 | 1547.00 | 3.41 | 98.250 | 151992.750 | 335.144
Fuselage Assembly | 11483.00 | 25.32 | 1 | 11483.00 | 25.32 | 135.375 | 1554511.125 | 3427.697
Plastic Fin Assembly | 435.00 | 0.96 | 6 | 2610.00 | 5.76 | 156.500 | 408465.000 | 900.665
Turbine | 359.00 | 0.79 | 1 | 359.00 | 0.79 | 174.750 | 62735.250 | 138.331
Fwd Body Ballast | 4535.15 | 10.00 | 1 | 4535.15 | 10.00 | 103.000 | 467120.181 | 1030.000
Misc | 0.00 | 0.00 | 1 | 0.00 | 0.00 | 100.000 | 0.000 | 0.000
 |  |  | Total | 20534.15 | 45.28 |  | 2644824.306 | 5831.838
 |  |  | XCG | 128.80 | 128.80
 |  |  | Range | 128 | 129
 |  |  | Desired | 128.5

Sheet: TGX-6A
TGX-2 001-0300-9
ITEM | Unit Weight (gms) | Unit Weight (lb.) | Qty Next Assembly | Total Weight (gms) | Total Weight (lb.) | Moment Arm STA (in.) | MOMENT (in-gms) | MOMENT (in-lbs)
Nose Cone Assembly | 1547.00 | 3.41 | 1 | 1547.00 | 3.41 | 98.250 | 151992.750 | 335.144
Plastic Fin Assemby | 435.00 | 0.96 | 6 | 2610.00 | 5.76 | 156.500 | 408465.000 | 900.665
Tail Cone Assembly | 782.00 | 1.72 | 1 | 782.00 | 1.72 | 169.250 | 132353.500 | 291.839
Turbine | 359.00 | 0.79 | 1 | 359.00 | 0.79 | 174.750 | 62735.250 | 138.331
Body Tube Assembly | 10777.00 | 23.76 | 1 | 10777.00 | 23.76 | 137.910 | 1486256.000 | 3277.194
Payload Tray with power module | 545.00 | 1.20 | 1 | 545.00 | 1.20 | 104.875 | 57156.875 | 126.031
Ground Plane | 25.00 | 0.06 | 1 | 25.00 | 0.06 | 107.000 | 2675.000 | 5.898
Scoring Unit | 1650.00 | 3.64 | 1 | 1650.00 | 3.64 | 106.000 | 174900.000 | 385.654
Scoring Sensors | 210.00 | 0.46 | 4 | 840.00 | 1.85 | 103.000 | 86520.000 | 190.777
Scoring Antenna Installtion | 100.00 | 0.22 | 1 | 100.00 | 0.22 | 106.000 | 10600.000 | 23.373
Scoring Installtion Cables | 410.00 | 0.90 | 1 | 410.00 | 0.90 | 103.000 | 42230.000 | 93.117
Fwd Body Ballast | 4535.15 | 10.00 | 1 | 4535.15 | 10.00 | 108.500 | 492063.492 | 1085.000
 |  |  | Total | 24180.15 | 53.32 |  | 3107947.867 | 6853.025
 |  |  | XCG | 128.53 | 128.53
 |  |  | Range | 128 | 129
 |  |  | Desired | 128.5
Body Tube Assembly
ITEM | Unit Weight (gms) | Unit Weight (lb.) | Qty Next Assembly | Total Weight (gms) | Total Weight (lb.) | Moment Arm STA. (in.) | MOMENT (in-gms) | MOMENT (in-lb.)
Body Tube/Hardback | 3813.00 | 8.41 | 1 | 3813.00 | 8.41 | 130.000 | 495690.000 | 1092.996
Tow Fitting
HardBack
Alternator | 4328.00 | 9.54 | 1 | 4328.00 | 9.54 | 139.375 | 603215.000 | 1330.089
Electronic Bulkhead | 1640.00 | 3.62 | 1 | 1640.00 | 3.62 | 135.375 | 222015.000 | 489.543
Bearing Bulkhead/Drive Shaft | 996.00 | 2.20 | 1 | 996.00 | 2.20 | 166.000 | 165336.000 | 364.566
Drive Shaft
Launch Switch
Misc | 0.00 | 0.00 | 1 | 0.00 | 0.00 | 0.000 | 0.000 | 0.000
 |  |  | Total | 10777.00 | 23.76 |  | 1486256.000 | 3277.194
 |  |  | XCG | 137.91 | 137.91
TGX-2 CHECK
ITEM | Unit Weight (gms) | Unit Weight (lb.) | Qty Next Assembly | Total Weight (gms) | Total Weight (lb.) | Moment Arm STA (in.) | MOMENT (in-gms) | MOMENT (in-lbs)
Nose Cone Assembly | 1547.00 | 3.41 | 1 | 1547.00 | 3.41 | 98.250 | 151992.750 | 335.144
Fuselage Assembly | 11483.00 | 25.32 | 1 | 11483.00 | 25.32 | 138.000 | 1584654.000 | 3494.162
Plastic Fin Assembly | 435.00 | 0.96 | 6 | 2610.00 | 5.76 | 156.500 | 408465.000 | 900.665
Turbine | 359.00 | 0.79 | 1 | 359.00 | 0.79 | 174.750 | 62735.250 | 138.331
Payload Tray with power module | 545.00 | 1.20 | 1 | 545.00 | 1.20 | 104.875 | 57156.875 | 126.031
Ground Plane | 25.00 | 0.06 | 1 | 25.00 | 0.06 | 107.000 | 2675.000 | 5.898
Scoring Unit | 1650.00 | 3.64 | 1 | 1650.00 | 3.64 | 106.000 | 174900.000 | 385.654
Scoring Sensors | 210.00 | 0.46 | 4 | 840.00 | 1.85 | 103.000 | 86520.000 | 190.777
Scoring Antenna Installtion | 100.00 | 0.22 | 1 | 100.00 | 0.22 | 106.000 | 10600.000 | 23.373
Scoring Installtion Cables | 410.00 | 0.90 | 1 | 410.00 | 0.90 | 103.000 | 42230.000 | 93.117
Fwd Body Ballast | 4535.15 | 10.00 | 1 | 4535.15 | 10.00 | 108.500 | 492063.492 | 1085.000
Misc | 0.00 | 0.00 | 1 | 0.00 | 0.00 | 100.000 | 0.000 | 0.000
 |  |  | Total | 24104.15 | 53.15 |  | 3073992.367 | 6778.153
 |  |  | XCG | 127.53 | 127.53
 |  |  | Range | 128 | 129
 |  |  | Desired | 128.5

Sheet: TLX-DUMMY
item | weight | arm | moment | lbs | oz | total
airframe | 33 | 153.375 | 5061.375 | 7 | 12 | 7.75
ballast | 7.25 | 103.5 | 750.375 | 7 | 8 | 7.5
ballast | 0 | 0 | 0 | 7 | 12 | 7.75
ballast | 0 | 0 | 0 | 8 | 0 | 8
ballast | 0 | 0 | 0 | 8 | 0 | 8
ballast | 15.5 | 108.5 | 1681.75 | 7 | 4 | 7.25
ballast | 0 | 0 | 0 | 7 | 0 | 7
ballast | 16 | 157 | 2512 |  |  | 0
ballast | 7 | 178.5 | 1249.5 |  |  | 0
 |  |  |  |  | total | 53.25
total | 78.75 |  | 11255 |  | airframe | 33
 |  |  |  |  | total | 86.25
XCG | 142.9206349

Sheet: TPT-6A
TPT-6A
ITEM | Unit Weight (gms) | Unit Weight (lb.) | Qty Next Assembly | Total Weight (gms) | Total Weight (lb.) | Moment Arm STA (in.) | MOMENT (in-gms) | MOMENT (in-lbs)
Nose Cone Assembly | 4452.00 | 9.82 | 1 | 4452.00 | 9.82 | 96.000 | 427392.000 | 942.399
Plastic Fin Assemby | 435.00 | 0.96 | 6 | 2610.00 | 5.76 | 167.500 | 437175.000 | 963.971
Body Tube Assembly | 18196.50 | 40.12 | 1 | 18196.50 | 40.12 | 144.757 | 2634071.945 | 5808.129
Fuel | 10204.08 | 22.50 | 1 | 10204.08 | 22.50 | 128.562 | 1311862.245 | 2892.656
ignitors | 22.00 | 0.05 | 8 | 176.00 | 0.39 | 167.220 | 29430.720 | 64.895
Scoring Unit | 4249.50 | 9.37 | 1 | 4249.50 | 9.37 | 108.500 | 461070.750 | 1016.661
 |  |  | Total | 39888.08 | 87.95 |  | 5301002.660 | 11688.711
 |  |  | XCG | 132.90 | 132.90
 |  |  | Range | 135 | 140
 |  |  | Desired | 139
Body Tube Assembly
ITEM | Unit Weight (gms) | Unit Weight (lb.) | Qty Next Assembly | Total Weight (gms) | Total Weight (lb.) | Moment Arm STA. (in.) | MOMENT (in-gms) | MOMENT (in-lb.)
Body Tube | 3225.00 | 7.11 | 1 | 3225.00 | 7.11 | 136.000 | 438600.000 | 967.113
Tow Fitting | 97.00 | 0.21 | 1 | 97.00 | 0.21 | 134.000 | 12998.000 | 28.661
InterStructure | 890.50 | 1.96 | 1 | 890.50 | 1.96 | 135.120 | 120324.360 | 265.315
Receiver Assembly | 3107.00 | 6.85 | 1 | 3107.00 | 6.85 | 151.830 | 471735.810 | 1040.177
Access Door | 250.00 | 0.55 | 1 | 250.00 | 0.55 | 151.830 | 37957.500 | 83.696
Mounting Rails | 187.00 | 0.41 | 2 | 374.00 | 0.82 | 153.550 | 57427.700 | 126.628
Burn Tube, bulkhead and HME | 2174.00 | 4.79 | 1 | 2174.00 | 4.79 | 179.250 | 389689.500 | 859.265
fin mount ring | 87.00 | 0.19 | 1 | 87.00 | 0.19 | 166.000 | 14442.000 | 31.845
end mount ring | 192.00 | 0.42 | 1 | 192.00 | 0.42 | 174.470 | 33498.240 | 73.864
Half Bulkhead | 194.50 | 0.43 | 1 | 194.50 | 0.43 | 161.940 | 31497.330 | 69.452
nitrogen Tank | 819.00 | 1.81 | 1 | 819.00 | 1.81 | 151.830 | 124348.770 | 274.189
nitrogen tank with wire | 847.50 | 1.87 | 1 | 847.50 | 1.87 | 151.830 | 128675.925 | 283.730
air scoop | 302.00 | 0.67 | 1 | 302.00 | 0.67 | 151.830 | 45852.660 | 101.105
side scoop | 11.50 | 0.03 | 2 | 23.00 | 0.05 | 151.830 | 3492.090 | 7.700
pressure gauge | 238.00 | 0.52 | 1 | 238.00 | 0.52 | 160.000 | 38080.000 | 83.966
Double Launch Switch | 152.00 | 0.34 | 1 | 152.00 | 0.34 | 123.120 | 18714.240 | 41.265
Fuel Tank | 4799.00 | 10.58 | 1 | 4799.00 | 10.58 | 126.180 | 605537.820 | 1335.211
Misc | 425.00 | 0.94 | 1 | 425.00 | 0.94 | 144.000 | 61200.000 | 134.946
 |  |  | Total | 18196.50 | 40.12 |  | 2634071.945 | 5808.129
 |  |  | XCG | 144.76 | 144.76

Sheet: TPT-7A
TPT-7A
ITEM | Unit Weight (gms) | Unit Weight (lb.) | Qty Next Assembly | Total Weight (gms) | Total Weight (lb.) | Moment Arm STA (in.) | MOMENT (in-gms) | MOMENT (in-lbs)
Nose Cone Assembly | 500.00 | 1.10 | 1 | 500.00 | 1.10 | 99.000 | 49500.000 | 109.148
Plastic Fin Assemby | 435.00 | 0.96 | 6 | 2610.00 | 5.76 | 179.500 | 468495.000 | 1033.031
Body Tube Assembly | 40527.00 | 89.36 | 1 | 40527.00 | 89.36 | 151.351 | 6133806.265 | 13525.043
Fuel | 9977.32 | 22.00 | 1 | 9977.32 | 22.00 | 131.500 | 1312018.141 | 2893.000
ignitors | 22.00 | 0.05 | 4 | 88.00 | 0.19 | 179.220 | 15771.360 | 34.776
Scoring Unit | 4249.50 | 9.37 | 1 | 4249.50 | 9.37 | 108.000 | 458946.000 | 1011.976
 |  |  | Total | 57951.82 | 127.78 |  | 8438536.766 | 18606.974
 |  |  | XCG | 145.61 | 145.61
 |  |  | Range | 145 | 150
 |  |  | Desired | 139
Body Tube Assembly
ITEM | Unit Weight (gms) | Unit Weight (lb.) | Qty Next Assembly | Total Weight (gms) | Total Weight (lb.) | Moment Arm STA. (in.) | MOMENT (in-gms) | MOMENT (in-lb.)
Body Tube | 3225.00 | 7.11 | 1 | 3225.00 | 7.11 | 148.000 | 477300.000 | 1052.447
Tow Fitting | 97.00 | 0.21 | 1 | 97.00 | 0.21 | 146.000 | 14162.000 | 31.227
InterStructure | 1000.00 | 2.21 | 1 | 1000.00 | 2.21 | 147.120 | 147120.000 | 324.400
Receiver Assembly | 3107.00 | 6.85 | 1 | 3107.00 | 6.85 | 151.830 | 471735.810 | 1040.177
Access Door | 250.00 | 0.55 | 1 | 250.00 | 0.55 | 151.830 | 37957.500 | 83.696
Mounting Rails | 187.00 | 0.41 | 2 | 374.00 | 0.82 | 153.550 | 57427.700 | 126.628
Burn Tube, bulkhead and HME | 2174.00 | 4.79 | 1 | 2174.00 | 4.79 | 191.250 | 415777.500 | 916.789
fin mount ring | 87.00 | 0.19 | 1 | 87.00 | 0.19 | 178.000 | 15486.000 | 34.147
end mount ring | 192.00 | 0.42 | 1 | 192.00 | 0.42 | 186.470 | 35802.240 | 78.944
Half Bulkhead | 194.50 | 0.43 | 1 | 194.50 | 0.43 | 173.940 | 33831.330 | 74.598
nitrogen Tank | 819.00 | 1.81 | 1 | 819.00 | 1.81 | 163.830 | 134176.770 | 295.860
nitrogen tank with wire | 847.50 | 1.87 | 1 | 847.50 | 1.87 | 163.830 | 138845.925 | 306.155
air scoop | 302.00 | 0.67 | 1 | 302.00 | 0.67 | 163.830 | 49476.660 | 109.096
side scoop | 11.50 | 0.03 | 2 | 23.00 | 0.05 | 163.830 | 3768.090 | 8.309
pressure gauge | 238.00 | 0.52 | 1 | 238.00 | 0.52 | 172.000 | 40936.000 | 90.264
battery pack | 1587.00 | 3.50 | 1 | 1587.00 | 3.50 | 160.000 | 253920.000 | 559.894
Double Launch Switch | 152.00 | 0.34 | 1 | 152.00 | 0.34 | 123.120 | 18714.240 | 41.265
Fuel Tank | 4799.00 | 10.58 | 1 | 4799.00 | 10.58 | 131.500 | 631068.500 | 1391.506
Tow Reel (7 inch) | 3400.00 | 7.50 | 1 | 3400.00 | 7.50 | 150.000 | 510000.000 | 1124.550
Cable (full of steel) | 17234.00 | 38.00 | 1 | 17234.00 | 38.00 | 150.000 | 2585100.000 | 5700.145
Misc | 425.00 | 0.94 | 1 | 425.00 | 0.94 | 144.000 | 61200.000 | 134.946
 |  |  | Total | 40527.00 | 89.36 |  | 6133806.265 | 13525.043
 |  |  | XCG | 151.35 | 151.35
