dmarlowe69/Hayes-Targets/(list of files, cad)

Other CAD files:
Meggitt/TLX386/TLX_HK.obj
Microsoft C 5.1/STDBUS/UTILITY.OBJ
Quick C/CABLE/SCRDUMP.OBJ
Quick C/HCABLE/PRINT6.OBJ
Quick C/SWAP/SPAWN/SPAWNTP.OBJ
Quick C/SWAP/SWAP/SWAPTEST.OBJ
Quick C/SWAP/SWAP300/SWAPTEST.OBJ
Quick C/SWAP/SWAPMOD/SWAPS.OBJ
Quick C/TRX12CAB/MENU.OBJ
tlx reduxe/tlx.obj
Meggitt/TLX386/ROM.obj
Microsoft C 5.1/STDBUS/CMD_TM.OBJ
Quick C/CABLE/CABCHART.OBJ
Quick C/HCABLE/DATAFILE.OBJ
Quick C/SWAP/SWAP/SWAPC.OBJ
Quick C/SWAP/SWAP300/SWAPS.OBJ
Quick C/SWAP/SWAPMOD/SWAPTEST.OBJ
Quick C/TRX12CAB/MOUSE.OBJ
tlx reduxe/DSPIO.obj
Microsoft C 5.1/STDBUS/PILOT.OBJ
Quick C/CABLE/SWAPL.OBJ
Quick C/HCABLE/DESIGN6.OBJ
Quick C/SWAP/SWAP/SWAPM.OBJ
Quick C/SWAP/SWAP300/SWAPM.OBJ
Quick C/SWAP/SWAPMOD/SWAPC.OBJ
Quick C/TRX12CAB/CABCALC.OBJ
tlx reduxe/AIODRV.obj
Microsoft C 5.1/STDBUS/UART_CMD.OBJ
Quick C/CABLE/CABCALC2.OBJ
Quick C/HCABLE/REVS.OBJ
Quick C/SWAP/SWAP/SWAPL.OBJ
Quick C/SWAP/SWAP300/SWAPC.OBJ
Quick C/SWAP/SWAPMOD/SWAPL.OBJ
Quick C/TRX12CAB/CABINPUT.OBJ
tlx reduxe/tlxpilot.obj
Microsoft C 5.1/STDBUS/TLX.OBJ
Quick C/CABLE/MOUSE.OBJ
Quick C/HCABLE/DESIGN.OBJ
Quick C/SWAP/SWAP/SWAPS.OBJ
Quick C/SWAP/SWAP300/SWAPL.OBJ
Quick C/SWAP/SWAPMOD/SWAPM.OBJ
Quick C/TRX12CAB/CABWORK.OBJ
tlx reduxe/ICU.obj
Microsoft C 5.1/STDBUS/GROUND.OBJ
Quick C/CABLE/CABLE.OBJ
Quick C/HCABLE/TESTDATA.OBJ
Quick C/TRX12CAB/CABEXCEL.OBJ
tlx reduxe/GROUND.obj
Microsoft C 5.1/STDBUS/MONLOOP.OBJ
Quick C/CABLE/CABEXCEL.OBJ
Quick C/HCABLE/DESIGNST.OBJ
Quick C/TRX12CAB/CABLE.OBJ
tlx reduxe/TCU.obj
Microsoft C 5.1/STDBUS/PLATFORM.OBJ
Quick C/CABLE/CABWORK.OBJ
Quick C/HCABLE/ANALYSIS.OBJ
Quick C/TRX12CAB/CABPRINT.OBJ
tlx reduxe/AIOTCU.obj
Quick C/CABLE/CABCALC.OBJ
Quick C/HCABLE/HCABLE.OBJ
Quick C/TRX12CAB/MSC.OBJ
Quick C/CABLE/CABINPUT.OBJ
Quick C/HCABLE/AIRFRAME.OBJ
Quick C/TRX12CAB/CABCHART.OBJ
Quick C/CABLE/MSC.OBJ
Quick C/CABLE/EDITOR.OBJ
Quick C/CABLE/SHELL.OBJ
Quick C/CABLE/CABPRINT.OBJ
Quick C/CABLE/MENU.OBJ
