dmarlowe69/Hayes-Targets/(list of files, drawings)

Other design files:
orcad/DIGAPC6/ORCADESP.PCB
orcad/FLARE/ORCADESP.PCB
orcad/RTX/ORCADESP.PCB
orcad/SERVOAMP/ORCADESP.PCB
orcad/TLXAPC6/ORCADESP.PCB
orcad/TLXIFACE/ORCADESP.PCB
orcad/Tlxirpod/ORCADESP.PCB
orcad/TLXNEW/ORCADESP.PCB
