dmarlowe69/Hayes-Targets/(commit log)

2016-11-10 RCA 1802 Related Software Development
    Hayes Targets Historical Preservation
    [27XXX.CFG, TYPE.CFG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]
2016-11-11 TLX Upgrades
    Upgrades due to obsolence issues
    [0010378.xls, 0010384.xls, 0011060V.XLS, 0011117.xls, 0013055.xls, 0013061.xls, 0013067.xls, 05600379.xls]
2016-11-11 Artwork
    Concept and prodution drawings
    [TLXRDATA.XLS, TLX_DATA.XLS, TLX_DATA_Report.xls]
2016-11-14 Cable Desgin Software
    Programs written in Microsoft Quick Basic
    [TRACK.XLS]
2016-11-14 Flight Data
    Flight Data Captures and Analysis
    [27XXX.CFG, AIRFRAME.OBJ, ANALYSIS.OBJ, CABCALC.OBJ, CABCALC2.OBJ, CABCHART.OBJ, CABEXCEL.OBJ, CABINPUT.OBJ]
2016-11-14 TLX-1/IR Design Files
    The TLX-1/IR was a variant that featured an IR generating POD
    [FILES.CFG, FLARE.SCH, FLAREBRD.SCH, IGNITOR.SCH, INPUT.SCH, ORCADESP.PCB, OUTPUT.SCH, PCB.CFG]
2016-11-14 TLX Addtional Files
    Radio Programming, 1802 -> 386sx, etc.
    [001-0380.BRD, 001-0380.SCH, 001-1234.SCH, 001-1288.BRD, 001-1288.SCH, 001-1376.BRD, 0011376a.brd, 0011378a.sch]
2016-11-28 TLX Technical Documents
    I worked for Hayes Targets from 1982 until they closed their doors in
    November 1999 One on my creations was the TLX-1 Low Altitude Tow Target
    The autopilot was built around an RCA 1802 COSMAC System. The
    development systems was cassette tape based.
    Once the project went into production I transfered development to an
    American Automation CrossAssembler Systems and I captured the
    source code and transferred it to the PC based tool.
    These files are WordPerfect and Excel Files, test procedures, thechnical
    reports andmarketing proposals.
    Denton Marlowe
    November 2016
    [IDECMCD.XLS, IDECMCD1.XLS, IDECMCD2.XLS, IDECMCDB.XLS, STABLE.XLS, TLX.XLS, TLXIR.XLS, TLXIRF.XLS]
